HarshJain/bmsafe/Slave_v2/Livrables/FDR_presentation.pdf

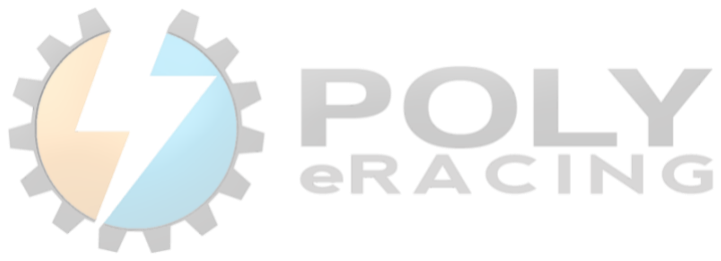
[picture p31: figure]

Raphaël Neveu
Responsable du BMS

## BMS SLAVE V2.0

RÉVISION DU DESIGN FINAL

SOMMAIRE

Fonctionnalités

Présentation du typon (layout) final

Interface Control Definition

Implémentation des fonctionnalités

Position du BMS sur les modules

Considérations générales d’implémentation

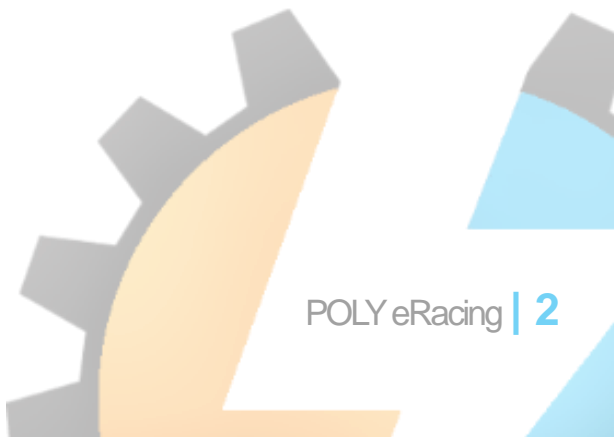
[picture p32: figure]
POLY eRacing | 2

FONCTIONNALITÉS

### - Mesure des températures - Mesure des tensions - Communication CAN - (Équilibration des cellules) - Signal ON/OFF - Alimentation du circuit - Isolation du BUS CAN

- Etc.

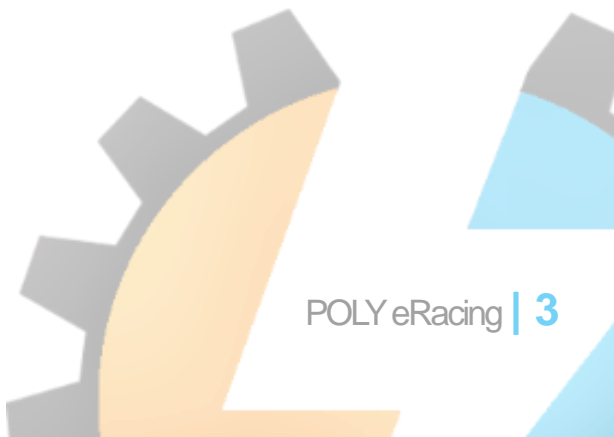
[picture p33: figure]
POLY eRacing | 3

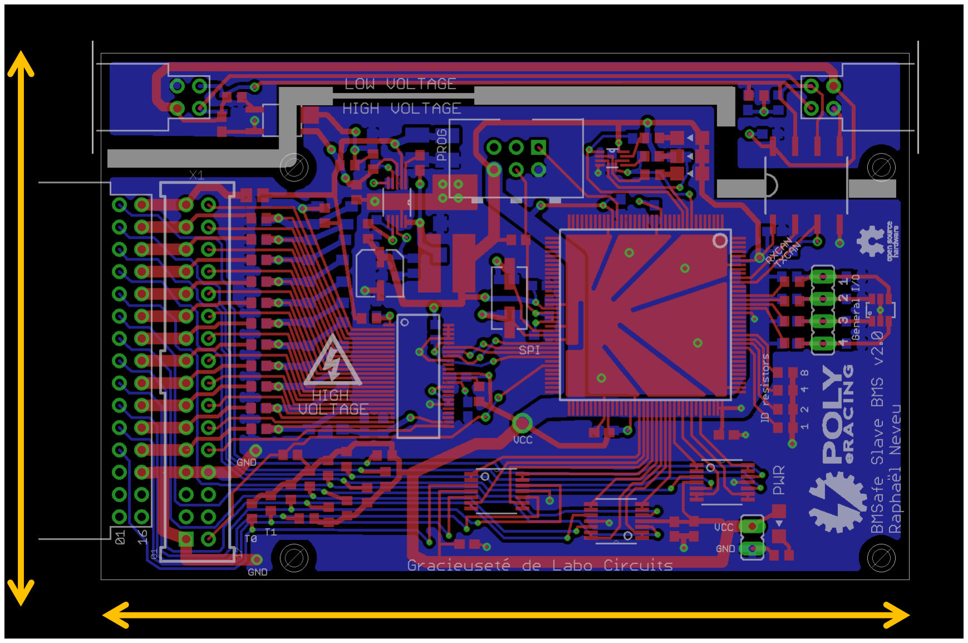
[picture p34: figure]

POLY eRacing | 4

LAYOUT

6 cm

9.22 cm

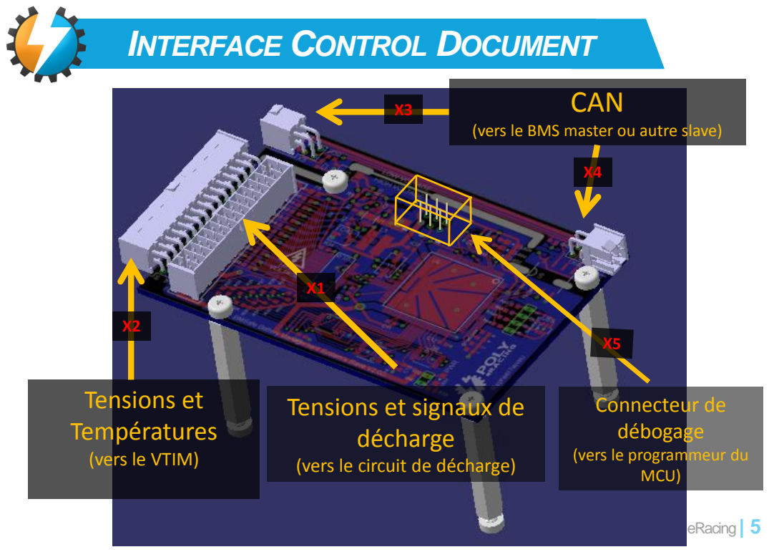
[picture p35: page 5]
POLY eRacing | 5; CAN; MCU)

INTERFACE CONTROL DOCUMENT

(vers le BMS master ou autre slave)

Tensions et
Températures
(vers le VTIM)

Tensions et signaux de
décharge

Connecteur de
débogage
(vers le programmeur du

(vers le circuit de décharge)

### IMPLÉMENTATION DES

### FONCTIONNALITÉS

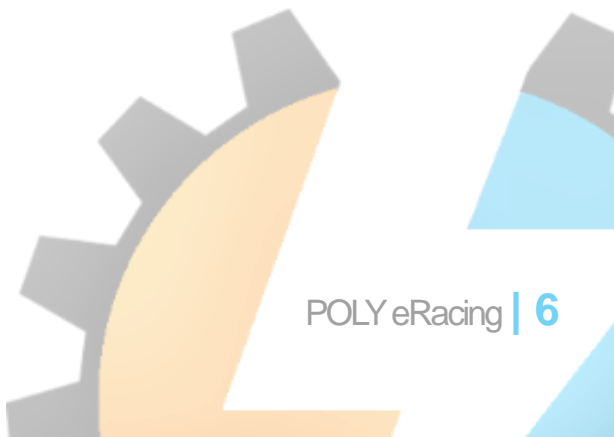
[picture p36: figure]
POLY eRacing | 6
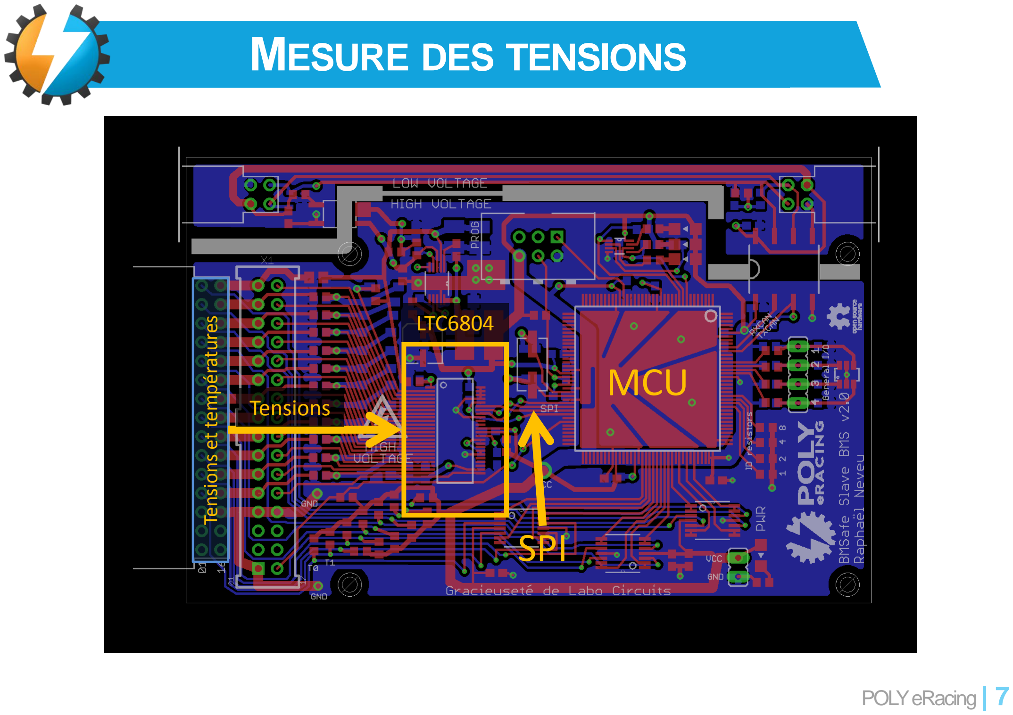
[picture p37: page 7]

POLY eRacing | 7

MESURE DES TENSIONS

SPI

MCU

Tensions et températures

Tensions

LTC6804

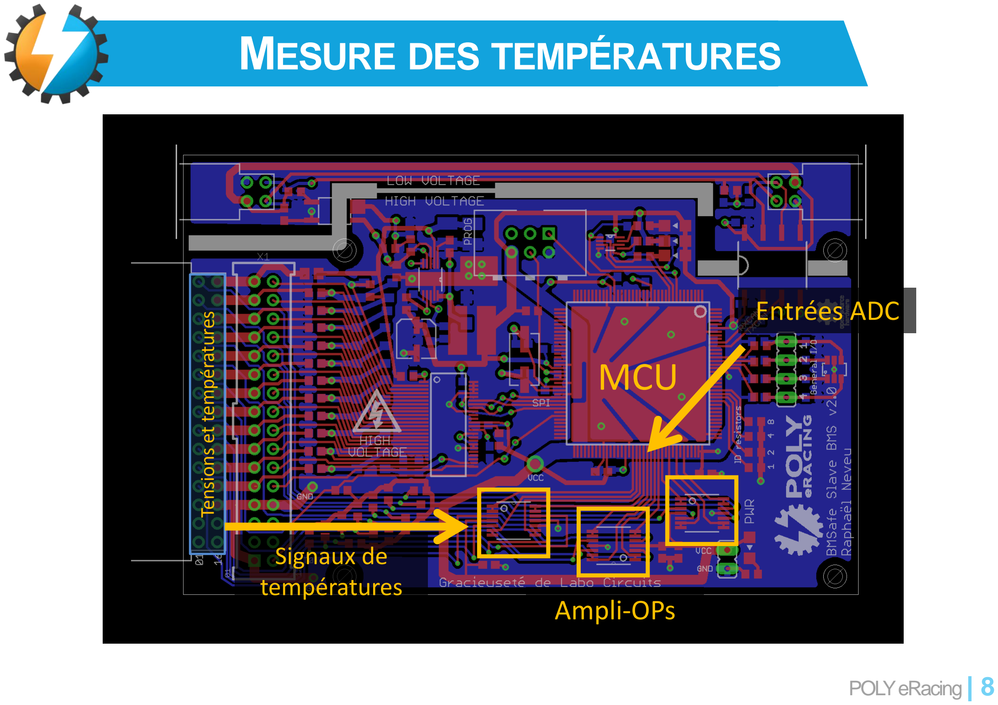
[picture p38: page 8]

POLY eRacing | 8

MESURE DES TEMPÉRATURES

Entrées ADC
MCU

Tensions et températures

Signaux de
températures
Ampli-OPs

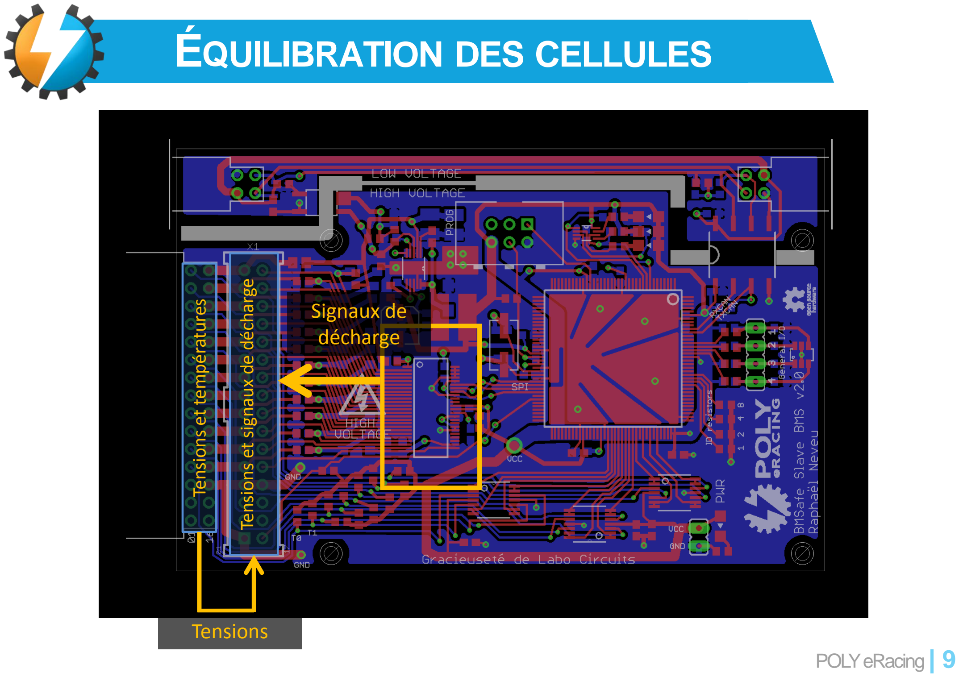
[picture p39: page 9]

POLY eRacing | 9

ÉQUILIBRATION DES CELLULES Tensions et températures Tensions et signaux de décharge

Signaux de
décharge

Tensions

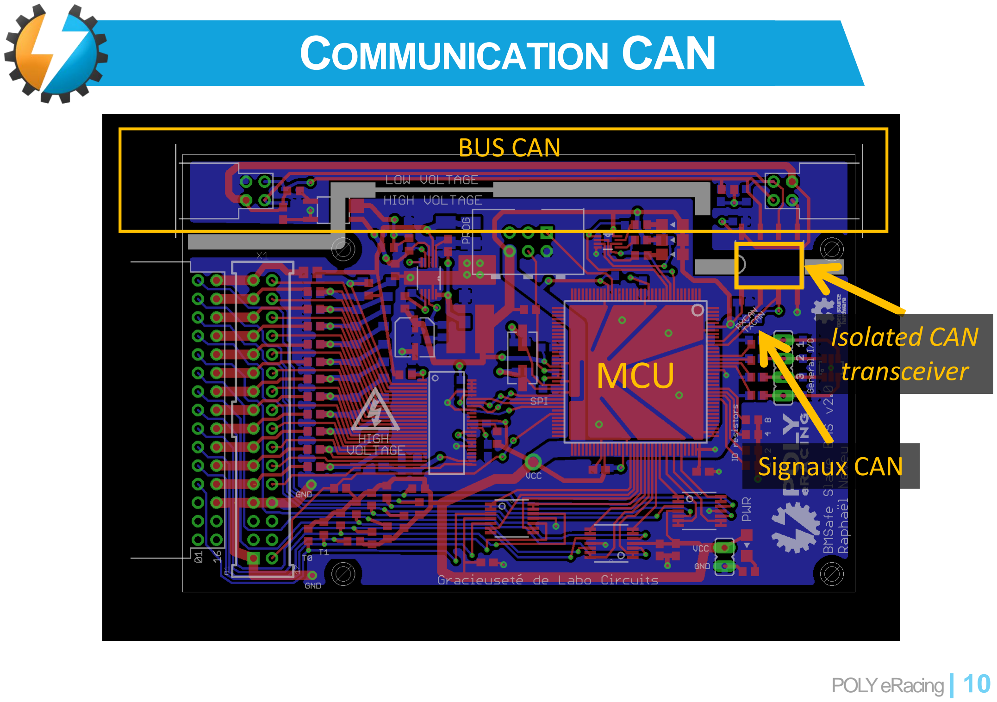
[picture p40: page 10]

POLY eRacing | 10

COMMUNICATION CAN

Signaux CAN

MCU

Isolated CAN
transceiver

BUS CAN

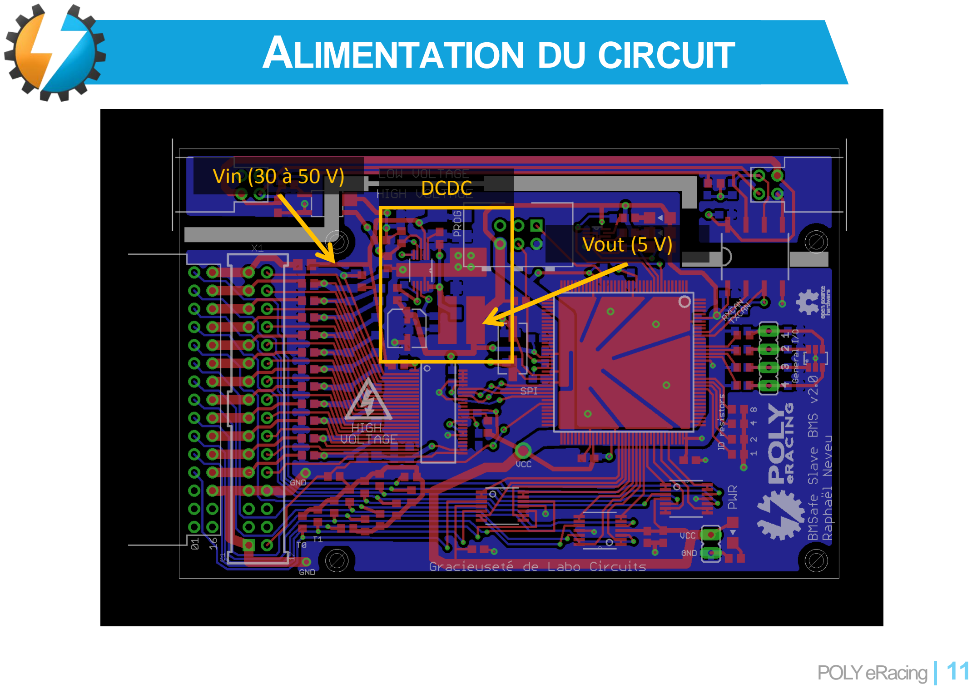
[picture p41: page 11]

POLY eRacing | 11

ALIMENTATION DU CIRCUIT

DCDC Vin (30 à 50 V)

Vout (5 V)

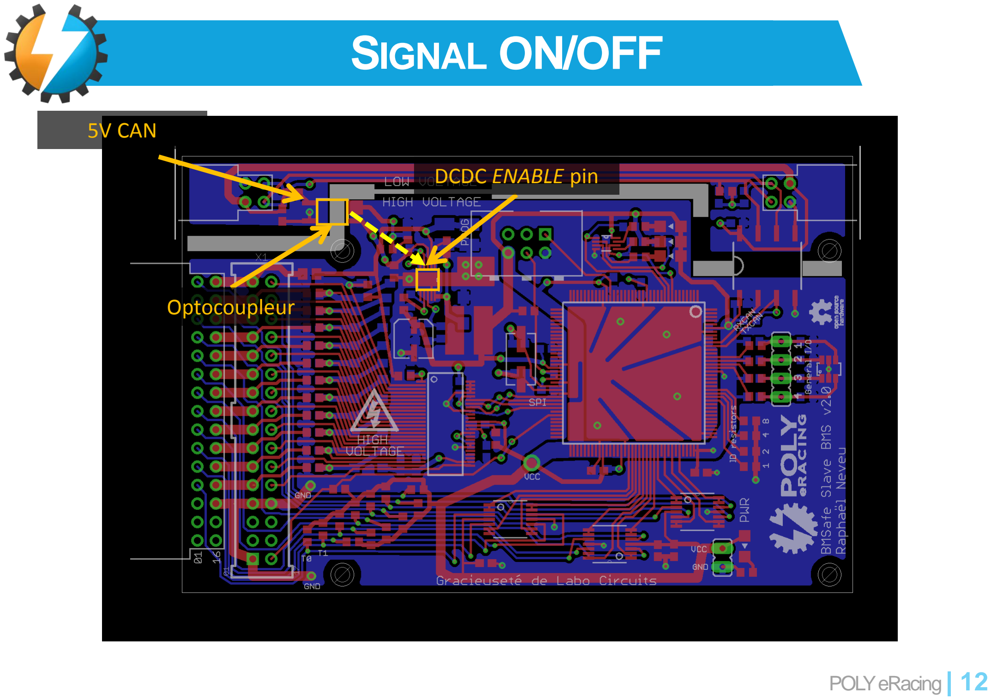
[picture p42: page 12]

POLY eRacing | 12

SIGNAL ON/OFF

Optocoupleur

DCDC ENABLE pin

5V CAN

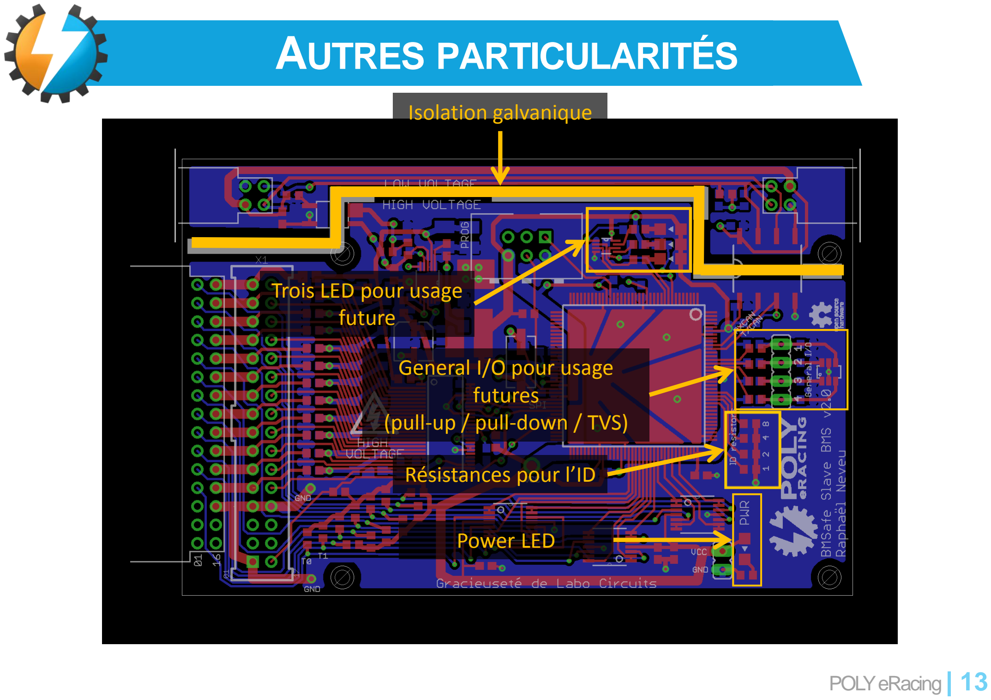
[picture p43: page 13]

POLY eRacing | 13

AUTRES PARTICULARITÉS

Isolation galvanique

General I/O pour usage
futures
(pull-up / pull-down / TVS)

Résistances pour l’ID

Trois LED pour usage
future

Power LED

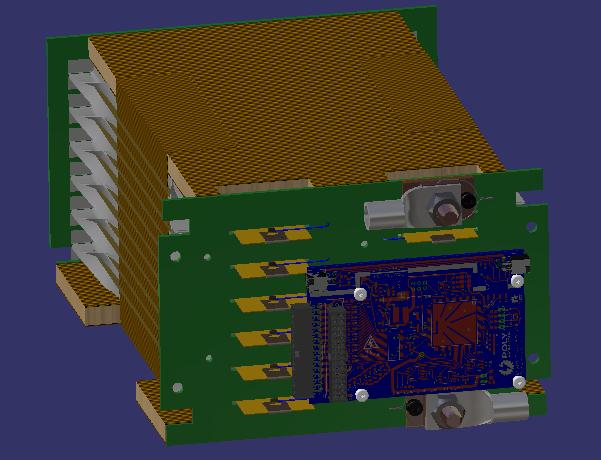
[picture p44: figure]

POLY eRacing | 14

POSITION DU BMS SLAVE

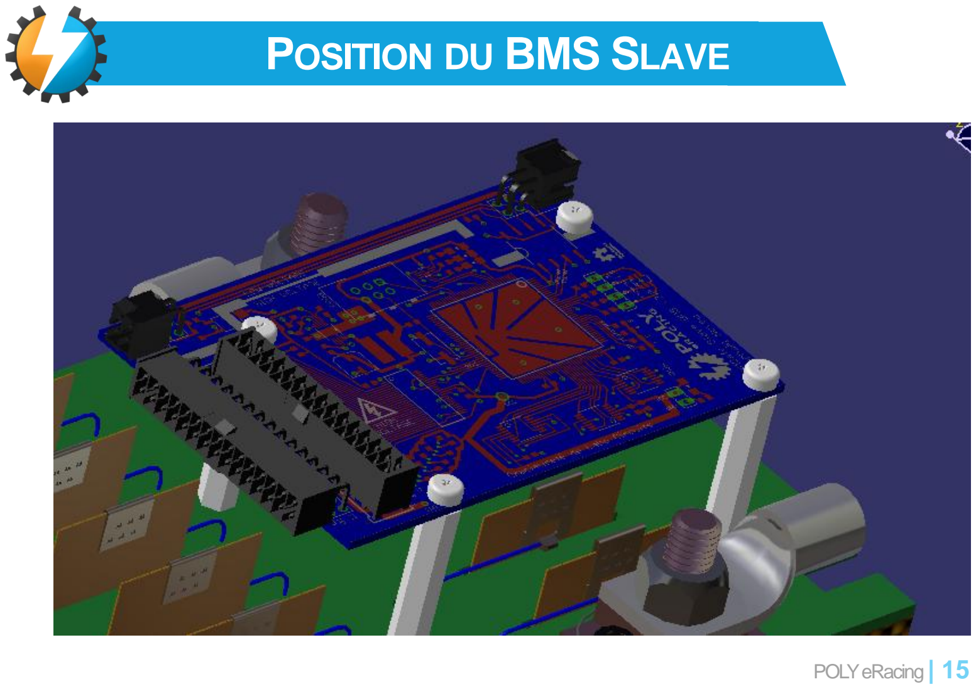
[picture p45: page 15]

POLY eRacing | 15

POSITION DU BMS SLAVE

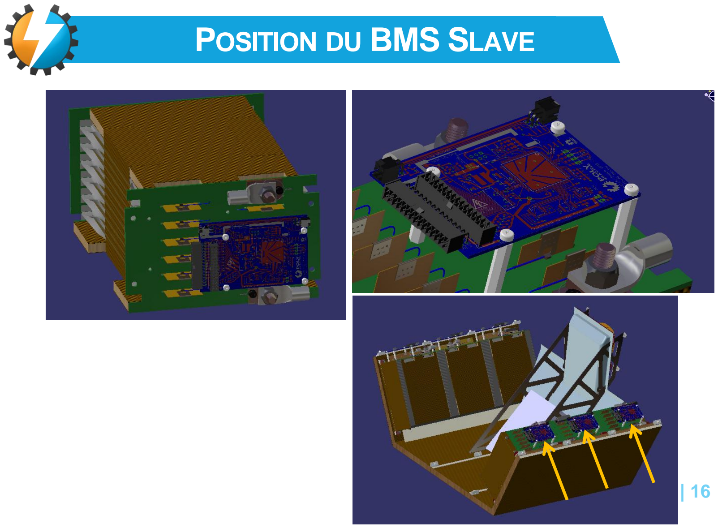
[picture p46: page 16]

POLY eRacing | 16

POSITION DU BMS SLAVE

POLY eRacing | 17

CONSIDÉRATIONS GÉNÉRALES D’IMPLÉMENTATION

- Découplage de l’alimentation des circuits intégrés
- GND plain en dessous du circuit
- Traces d’alimentation larges
- Indications des zones Hautes tension et Basse tension
- Traces à 45° le plus possible
- Circuits intégrés et d’autres composantes certifiées pour les utilisations en transport
- Plusieurs composantes à faible consommation pour limiter les pertes au niveau des cellules
- Connecteurs détrompeurs (keyed) et à verrouillage de la connexion (mating lock) certifiés 954 VDC

Adresse postale
C.P. 6079, succ. Centre-Ville Montréal (Québec) Canada H3C 3A7

www.eracing.polymtl.ca

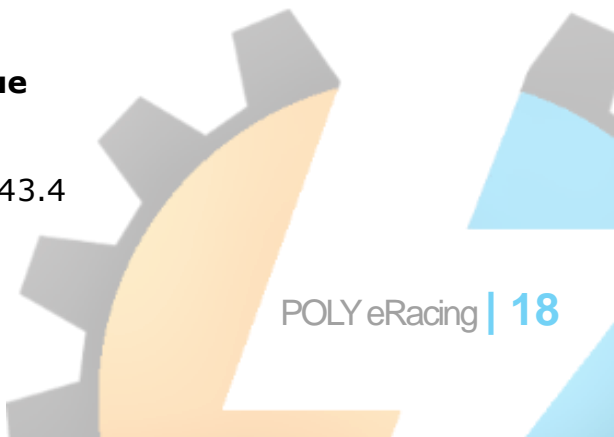
[picture p47: figure]
POLY eRacing | 18

POLY eRacing – Formule Électrique École Polytechnique de Montréal
2900, boul. Édouard-Montpetit
2500, ch. de Polytechnique, local A-343.4 Montréal (Québec) Canada H3T 1J4

Information générale
Téléphone : 514 340-4711, poste 2321 Courriel : info@eracing.polymtl.ca
