HarshJain/bmsafe/Slave_v2/pinout_reference_MCU.xlsx

Pin # | Name | Alias (in code) | User #Define | Descriptions | Configuration | In / Out
8 | PK2 | PORTK_PK2 |  | LED2 (vert) | Pull up | Output
9 | PK1 | PORTK_PK1 |  | LED3 (jaune) | Pull up | Output
10 | PK0 | PORTK_PK0 |  | LED4 (rouge) | Pull up | Output
25 | BKGD | PUCR_BKPUE | - | Pour le programmeur | -
54 | /Reset | - | - | Pour le programmeur | -
61 | /SS1 | PTH_PTH3 |  | Slave Select (SPI) | -
62 | SCK1 | PTH_PTH2 | - | Serial Clock (SPI) | -
63 | MOSI1 | PTH_PTH1 | - | Master In Slave Out (SPI) | -
64 | MISO1 | PTH_PTH0 | - | Master Out Slave In (SPI) | -
66 | PD1 | PORTD_PD1 |  | Discharge circuit connected signal | Pull up | Input
89 | AN00 |  |  | Température T0 | Analog to digital | Input
90 | AN08 |  |  | Température T1 | Analog to digital | Input
91 | AN01 |  |  | Température T2 | Analog to digital | Input
92 | AN09 |  |  | Température T3 | Analog to digital | Input
93 | AN02 |  |  | Température T4 | Analog to digital | Input
94 | AN10 |  |  | Température T5 | Analog to digital | Input
95 | AN03 |  |  | Température T6 | Analog to digital | Input
96 | AN11 |  |  | Température T7 | Analog to digital | Input
97 | AN04 |  |  | Température T8 | Analog to digital | Input
99 | AN05 |  |  | Température T9 | Analog to digital | Input
101 | AN06 |  |  | Température T10 | Analog to digital | Input
103 | AN07 |  |  | Température T11 | Analog to digital | Input
119 | PS0 | PTS_PTS0 |  | Slave ID bit 0 | Pull up | Input
120 | PS1 | PTS_PTS1 |  | Slave ID bit 1 | Pull up | Input
121 | PS2 | PTS_PTS2 |  | Slave ID bit 2 | Pull up | Input
122 | PS3 | PTS_PTS3 |  | Slave ID bit 3 | Pull up | Input
128 | PJ7 | PTJ_PTJ7 |  | General I/O 4 | -
129 | PJ6 | PTJ_PTJ6 |  | General I/O 3 | -
130 | PJ5 | PTJ_PTJ5 |  | General I/O 2 | -
131 | PJ4 | PTJ_PTJ4 |  | General I/O 1 | -
134 | TXCAN0 |  |  | TX CAN signal | -
135 | RXCAN0 |  |  | RX CAN signal | -
 | Régistres
 | ATD0CTL2_ADPU |  |  | ADC config :
 | ATD1CTL2_ADPU |  |  | ADC config :
 | ATD1DR1 |  |  | ADC1 donnée 1
 | ATD1DR0 |  |  | ADC1 donnée 0
