HarshJain/bmsafe/Slave_v2/Design_documents/AOP_comparison.xlsx

 | TL974 | OPA4376-Q1
Offset Voltage Drift (uV/°C) | 5 | 2
Offset Voltage (uV) | 4000 | 25
Noise Level (nV/sqrt(Hz)) | 4 | 7.5
Input bias current (nA) | 1000 | 0.01
Inpub offset current (nA) | 150 | 0.01
Supply current (per amplifier) (mA) | 2.8 | 1
Total harmonic distortion (THD) | 0.003% | 0.00027%
 | R-to-R | R-to-R +- 10mV
Max channel | 4 | 4
Package | TSSOP-14 | TSSOP-14
