HarshJain/bmsafe/Master_v2/Software/Documentation/Flowcharts/README.txt

Les fichiers *.graphml ont été créés et peuvent être édités avec yEd (logiciel de diagrammes gratuit).
