HarshJain/bmsafe/BoiteBatteries/cellule.png

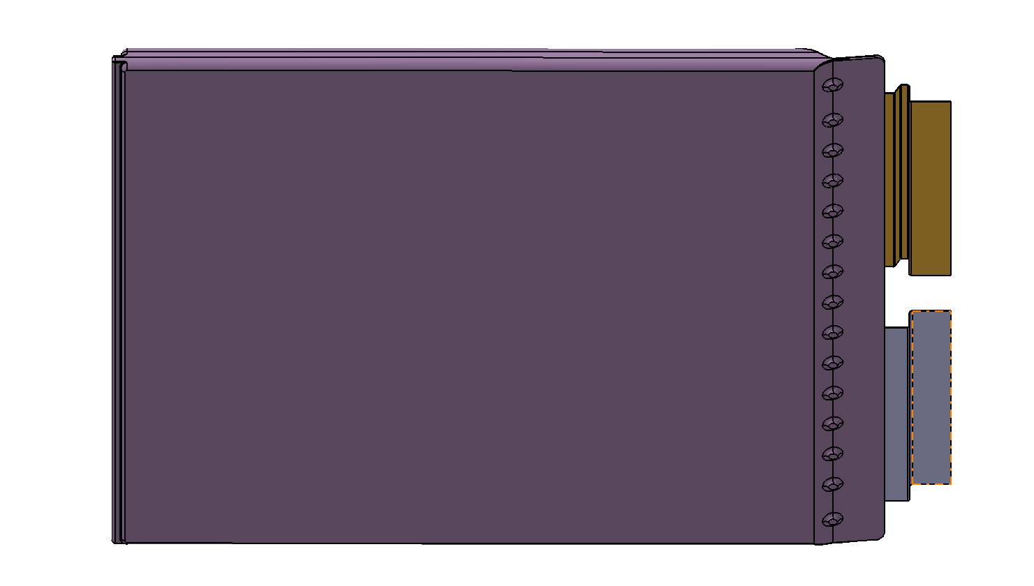
BoiteBatteries/cellule.png
