HarshJain/bmsafe/BoiteBatteries/Drawings/Boite batteries.jpg

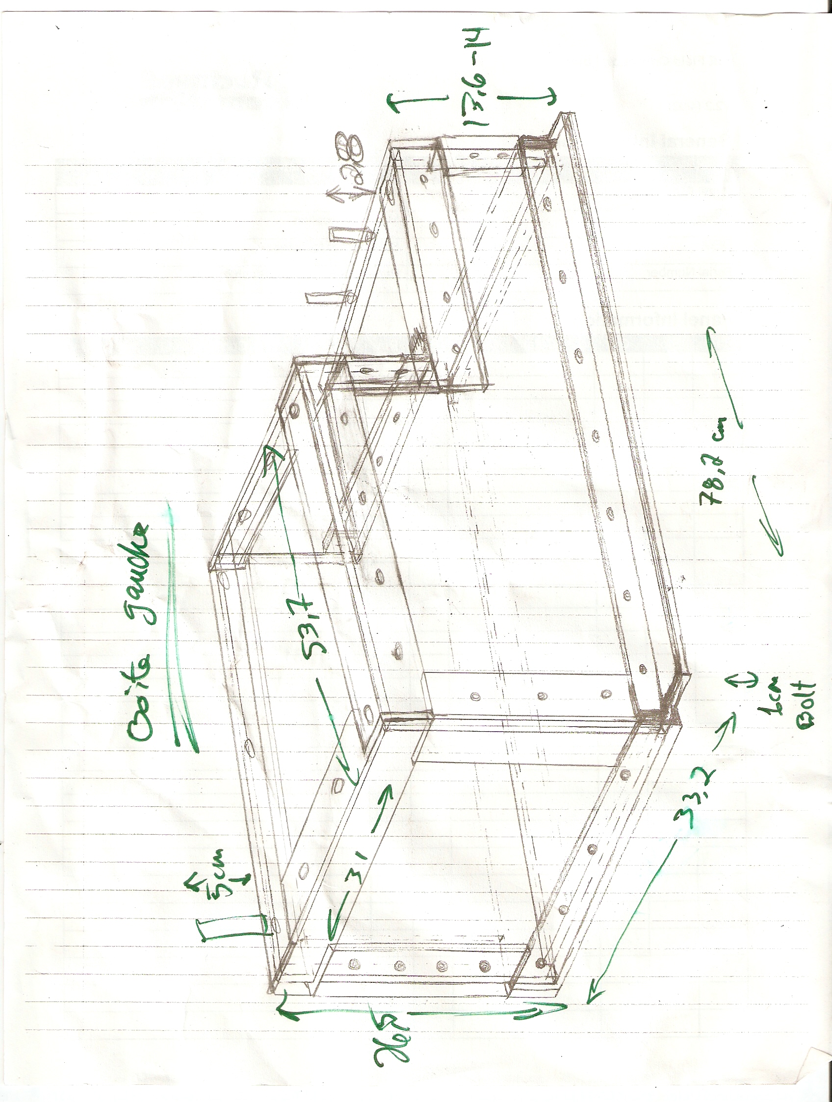
BoiteBatteries/Drawings/Boite batteries.jpg
