HarshJain/bmsafe/Master_v2/PCB/BMSafeMasterv2_PCB.png

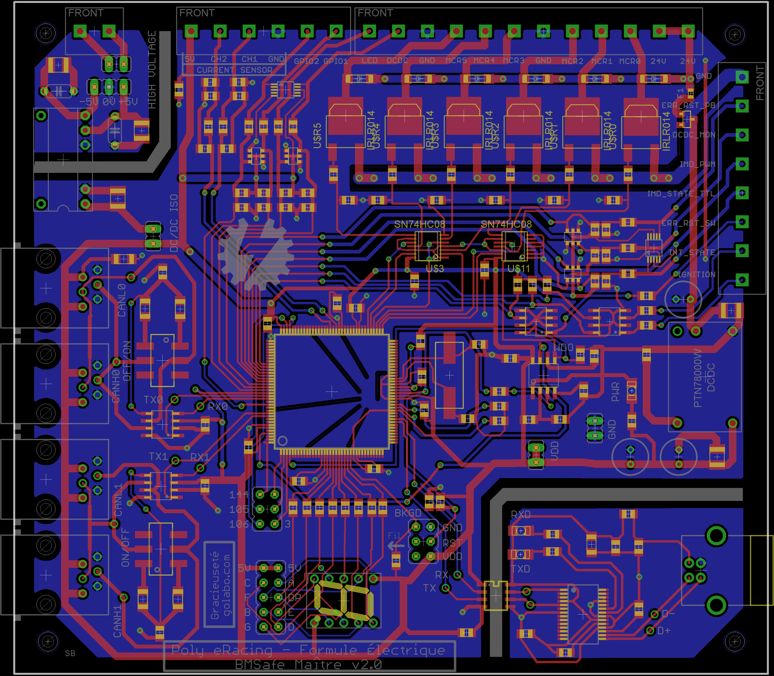
Master_v2/PCB/BMSafeMasterv2_PCB.png
