HarshJain/bmsafe/Master_v2/PCB/BMSafeMasterv2_SCH.png

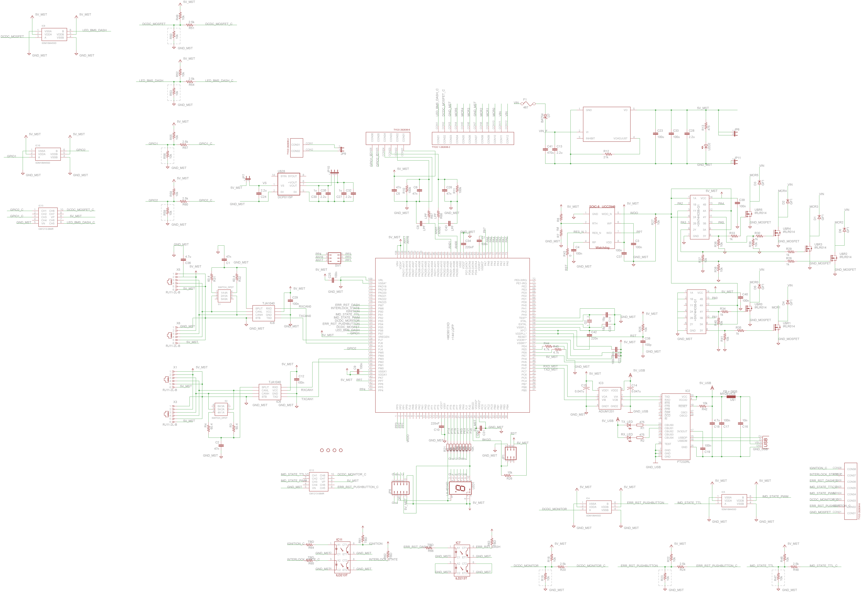
Master_v2/PCB/BMSafeMasterv2_SCH.png
