HarshJain/bmsafe/Master_v2/PCB/eagleUp/eagleUp_BMSafeMasterV2_bottom.png

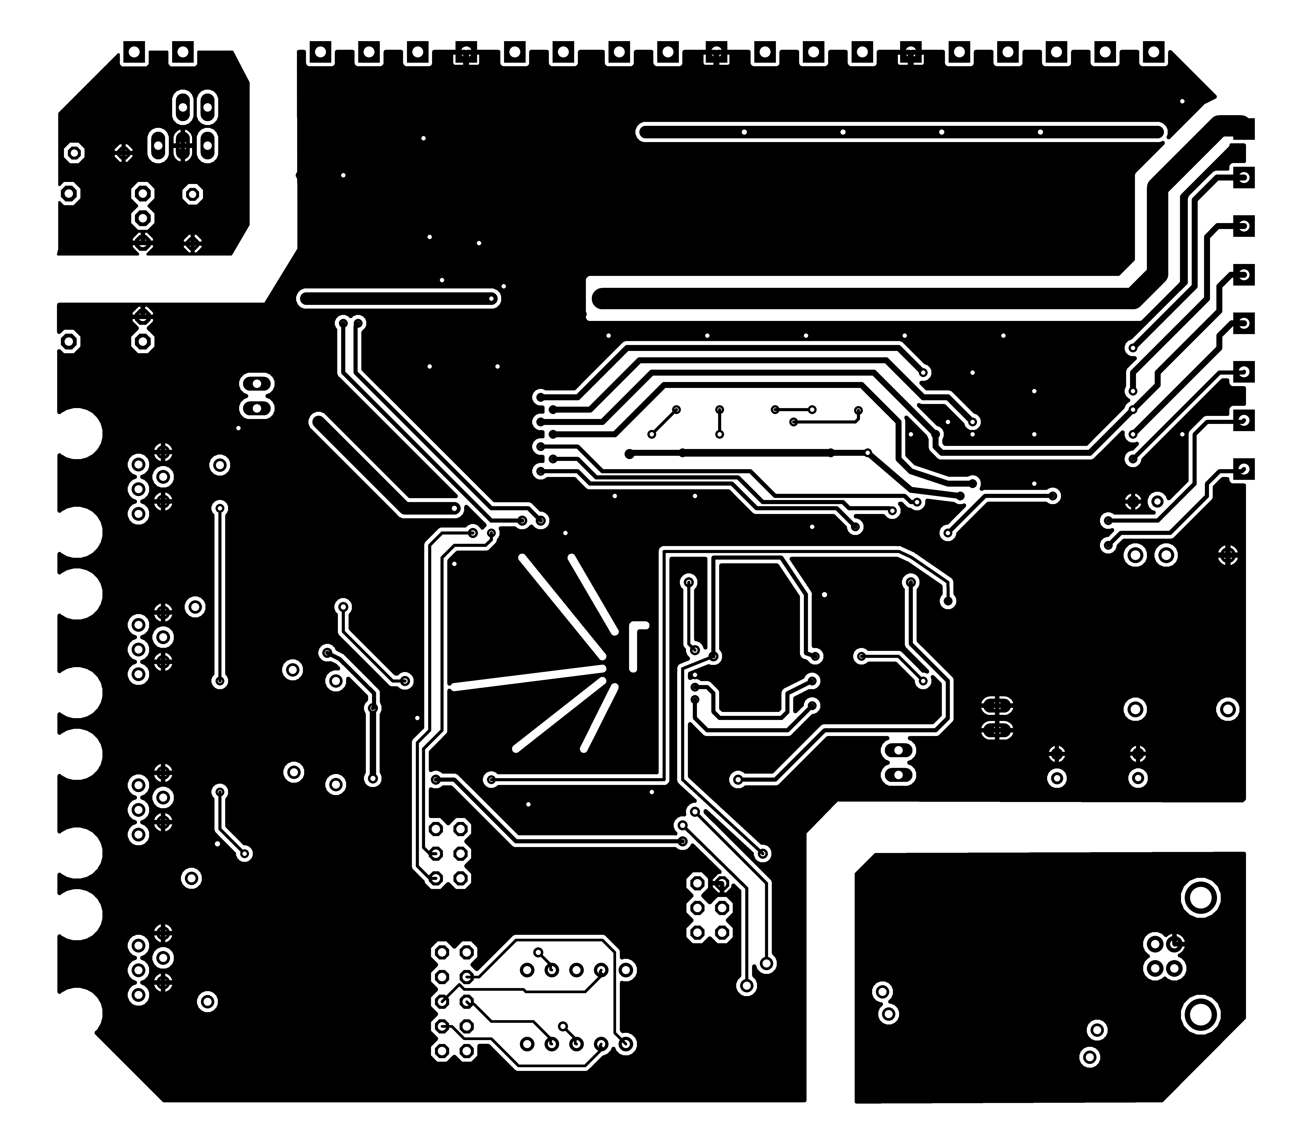
Master_v2/PCB/eagleUp/eagleUp_BMSafeMasterV2_bottom.png
