HarshJain/bmsafe/Master_v2/PCB/eagleUp/eagleUp_BMSafeMasterV2_top_silk.png

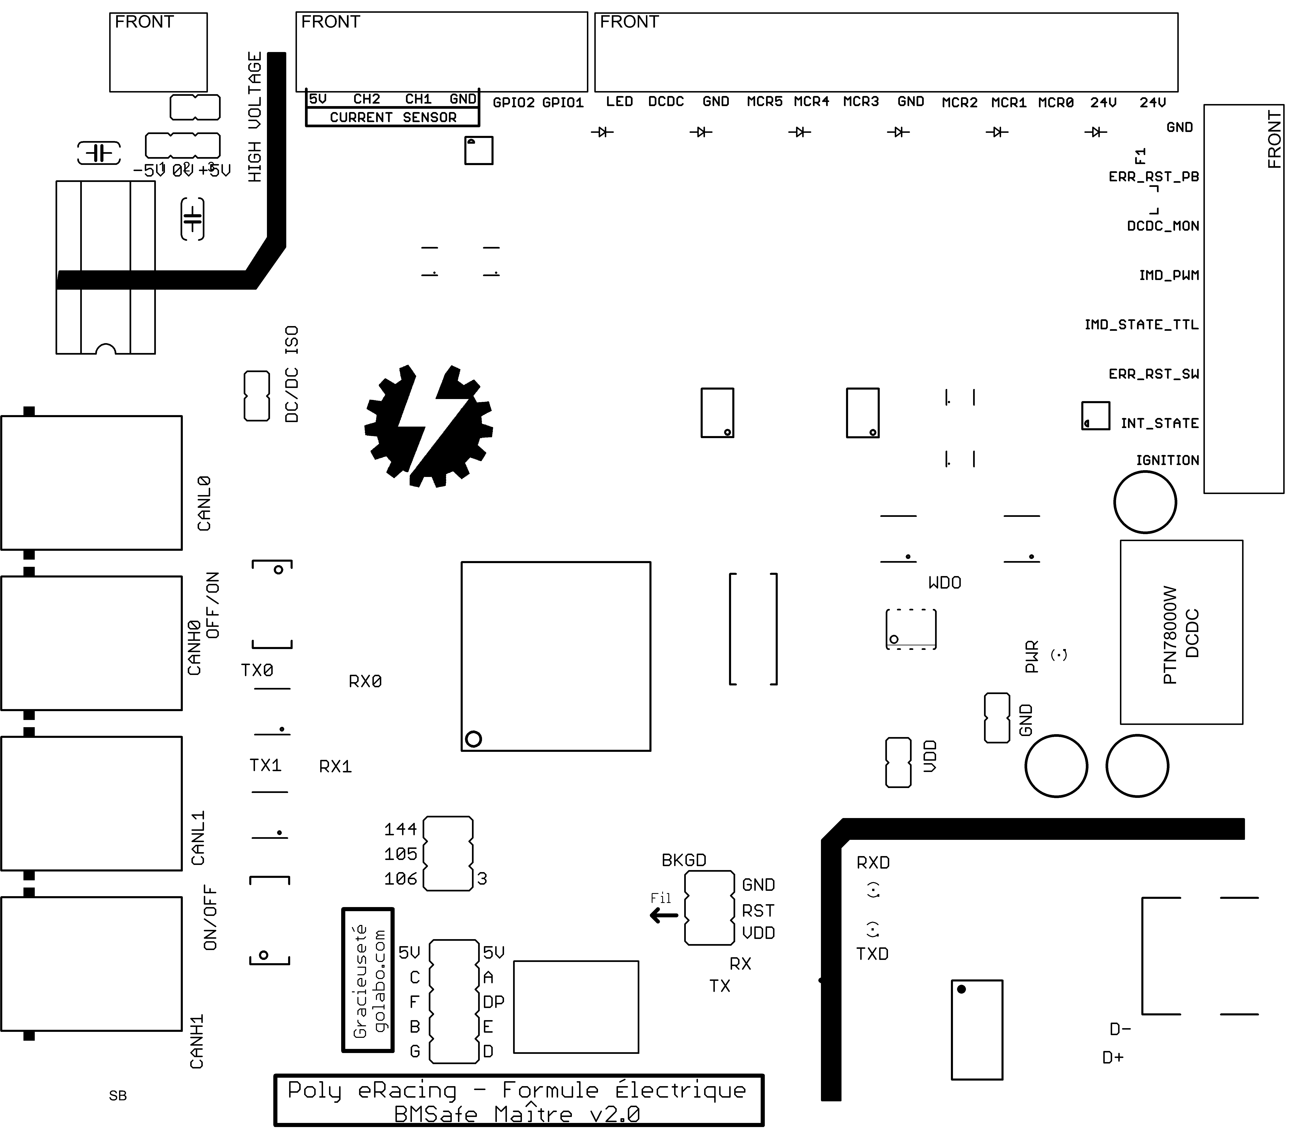
Master_v2/PCB/eagleUp/eagleUp_BMSafeMasterV2_top_silk.png
