HarshJain/bmsafe/Slave_v2/EaglePCB/images/BMS_Slave2.1_board.png

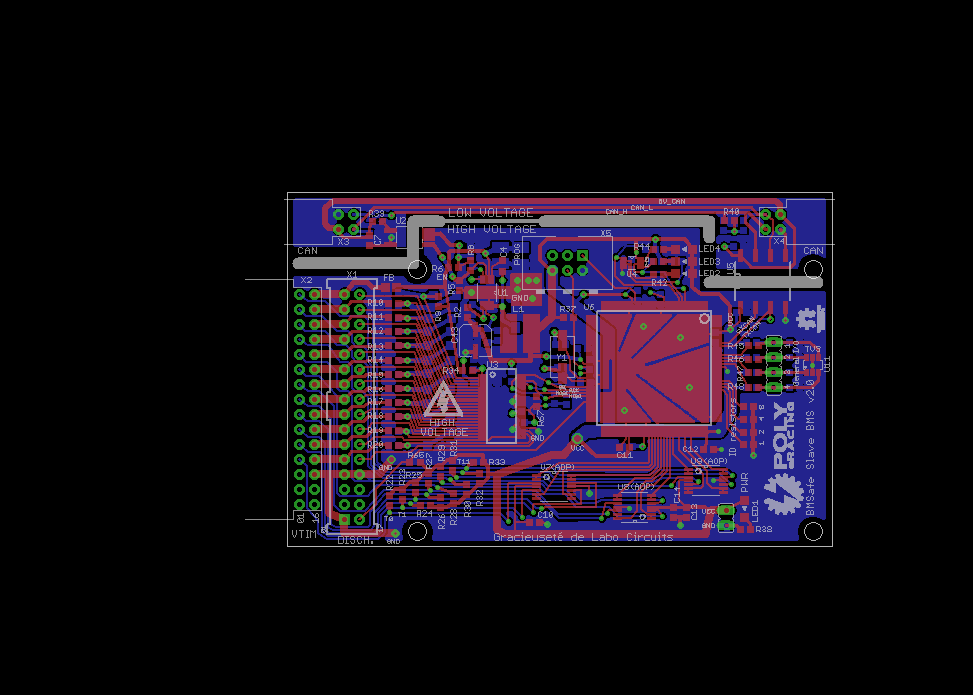
Slave_v2/EaglePCB/images/BMS_Slave2.1_board.png
