HarshJain/bmsafe/Slave_v2/EaglePCB/images/BSM_Slave_Board_Bottom.png

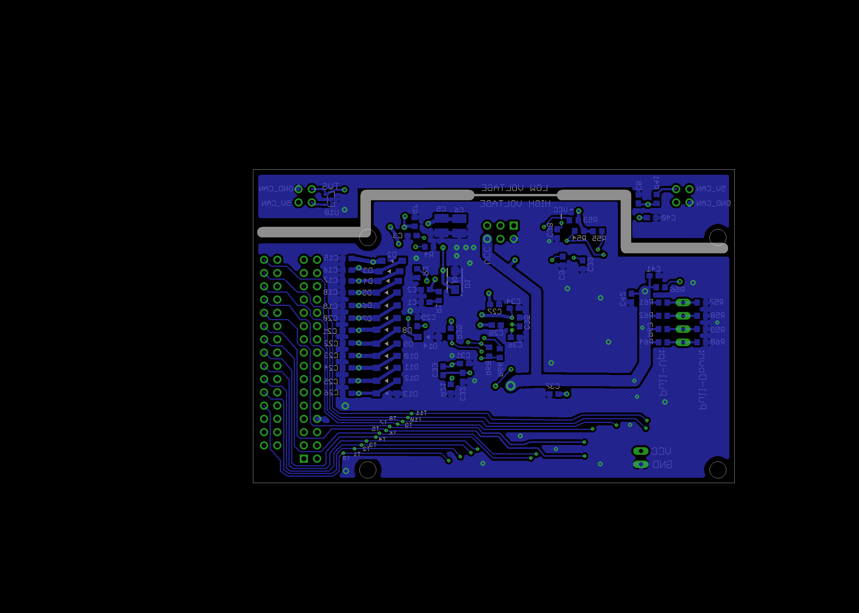
Slave_v2/EaglePCB/images/BSM_Slave_Board_Bottom.png
