HarshJain/bmsafe/Slave_v2/EaglePCB/images/BSM_Slave_Board_Top.png

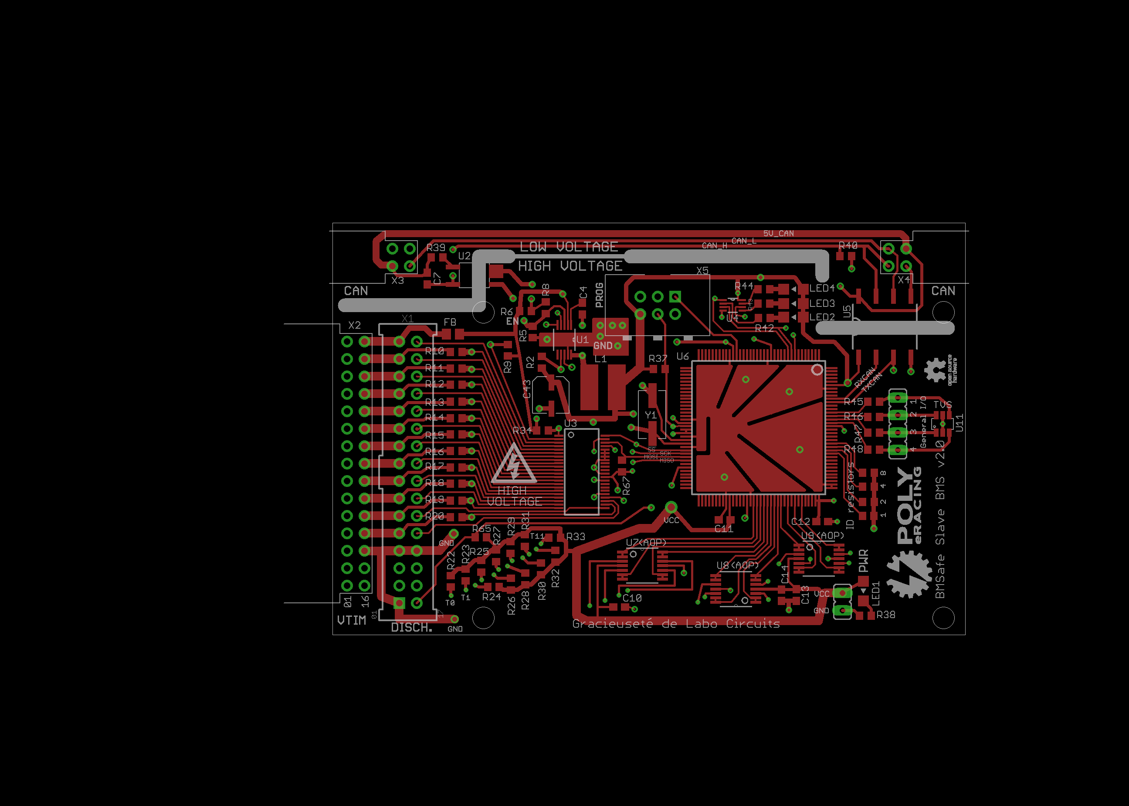
Slave_v2/EaglePCB/images/BSM_Slave_Board_Top.png
