HarshJain/bmsafe/Slave_v2/EaglePCB/images/BSM_Slave_Board_traces.png

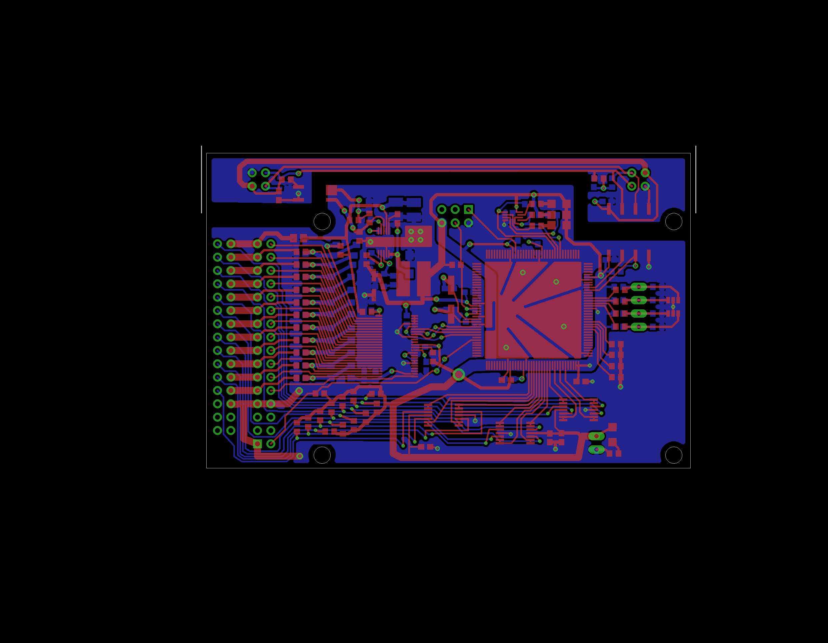
Slave_v2/EaglePCB/images/BSM_Slave_Board_traces.png
