HarshJain/bmsafe/Master_v2/PCB/BOM/bom-ex150/bom-ex_setup.txt

1. Copier bom-ex.ulp dans eagle\ulp
2. Assigner une touche (ex.: ctrl-B) à 'RUN bom-ex.ulp'
