HarshJain/bmsafe/Slave_v2/EaglePCB/BOM_slave.xlsx

Sheet: Sheet1
Package custom
Vérifié + à commander |  |  |  | Facultatif ou variable : (REF)
Ne pas assembler |  |  |  | * même modèle avec un autre tag
Commandite
 |  |  |  |  |  |  |  |  |  |  | MQR : minimum quantity |  | 7 PCB
Référence | Do Not Place | Tag | Quantité (par esclave) | Numéro manufacturier | Value | Description | Supplier | Package | Prix Commande | Prix ($) | Commentaires | Lien | Total Qty | Qty Received | Received From | Qty to be ordered
U1 |  | DCDC | 1 | TPS57060-Q1 | - | Régulateur de tension | TI | MSOP10 (+PowerPAD) | 5.03 | 5.03 | Automotive | http://www.ti.com/product/tps57060-q1 | 7 | 3 | TI | 4
U2 |  | DCDC | 1 | ACPL-M49T | - | Optocoupleur | Newark | SO-5 | 4.76 | 4.76 | Automotive | http://www.digikey.ca/product-detail/en/ACPL-M49T-500E/516-2908-1-ND/4240249 | 7 |  |  | 7
C1 |  | DCDC | 1 | GRM1885C1H242JA01D | 2.4 nF | Condensateur céramique | Digi-Key | 0603 | 0.16 | 0.16 | 50V, +-5% (Ccomp) | http://www.digikey.com/product-detail/en/GRM1885C1H242JA01D/490-3282-1-ND/702823 | 7 |  |  | 7
C2 |  | DCDC | 1 | CGA3E2C0G1H070D080AA | 7 pF | Condensateur céramique | Digi-Key | 0603 | 0.10 | 0.10 | Automotive, 50V (Ccomp2) | http://www.digikey.com/product-detail/en/CGA3E2C0G1H070D080AA/445-5625-1-ND/2443665 | 7 |  |  | 7
C3 |  | DCDC | 1 | CGA3E2X7R1H103K080AD | 10 nF | Condensateur céramique | Digi-Key | 0603 | 0.29 | 0.29 | Automotive, 50V (Css) | http://www.digikey.ca/product-detail/en/CGA3E2X7R1H103K080AD/445-8834-1-ND/3248249 | 7 |  |  | 7
C5,C6 |  | DCDC | 2 | CGA6N3X7R2A225K230AB | 2.2 uF | Condensateur découplage, X7R | Digi-Key | 1210 (3225 Metric) | 2.84 | 1.42 | Automotive, 100 V (Cin) | http://www.digikey.ca/product-detail/en/CGA6N3X7R2A225K230AB/445-5866-1-ND/2443906 | 14 |  |  | 14
C43 |  | DCDC | 1 | APXE100ARA470ME61G | 47 uF | Condensateur électrolytique, découplage | Digi-Key | ~=E61 | 1.30 | 1.30 | 10V (Cout) | http://www.digikey.com/product-detail/en/APXE100ARA470ME61G/565-3197-1-ND/1826737 | 7 |  |  | 7
L1 |  | DCDC | 1 | VLP8040T-101M | 100 uH | Bobine | Digi-Key | Non Standard | 0.72 | 0.72 | +- 20%, 1 A, 330 mOhms | http://www.digikey.com/product-detail/en/VLP8040T-101M/445-6571-1-ND/2465878 | 7 |  |  | 7
FB |  | DCDC | 1 | MPZ2012S300A | - | Ferrite | Digi-Key | 0805 | 0.12 | 0.12 |  | http://www.digikey.com/product-detail/en/MPZ2012S300A/445-1566-1-ND/571896 | 7 |  |  | 7
D1 |  | DCDC | 1 | BYS12-90-E3/TR | - | Schottky diode | Mouser | DO-214AC | 0.58 | 0.58 |  | http://www.digikey.com/product-detail/en/BYS12-90-E3%2FTR/BYS12-90-E3%2FGICT-ND/2880301 | 7 |  |  | 7
R3 |  | DCDC* | 1 | CRCW060310K0FKEA | 10 kOhms | Résistance 1%, 1/8W | Digi-Key | 0603 | 0.081 | 0.081 | Automotive, MQ : 10 | http://www.digikey.com/product-detail/en/CRCW060310K0FKEA/541-10.0KHCT-ND/1179924 | 7 |  |  | 7
R2, R65 |  | DCDC | 2 | CRCW060353K6FKEA | 53.6 kOhms | Résistance 1%, 1/10 W | Digi-Key | 0603 | 0.162 | 0.081 | Automotive, MQ : 10 | http://www.digikey.com/product-detail/en/CRCW060353K6FKEA/541-53.6KHCT-ND/1180007 | 14 |  |  | 14
R1 |  | DCDC | 1 | CRCW0603191KFKEA | 191 kOhms | Résistance 1%, 1/10 W | Digi-Key | 0603 | 0.081 | 0.081 | Automotive, MQ : 10 | http://www.digikey.com/product-detail/en/CRCW0603191KFKEA/541-191KHCT-ND/1180068 | 7 |  |  | 7
R4 |  | DCDC | 1 | CRCW0603374KFKEA | 374 kOhms | Résistance 1%, 1/10 W | Digi-Key | 0603 | 0.081 | 0.081 | Automotive, MQ : 10 | http://www.digikey.com/product-detail/en/CRCW0603374KFKEA/541-374KHCT-ND/1180102 | 7 |  |  | 7
R5 |  | DCDC | 1 | CRCW060320K0FKEA | 20 kOhms | Résistance EN | Digi-Key | 0603 | 0.04 | 0.04 | Automotive, MQ : 10 | http://www.digikey.com/product-detail/en/CRCW060320K0FKEA/541-20.0KHCT-ND/1179956 | 7 |  |  | 7
R6 |  | DCDC | 1 | CRCW0603150KFKEA | 150 kOhms | Résistance EN | Digi-Key | 0603 | 0.081 | 0.081 | Automotive, MQ : 10 | http://www.digikey.com/product-detail/en/CRCW0603150KFKEA/541-150KHCT-ND/1180056 | 7 |  |  | 7
R7 |  | DCDC | 1 | CRCW060375K0FKEA | 75 kOhms | Résistance EN | Digi-Key | 0603 | 0.081 | 0.081 | Automotive, MQ : 10 | http://www.digikey.com/product-detail/en/CRCW060375K0FKEA/541-75.0KHCT-ND/1180024 | 7 |  |  | 7
(R8) | x | DCDC* | 1 | RMCF0603ZT0R00 | 0 Ohms | Bypass pour activer le DCDC | Digi-Key | 0603 | 0 | 0.02 | Même que R36 | http://www.digikey.com/product-detail/en/RMCF0603ZT0R00/RMCF0603ZT0R00CT-ND/1943218 | 7 |  |  | 7
U4 |  | MCU | 1 | SN74LVC3G07-Q1 | - | Tripple buffer / driver (open collector) | TI | US8 (DCU) | 0.70 | 0.70 |  | http://www.ti.com/product/sn74lvc3g07-q1 | 7 | 3 | TI | 4
U6 |  | MCU | 1 | MC9S12XDP512MAG | - | Micro-contrôleur | Freescale | 144pin LQFP | 0 | 0 |  | http://www.digikey.ca/product-detail/en/MC9S12XDP512MAG/MC9S12XDP512MAG-ND/1167901 | 7 | 7 | Freescale | 0
C27-C28 |  | MCU | 2 | CC0603JRNPO9BN200 | 20 pF | Condensateur du crystal | Digi-Key | 0603 | 0.22 | 0.11 |  | http://www.digikey.ca/product-detail/en/CC0603JRNPO9BN200/311-1424-1-ND/2833730 | 14 |  |  | 14
C35 |  | MCU | 1 | CGA3E2C0G1H101J080AA | 100 pF | Condensateur RESET (programmeur) | Digi-Key | 0603 | 0.12 | 0.12 | Automotive, 50V, 5% | http://www.digikey.ca/product-detail/en/CGA3E2C0G1H101J080AA/445-5640-1-ND/2443680 | 7 |  |  | 7
C36,C37,C39 |  | MCU | 3 | CGA3E3X7R1V224K080AB | 220 nF | Condensateur céramique | Digi-Key | 0603 | 0.75 | 0.25 | Automotive 35V | http://www.digikey.ca/product-detail/en/CGA3E3X7R1V224K080AB/445-12551-1-ND/3954217 | 21 |  |  | 21
R38,R42-R44 |  | MCU | 4 | RMCF0603JT470R | 470 Ohms | Résistance série (pour LED1-4) | Digi-Key | 0603 | 0.12 | 0.03 |  | http://www.digikey.ca/product-detail/en/RMCF0603JT470R/RMCF0603JT470RCT-ND/1943166 | 28 |  |  | 28
R37,R53-R56 |  | MCU* | 5 | MCR03ERTJ103 | 10 kOhms | Pull up pour les LED drivers | Digi-Key | 0603 | 0.085 | 0.017 |  | http://www.digikey.com/product-detail/en/CRCW060310K0FKEA/541-10.0KHCT-ND/1179924 | 35 |  |  | 35
(R49-R52) | x | MCU* | 4 | MCR03ERTJ102 | 1 kOhms | Résistances pour l'ID des slaves | Digi-Key | 0603 | 0.034 | 0.017 |  | http://www.digikey.ca/product-detail/en/RMCF0603JT1K00/RMCF0603JT1K00CT-ND/1943173 | 28 |  |  | 28
LED3 |  | MCU | 1 | APT3216YC | - | LED jaune | Digi-Key | 1206 | 0.24 | 0.24 | 20 mA | http://www.digikey.com/product-detail/en/LTST-C150KSKT/160-1406-6-ND/1888639 | 7 |  |  | 7
LED4 |  | MCU | 1 | LH N974-KN-1 | - | LED rouge | Digi-Key | 1206 | 0.13 | 0.13 | 20 mA | http://www.digikey.ca/product-detail/en/LTST-C150KRKT/160-1405-1-ND/386760 | 7 |  |  | 7
LED1, LED2 |  | MCU / Autre | 2 | LG N971-KN-1 | - | LED verte | Digi-Key | 1206 | 0.26 | 0.13 | 20 mA | http://www.digikey.com/product-detail/en/LTST-C150KGKT/160-1404-6-ND/1835220 | 14 |  |  | 14
Y1 |  | MCU | 1 | ECS-160-20-3X-EN-TR | 16 MHz | Crystal | Digi-Key | HC49 | 0.72 | 0.72 |  | http://www.digikey.ca/product-detail/en/ECS-160-20-3X-EN-TR/XC1793CT-ND/2676657 | 7 |  |  | 7
U5 |  | CAN | 1 | ISO1050 | - | Isolated CAN Transceiver | Digi-Key | SOP-8 | 5.93 | 5.93 |  | http://www.digikey.ca/product-detail/en/ISO1050DUBR/296-24818-1-ND/2094658 | 7 | 2 | TI | 5
U10 |  | CAN | 1 | ESDCAN24-2BLY | - | Protection TVS/ESD pour le CAN | Digi-Key | SOT23 | 0.69 | 0.69 |  | http://www.digikey.ca/product-detail/en/ESDCAN24-2BLY/497-13262-1-ND/3661760 | 7 |  |  | 7
C7 |  | CAN | 1 | C1608X5R1A106M080AC | 10 uF | Condensateur optocoupleur | Digi-Key | 0603 | 0.53 | 0.53 |  | http://www.digikey.ca/product-detail/en/C1608X5R1A106M080AC/445-6853-1-ND/2619215 | 7 |  |  | 7
C8 |  | CAN | 1 | CC0603KRX7R8BB473 | 47 nF | Condensateur bus CAN | Digi-Key | 0603 | 0.11 | 0.11 | Terminaison bus CAN | http://www.digikey.ca/product-detail/en/CGA3E2X5R1H473K080AA/445-12494-1-ND/3954160 | 7 |  |  | 7
R39 |  | CAN* | 1 | CRCW060310K0FKEA | 10 kOhms | Résistance Optocoupleur | Digi-Key | 0603 | 0.081 | 0.081 | Automotive, MQ : 10 | http://www.digikey.com/product-detail/en/CRCW060310K0FKEA/541-10.0KHCT-ND/1179924 | 7 |  |  | 7
(R40,R41) | x | CAN | 2 | RC1608F60R4CS | 60.4 Ohms | Résistances de terminaison du bus CAN | Digi-Key | 0603 | 0.13 | 0.13 |  | http://www.digikey.ca/product-detail/en/RC1608F60R4CS/1276-4547-1-ND/3967519 | 14 |  |  | 14
U3 |  | Tensions | 1 | LTC6803-4 | - | Puce de mesure des tensions | Linear | SSOP-48 | 23.9 | 23.9 |  | http://www.linear.com/product/LTC6803-2 | 7 | 10 | Linear | -3
C31-C33 |  | Tensions | 3 | CGA3E1X7R1C105K080AC | 1 uF | Condensateur céramique, découplage | Digi-Key | 0603 | 0.42 | 0.14 | Automotive, 16V | http://www.digikey.ca/product-detail/en/CGA3E1X7R1C105K080AC/445-12539-1-ND/3954205 | 21 |  |  | 21
R9-R21,R34 |  | Tensions | 14 | RNCP0603FTD100R | 100 Ohms | Résistance série, filtre tensions, 1%, 1/8 W | Digi-Key | 0603 | 0.7 | 0.05 |  | http://www.digikey.com/product-detail/en/RNCP0603FTD100R/RNCP0603FTD100RCT-ND/2240425 | 98 |  |  | 98
R35 |  | Tensions* | 1 | RMCF0603JT1K00 | 1 kOhms | Résistance pull up sur SDO (MISO) | Digi-Key | 0603 | 0.03 | 0.03 |  | http://www.digikey.ca/product-detail/en/RMCF0603JT1K00/RMCF0603JT1K00CT-ND/1943173 | 7 |  |  | 7
R66-R68 |  | Tensions | 3 | RMCF0603JT1M00 | 1 MOhms | Pull up sur MOSI,SCK,SS | Digi-Key | 0603 | 0.09 | 0.03 |  | http://www.digikey.ca/product-detail/en/RMCF0603JT1M00/RMCF0603JT1M00CT-ND/1943210 | 21 |  |  | 21
D2-D13 |  | Tensions | 11 | DDZ7V5C-7 | 7.5 V | Diode zener | Digi-Key | SOD-123 | 4.95 | 0.45 | Faible courant de fuite : 100 nA | http://www.digikey.ca/product-detail/en/DDZ7V5C-7/DDZ7V5CDICT-ND/700171 | 77 |  |  | 77
D14 |  | Tensions | 1 | MMSZ5265BT1G | 62 V | Diode zener | Digi-Key | SOD-123 | 0.29 | 0.29 | Faible courant de fuite : 100 nA | http://www.digikey.ca/product-detail/en/MMSZ5265BT1G/MMSZ5265BT1GOSCT-ND/2705144 | 7 |  |  | 7
U7-U9 |  | Températures | 3 | OPA4376 | - | Ampli-OP suiveurs | Digi-Key | TSSOP-14 | 12.42 | 4.14 | Automotive |  | 21 | 3 | TI | 18
R22-R33 |  | Températures* | 11 | MCR03ERTJ103 | 10 kOhms | Résistances (diviseur de tensions), 5%, 1/10 W | Digi-Key | 0603 | 0.891 | 0.081 | Automotive | http://www.digikey.com/product-detail/en/CRCW060310K0FKEA/541-10.0KHCT-ND/1179924 | 77 |  |  | 77
X1 |  | Connecteur | 1 | IPL1-116-01-L-D-K | 32 pins | Connecteur 32 pins (tensions + signaux décharge) | Samtec | - | 0 | 0 |  | http://www.samtec.com/documents/webfiles/pdf/ipl1.pdf | 7 | 7 |  | 0
X2 |  | Connecteur | 1 | IPL1-115-01-L-D-RA-K | 30 pins | Connecteur 30 pins (tensions + températures) | Samtec | - | 0 | 0 |  | http://www.samtec.com/documents/webfiles/pdf/ipl1.pdf | 7 | 7 |  | 0
X3,X4 |  | Connecteur | 2 | IPL1-102-01-L-D-RA-K | 4 pins | Pour le CAN bus | Samtec | - | 0 | 0 |  | http://www.samtec.com/documents/webfiles/pdf/ipl1.pdf | 14 | 14 |  | 0
X5 |  | Connecteur | 1 | 9185066324 | 6 pins | Connecteur programmeur / debuggeur | Samtec | - | 1.5 | 1.5 |  | http://www.digikey.ca/product-detail/en/09185066324/1195-1664-ND/3180247 | 7 | 7 |  | 0
Complément X1 | x | Connecteur | 1 | MMSD-16-22-L-XXXX-D-K-M | 32 pins | Connecteur entre Slave et système de décharge | Samtec | N/A | 0 | 0 | IPD1 (version sans fils) | http://www.samtec.com/technical-specifications/Default.aspx?SeriesMaster=MMSD | 7 | 7 |  | 0
Complément X2 | x | Connecteur | 1 | MMSD-15-22-L-XXXX-D-K-M | 30 pins | Connecteur avec fil, AWG 22, entre Slave et VTIM | Samtec | N/A | 0 | 0 | IPD1 (versoin sans fils) | http://www.samtec.com/technical-specifications/Default.aspx?SeriesMaster=MMSD | 7 | 7 |  | 0
Complément X3,X4 | x | Connecteur | 2 | IPD1-02-D-K-M | 4 pins | Connecteur pour le CAN, sans fils, | Samtec | N/A | 0 | 0 |  | http://www.samtec.com/technical-specifications/Default.aspx?SeriesMaster=IPD1 | 14 | 14 |  | 0
Crimp X3,X4 | x | Crimp contact | 8 | CC79L-2024-01-L | - | Crimp pour fixer les fils au Complément X3,X4 | Samtec | N/A | 0 | 0 |  | http://www.samtec.com/technical-specifications/Default.aspx?SeriesMaster=CC79L | 56 | 56 |  | 0
Complément X5 | x | Connecteur | 0 | IDSD-03-X-XX.XX-T-? | 6 pins | Connecteur pour le programmeur | Samtec | N/A | 0 | 0 |  | http://www.samtec.com/technical-specifications/Default.aspx?seriesMaster=IDSD | 1 | 1 |  | 0
U11 |  | Autre | 1 | CPDT6-5V4-HF | - | 4 channel TVS | Digi-Key | SOD-23-6 | 0.85 | 0.85 |  | http://www.digikey.ca/product-detail/en/CPDT6-5V4-HF/641-1086-1-ND/1121208 | 7 |  |  | 7
C4, C9-C14, C15-C26,C29,C34, C38,C40-C42 |  | MCU Températures CAN DCDC | 14 | CC0603KRX7R0BB104 | 100 nF = 0.1 uF | Condensateur céramique Découplage MCU (un seul !) Découplage ampli-Ops Découplage ISO1050 Condensateur Cboot (DCDC) | Digi-Key | 0603 | 2.52 | 0.18 | Utilisé pour la plupart des 100nF du circuit 100V, +-10% | http://www.digikey.com/product-detail/en/CC0603KRX7R0BB104/311-1523-1-ND/3476112 | 98 |  |  | 98
(R45-R48) | x | Autre | 0 à 4 | - | ? Ohms | Résistances séries pour des entrées futures |  | 0603 | 0 |  | À déterminer au besoin
(R57-R64) | x | Autre | 0 à 4 | - | ? Ohms | Pull up et pull down pour utilisations futures |  | 0603 | 0
 |  |  |  |  |  |  |  | Prix total* | 75.92 |  | *Pour un circuit, prix des composantes à l'unité

Sheet: For Order
Référence | Do Not Place | Tag | Quantité (par esclave) | Numéro manufacturier | Value | Description | Supplier | Package | Prix Commande | Prix ($) | Commentaires | Lien | Total Qty | Qty Received | Received From | Qty to be ordered | Order Ref.
U1 |  | DCDC | 1 | TPS57060-Q1 | - | Régulateur de tension | TI | MSOP10 (+PowerPAD) | 5.03 | 5.03 | Automotive | http://www.ti.com/product/tps57060-q1 | 7 | 3 | TI | 4 | BMSs U1
U2 |  | DCDC | 1 | ACPL-M49T | - | Optocoupleur | Newark | SO-5 | 4.76 | 4.76 | Automotive | http://www.digikey.ca/product-detail/en/ACPL-M49T-500E/516-2908-1-ND/4240249 | 7 |  |  | 7 | BMSs U2
C1 |  | DCDC | 1 | GRM1885C1H242JA01D | 2.4 nF | Condensateur céramique | Digi-Key | 0603 | 0.16 | 0.16 | 50V, +-5% (Ccomp) | http://www.digikey.com/product-detail/en/GRM1885C1H242JA01D/490-3282-1-ND/702823 | 7 |  |  | 7 | BMSs C1
C2 |  | DCDC | 1 | CGA3E2C0G1H070D080AA | 7 pF | Condensateur céramique | Digi-Key | 0603 | 0.1 | 0.1 | Automotive, 50V (Ccomp2) | http://www.digikey.com/product-detail/en/CGA3E2C0G1H070D080AA/445-5625-1-ND/2443665 | 7 |  |  | 7 | BMSs C2
C3 |  | DCDC | 1 | CGA3E2X7R1H103K080AD | 10 nF | Condensateur céramique | Digi-Key | 0603 | 0.29 | 0.29 | Automotive, 50V (Css) | http://www.digikey.ca/product-detail/en/CGA3E2X7R1H103K080AD/445-8834-1-ND/3248249 | 7 |  |  | 7 | BMSs C3
C5,C6 |  | DCDC | 2 | CGA6N3X7R2A225K230AB | 2.2 uF | Condensateur découplage, X7R | Digi-Key | 1210 (3225 Metric) | 2.84 | 1.42 | Automotive, 100 V (Cin) | http://www.digikey.ca/product-detail/en/CGA6N3X7R2A225K230AB/445-5866-1-ND/2443906 | 14 |  |  | 14 | BMSs C5,C6
C43 |  | DCDC | 1 | APXE100ARA470ME61G | 47 uF | Condensateur électrolytique, découplage | Digi-Key | ~=E61 | 1.3 | 1.3 | 10V (Cout) | http://www.digikey.com/product-detail/en/APXE100ARA470ME61G/565-3197-1-ND/1826737 | 7 |  |  | 7 | BMSs C43
L1 |  | DCDC | 1 | VLP8040T-101M | 100 uH | Bobine | Digi-Key | Non Standard | 0.72 | 0.72 | +- 20%, 1 A, 330 mOhms | http://www.digikey.com/product-detail/en/VLP8040T-101M/445-6571-1-ND/2465878 | 7 |  |  | 7 | BMSs L1
FB |  | DCDC | 1 | MPZ2012S300A | - | Ferrite | Digi-Key | 0805 | 0.12 | 0.12 |  | http://www.digikey.com/product-detail/en/MPZ2012S300A/445-1566-1-ND/571896 | 7 |  |  | 7 | BMSs FB
D1 |  | DCDC | 1 | BYS12-90-E3/TR | - | Schottky diode | Mouser | DO-214AC | 0.58 | 0.58 |  | http://www.digikey.com/product-detail/en/BYS12-90-E3%2FTR/BYS12-90-E3%2FGICT-ND/2880301 | 7 |  |  | 7 | BMSs D1
R3, R39 |  | DCDC*, CAN* | 2 | CRCW060310K0FKEA | 10 kOhms | Résistance 1%, 1/8W | Digi-Key | 0603 | 0.162 | 0.081 | Automotive, MQ : 10 | http://www.digikey.com/product-detail/en/CRCW060310K0FKEA/541-10.0KHCT-ND/1179924 | 14 |  |  | 14 | BMSs R3, R39
R2, R65 |  | DCDC | 2 | CRCW060353K6FKEA | 53.6 kOhms | Résistance 1%, 1/10 W | Digi-Key | 0603 | 0.162 | 0.081 | Automotive, MQ : 10 | http://www.digikey.com/product-detail/en/CRCW060353K6FKEA/541-53.6KHCT-ND/1180007 | 14 |  |  | 14 | BMSs R2, R65
R1 |  | DCDC | 1 | CRCW0603191KFKEA | 191 kOhms | Résistance 1%, 1/10 W | Digi-Key | 0603 | 0.081 | 0.081 | Automotive, MQ : 10 | http://www.digikey.com/product-detail/en/CRCW0603191KFKEA/541-191KHCT-ND/1180068 | 7 |  |  | 7 | BMSs R1
R4 |  | DCDC | 1 | CRCW0603374KFKEA | 374 kOhms | Résistance 1%, 1/10 W | Digi-Key | 0603 | 0.081 | 0.081 | Automotive, MQ : 10 | http://www.digikey.com/product-detail/en/CRCW0603374KFKEA/541-374KHCT-ND/1180102 | 7 |  |  | 7 | BMSs R4
R5 |  | DCDC | 1 | CRCW060320K0FKEA | 20 kOhms | Résistance EN | Digi-Key | 0603 | 0.04 | 0.04 | Automotive, MQ : 10 | http://www.digikey.com/product-detail/en/CRCW060320K0FKEA/541-20.0KHCT-ND/1179956 | 7 |  |  | 7 | BMSs R5
R6 |  | DCDC | 1 | CRCW0603150KFKEA | 150 kOhms | Résistance EN | Digi-Key | 0603 | 0.081 | 0.081 | Automotive, MQ : 10 | http://www.digikey.com/product-detail/en/CRCW0603150KFKEA/541-150KHCT-ND/1180056 | 7 |  |  | 7 | BMSs R6
R7 |  | DCDC | 1 | CRCW060375K0FKEA | 75 kOhms | Résistance EN | Digi-Key | 0603 | 0.081 | 0.081 | Automotive, MQ : 10 | http://www.digikey.com/product-detail/en/CRCW060375K0FKEA/541-75.0KHCT-ND/1180024 | 7 |  |  | 7 | BMSs R7
(R8) | x | DCDC* | 1 | RMCF0603ZT0R00 | 0 Ohms | Bypass pour activer le DCDC | Digi-Key | 0603 | 0 | 0.02 | Même que R36 | http://www.digikey.com/product-detail/en/RMCF0603ZT0R00/RMCF0603ZT0R00CT-ND/1943218 | 7 |  |  | 7 | BMSs (R8)
U4 |  | MCU | 1 | SN74LVC3G07-Q1 | - | Tripple buffer / driver (open collector) | TI | US8 (DCU) | 0.7 | 0.7 |  | http://www.ti.com/product/sn74lvc3g07-q1 | 7 | 3 | TI | 4 | BMSs U4
U6 |  | MCU | 1 | MC9S12XDP512MAG | - | Micro-contrôleur | Freescale | 144pin LQFP | 0 | 0 |  | http://www.digikey.ca/product-detail/en/MC9S12XDP512MAG/MC9S12XDP512MAG-ND/1167901 | 7 | 7 | Freescale | 0 | BMSs U6
C27-C28 |  | MCU | 2 | CC0603JRNPO9BN200 | 20 pF | Condensateur du crystal | Digi-Key | 0603 | 0.22 | 0.11 |  | http://www.digikey.ca/product-detail/en/CC0603JRNPO9BN200/311-1424-1-ND/2833730 | 14 |  |  | 14 | BMSs C27-C28
C35 |  | MCU | 1 | CGA3E2C0G1H101J080AA | 100 pF | Condensateur RESET (programmeur) | Digi-Key | 0603 | 0.12 | 0.12 | Automotive, 50V, 5% | http://www.digikey.ca/product-detail/en/CGA3E2C0G1H101J080AA/445-5640-1-ND/2443680 | 7 |  |  | 7 | BMSs C35
C36,C37,C39 |  | MCU | 3 | CGA3E3X7R1V224K080AB | 220 nF | Condensateur céramique | Digi-Key | 0603 | 0.75 | 0.25 | Automotive 35V | http://www.digikey.ca/product-detail/en/CGA3E3X7R1V224K080AB/445-12551-1-ND/3954217 | 21 |  |  | 21 | BMSs C36,C37,C39
R38,R42-R44 |  | MCU | 4 | RMCF0603JT470R | 470 Ohms | Résistance série (pour LED1-4) | Digi-Key | 0603 | 0.12 | 0.03 |  | http://www.digikey.ca/product-detail/en/RMCF0603JT470R/RMCF0603JT470RCT-ND/1943166 | 28 |  |  | 28 | BMSs R38,R42-R44
R22-R33, R37,R53-R56 |  | MCU*, Températures* | 16 | MCR03ERTJ103 | 10 kOhms | Pull up pour les LED drivers | Digi-Key | 0603 | 0.272 | 0.017 |  | http://www.digikey.com/product-detail/en/CRCW060310K0FKEA/541-10.0KHCT-ND/1179924 | 112 |  |  | 112 | BMSs R22-R33, R37,R53-R56
(R49-R52) | x | MCU* | 4 | MCR03ERTJ102 | 1 kOhms | Résistances pour l'ID des slaves | Digi-Key | 0603 | 0.034 | 0.017 |  | http://www.digikey.ca/product-detail/en/RMCF0603JT1K00/RMCF0603JT1K00CT-ND/1943173 | 28 |  |  | 28 | BMSs (R49-R52)
LED3 |  | MCU | 1 | APT3216YC | - | LED jaune | Digi-Key | 1206 | 0.24 | 0.24 | 20 mA | http://www.digikey.com/product-detail/en/LTST-C150KSKT/160-1406-6-ND/1888639 | 7 |  |  | 7 | BMSs LED3
LED4 |  | MCU | 1 | LH N974-KN-1 | - | LED rouge | Digi-Key | 1206 | 0.13 | 0.13 | 20 mA | http://www.digikey.ca/product-detail/en/LTST-C150KRKT/160-1405-1-ND/386760 | 7 |  |  | 7 | BMSs LED4
LED1, LED2 |  | MCU / Autre | 2 | LG N971-KN-1 | - | LED verte | Digi-Key | 1206 | 0.26 | 0.13 | 20 mA | http://www.digikey.com/product-detail/en/LTST-C150KGKT/160-1404-6-ND/1835220 | 14 |  |  | 14 | BMSs LED1, LED2
Y1 |  | MCU | 1 | ECS-160-20-3X-EN-TR | 16 MHz | Crystal | Digi-Key | HC49 | 0.72 | 0.72 |  | http://www.digikey.ca/product-detail/en/ECS-160-20-3X-EN-TR/XC1793CT-ND/2676657 | 7 |  |  | 7 | BMSs Y1
U5 |  | CAN | 1 | ISO1050 | - | Isolated CAN Transceiver | TI | SOP-8 | 5.93 | 5.93 |  | http://www.digikey.ca/product-detail/en/ISO1050DUBR/296-24818-1-ND/2094658 | 7 | 2 | TI | 5 | BMSs U5
U10 |  | CAN | 1 | ESDCAN24-2BLY | - | Protection TVS/ESD pour le CAN | Digi-Key | SOT23 | 0.69 | 0.69 |  | http://www.digikey.ca/product-detail/en/ESDCAN24-2BLY/497-13262-1-ND/3661760 | 7 |  |  | 7 | BMSs U10
C7 |  | CAN | 1 | C1608X5R1A106M080AC | 10 uF | Condensateur optocoupleur | Digi-Key | 0603 | 0.53 | 0.53 |  | http://www.digikey.ca/product-detail/en/C1608X5R1A106M080AC/445-6853-1-ND/2619215 | 7 |  |  | 7 | BMSs C7
C8 |  | CAN | 1 | CC0603KRX7R8BB473 | 47 nF | Condensateur bus CAN | Digi-Key | 0603 | 0.11 | 0.11 | Terminaison bus CAN | http://www.digikey.ca/product-detail/en/CGA3E2X5R1H473K080AA/445-12494-1-ND/3954160 | 7 |  |  | 7 | BMSs C8
(R40,R41) | x | CAN | 2 | RC1608F60R4CS | 60.4 Ohms | Résistances de terminaison du bus CAN | Digi-Key | 0603 | 0.13 | 0.13 |  | http://www.digikey.ca/product-detail/en/RC1608F60R4CS/1276-4547-1-ND/3967519 | 14 |  |  | 14 | BMSs (R40,R41)
U3 |  | Tensions | 1 | LTC6803-4 | - | Puce de mesure des tensions | Linear | SSOP-48 | 23.9 | 23.9 |  | http://www.linear.com/product/LTC6803-2 | 7 | 10 | Linear | -3 | BMSs U3
C31-C33 |  | Tensions | 3 | CGA3E1X7R1C105K080AC | 1 uF | Condensateur céramique, découplage | Digi-Key | 0603 | 0.42 | 0.14 | Automotive, 16V | http://www.digikey.ca/product-detail/en/CGA3E1X7R1C105K080AC/445-12539-1-ND/3954205 | 21 |  |  | 21 | BMSs C31-C33
R9-R21,R34 |  | Tensions | 14 | RNCP0603FTD100R | 100 Ohms | Résistance série, filtre tensions, 1%, 1/8 W | Digi-Key | 0603 | 0.7 | 0.05 |  | http://www.digikey.com/product-detail/en/RNCP0603FTD100R/RNCP0603FTD100RCT-ND/2240425 | 98 |  |  | 98 | BMSs R9-R21,R34
R35 |  | Tensions* | 1 | RMCF0603JT1K00 | 1 kOhms | Résistance pull up sur SDO (MISO) | Digi-Key | 0603 | 0.03 | 0.03 |  | http://www.digikey.ca/product-detail/en/RMCF0603JT1K00/RMCF0603JT1K00CT-ND/1943173 | 7 |  |  | 7 | BMSs R35
R66-R68 |  | Tensions | 3 | RMCF0603JT1M00 | 1 MOhms | Pull up sur MOSI,SCK,SS | Digi-Key | 0603 | 0.09 | 0.03 |  | http://www.digikey.ca/product-detail/en/RMCF0603JT1M00/RMCF0603JT1M00CT-ND/1943210 | 21 |  |  | 21 | BMSs R66-R68
D2-D13 |  | Tensions | 11 | DDZ7V5C-7 | 7.5 V | Diode zener | Digi-Key | SOD-123 | 4.95 | 0.45 | Faible courant de fuite : 100 nA | http://www.digikey.ca/product-detail/en/DDZ7V5C-7/DDZ7V5CDICT-ND/700171 | 77 |  |  | 77 | BMSs D2-D13
D14 |  | Tensions | 1 | MMSZ5265BT1G | 62 V | Diode zener | Digi-Key | SOD-123 | 0.29 | 0.29 | Faible courant de fuite : 100 nA | http://www.digikey.ca/product-detail/en/MMSZ5265BT1G/MMSZ5265BT1GOSCT-ND/2705144 | 7 |  |  | 7 | BMSs D14
U7-U9 |  | Températures | 3 | OPA4376 | - | Ampli-OP suiveurs | TI | TSSOP-14 | 12.42 | 4.14 | Automotive |  | 21 | 3 | TI | 18 | BMSs U7-U9
X1 |  | Connecteur | 1 | IPL1-116-01-L-D-K | 32 pins | Connecteur 32 pins (tensions + signaux décharge) | Samtec | - | 0 | 0 |  | http://www.samtec.com/documents/webfiles/pdf/ipl1.pdf | 7 | 7 |  | 0 | BMSs X1
X2 |  | Connecteur | 1 | IPL1-115-01-L-D-RA-K | 30 pins | Connecteur 30 pins (tensions + températures) | Samtec | - | 0 | 0 |  | http://www.samtec.com/documents/webfiles/pdf/ipl1.pdf | 7 | 7 |  | 0 | BMSs X2
X3,X4 |  | Connecteur | 2 | IPL1-102-01-L-D-RA-K | 4 pins | Pour le CAN bus | Samtec | - | 0 | 0 |  | http://www.samtec.com/documents/webfiles/pdf/ipl1.pdf | 14 | 14 |  | 0 | BMSs X3,X4
X5 |  | Connecteur | 1 | 9185066324 | 6 pins | Connecteur programmeur / debuggeur | Mouser | - | 1.5 | 1.5 |  | http://www.digikey.ca/product-detail/en/09185066324/1195-1664-ND/3180247 | 7 | 7 |  | 0 | BMSs X5
Complément X1 | x | Connecteur | 1 | MMSD-16-22-L-XXXX-D-K-M | 32 pins | Connecteur entre Slave et système de décharge | Samtec | N/A | 0 | 0 | IPD1 (version sans fils) | http://www.samtec.com/technical-specifications/Default.aspx?SeriesMaster=MMSD | 7 | 7 |  | 0 | BMSs Complément X1
Complément X2 | x | Connecteur | 1 | MMSD-15-22-L-XXXX-D-K-M | 30 pins | Connecteur avec fil, AWG 22, entre Slave et VTIM | Samtec | N/A | 0 | 0 | IPD1 (versoin sans fils) | http://www.samtec.com/technical-specifications/Default.aspx?SeriesMaster=MMSD | 7 | 7 |  | 0 | BMSs Complément X2
Complément X3,X4 | x | Connecteur | 2 | IPD1-02-D-K-M | 4 pins | Connecteur pour le CAN, sans fils, | Samtec | N/A | 0 | 0 |  | http://www.samtec.com/technical-specifications/Default.aspx?SeriesMaster=IPD1 | 14 | 14 |  | 0 | BMSs Complément X3,X4
Crimp X3,X4 | x | Crimp contact | 8 | CC79L-2024-01-L | - | Crimp pour fixer les fils au Complément X3,X4 | Samtec | N/A | 0 | 0 |  | http://www.samtec.com/technical-specifications/Default.aspx?SeriesMaster=CC79L | 56 | 56 |  | 0 | BMSs Crimp X3,X4
Complément X5 | x | Connecteur | 0 | IDSD-03-X-XX.XX-T-? | 6 pins | Connecteur pour le programmeur | Samtec | N/A | 0 | 0 |  | http://www.samtec.com/technical-specifications/Default.aspx?seriesMaster=IDSD | 1 | 1 |  | 0 | BMSs Complément X5
U11 |  | Autre | 1 | CPDT6-5V4-HF | - | 4 channel TVS | Digi-Key | SOD-23-6 | 0.85 | 0.85 |  | http://www.digikey.ca/product-detail/en/CPDT6-5V4-HF/641-1086-1-ND/1121208 | 7 |  |  | 7 | BMSs U11
C4, C9-C14, C15-C26,C29,C34, C38,C40-C42 |  | MCU Températures CAN DCDC | 14 | CC0603KRX7R0BB104 | 100 nF = 0.1 uF | Condensateur céramique Découplage MCU (un seul !) Découplage ampli-Ops Découplage ISO1050 Condensateur Cboot (DCDC) | Digi-Key | 0603 | 2.52 | 0.18 | Utilisé pour la plupart des 100nF du circuit 100V, +-10% | http://www.digikey.com/product-detail/en/CC0603KRX7R0BB104/311-1523-1-ND/3476112 | 98 |  |  | 98 | BMSs C4, C9-C14, C15-C26,C29,C34, C38,C40-C42

Sheet: BMS_PackingList
Packing list
Système | BMS Slave v2.0 |  |  |  |  |  |  | Poly eRacing
Nombre d'unités à assembler |  |  | 6 |  |  |  |  | 2014-06-10
Changes
2014-12-28 | *R21 and C33 were removed from the initial design (minor design mistakes)
Référence | DNP | Quantité (par unité) | Numéro manufacturier | Value | Description | Total Qty | Shipped | Commentaires
(R40,R41) | x | 2 | RC1608F60R4CS | 60.4 Ohms | Résistances de terminaison du bus CAN | 12 |  | _________________________________
(R49-R52) | x | 4 | MCR03ERTJ102 | 1 kOhms | Résistances pour l'ID des slaves | 24 |  | _________________________________
(R8) | x | 1 | RMCF0603ZT0R00 | 0 Ohms | Bypass pour activer le DCDC | 6 |  | _________________________________
C1 |  | 1 | GRM1885C1H242JA01D | 2.4 nF | Condensateur céramique | 6 |  | _________________________________
C2 |  | 1 | CGA3E2C0G1H070D080AA | 7 pF | Condensateur céramique | 6 |  | _________________________________
C27-C28 |  | 2 | CC0603JRNPO9BN200 | 20 pF | Condensateur du crystal | 12 |  | _________________________________
C3 |  | 1 | CGA3E2X7R1H103K080AD | 10 nF | Condensateur céramique | 6 |  | _________________________________
C31-C32 |  | 3 | CGA3E1X7R1C105K080AC | 1 uF | Condensateur céramique, découplage | 18 |  | _________________________________
C35 |  | 1 | CGA3E2C0G1H101J080AA | 100 pF | Condensateur RESET (programmeur) | 6 |  | _________________________________
C36,C37,C39 |  | 3 | CGA3E3X7R1V224K080AB | 220 nF | Condensateur céramique | 18 |  | _________________________________
C4, C9-C14, C15-C26,C29,C34, C38,C40-C42 |  | 25 | CC0603KRX7R0BB104 | 100 nF = 0.1 uF | Condensateur céramique Découplage MCU (un seul !) Découplage ampli-Ops Découplage ISO1050 Condensateur Cboot (DCDC) | 150 |  | _________________________________
C43 |  | 1 | APXE100ARA470ME61G | 47 uF | Condensateur électrolytique, découplage | 6 |  | _________________________________
C5,C6 |  | 2 | CGA6N3X7R2A225K230AB | 2.2 uF | Condensateur découplage, X7R | 12 |  | _________________________________
C7 |  | 1 | C1608X5R1A106M080AC | 10 uF | Condensateur optocoupleur | 6 |  | _________________________________
C8 |  | 1 | CC0603KRX7R8BB473 | 47 nF | Condensateur bus CAN | 6 |  | _________________________________
Complément X1 | x | 1 | MMSD-16-22-L-XXXX-D-K-M | 32 pins | Connecteur entre Slave et système de décharge | 6 |  | _________________________________
Complément X2 | x | 1 | MMSD-15-22-L-XXXX-D-K-M | 30 pins | Connecteur avec fil, AWG 22, entre Slave et VTIM | 6 |  | _________________________________
Complément X3,X4 | x | 2 | IPD1-02-D-K-M | 4 pins | Connecteur pour le CAN, sans fils, | 12 |  | _________________________________
Complément X5 | x | 0 | IDSD-03-X-XX.XX-T-? | 6 pins | Connecteur pour le programmeur | 0 |  | _________________________________
Crimp X3,X4 | x | 8 | CC79L-2024-01-L | - | Crimp pour fixer les fils au Complément X3,X4 | 48 |  | _________________________________
D1 |  | 1 | BYS12-90-E3/TR | - | Schottky diode | 6 |  | _________________________________
D14 |  | 1 | MMSZ5265BT1G | 62 V | Diode zener | 6 |  | _________________________________
D2-D13 |  | 12 | DDZ7V5C-7 | 7.5 V | Diode zener | 72 |  | _________________________________
FB |  | 1 | MPZ2012S300A | - | Ferrite | 6 |  | _________________________________
L1 |  | 1 | VLP8040T-101M | 100 uH | Bobine | 6 |  | _________________________________
LED1, LED2 |  | 2 | LG N971-KN-1 | - | LED verte | 12 |  | _________________________________
LED3 |  | 1 | APT3216YC | - | LED jaune | 6 |  | _________________________________
LED4 |  | 1 | LH N974-KN-1 | - | LED rouge | 6 |  | _________________________________
PCB |  | 1 | - | - | PCB BMS Slave v2.0 | 6 |  | _________________________________
R1 |  | 1 | CRCW0603191KFKEA | 191 kOhms | Résistance 1%, 1/10 W | 6 |  | _________________________________
R2, R65 |  | 2 | CRCW060353K6FKEA | 53.6 kOhms | Résistance 1%, 1/10 W | 12 |  | _________________________________
R22-R33, R37,R53-R56 |  | 17 | MCR03ERTJ103 | 10 kOhms | Pull up pour les LED drivers | 102 |  | _________________________________
R3, R39 |  | 2 | CRCW060310K0FKEA | 10 kOhms | Résistance 1%, 1/8W | 12 |  | _________________________________
R35 |  | 1 | RMCF0603JT1K00 | 1 kOhms | Résistance pull up sur SDO (MISO) | 6 |  | _________________________________
R38,R42-R44 |  | 4 | RMCF0603JT470R | 470 Ohms | Résistance série (pour LED1-4) | 24 |  | _________________________________
R4 |  | 1 | CRCW0603374KFKEA | 374 kOhms | Résistance 1%, 1/10 W | 6 |  | _________________________________
R5 |  | 1 | CRCW060320K0FKEA | 20 kOhms | Résistance EN | 6 |  | _________________________________
R6 |  | 1 | CRCW0603150KFKEA | 150 kOhms | Résistance EN | 6 |  | _________________________________
R66-R68 |  | 3 | RMCF0603JT1M00 | 1 MOhms | Pull up sur MOSI,SCK,SS | 18 |  | _________________________________
R7 |  | 1 | CRCW060375K0FKEA | 75 kOhms | Résistance EN | 6 |  | _________________________________
R9-R20,R34 |  | 14 | RNCP0603FTD100R | 100 Ohms | Résistance série, filtre tensions, 1%, 1/8 W | 84 |  | _________________________________
U1 |  | 1 | TPS57060-Q1 | - | Régulateur de tension D6Q | 6 |  | _________________________________
U10 |  | 1 | ESDCAN24-2BLY | - | Protection TVS/ESD pour le CAN | 6 |  | _________________________________
U11 |  | 1 | CPDT6-5V4-HF | - | 4 channel TVS | 6 |  | _________________________________
U2 |  | 1 | ACPL-M49T | - | Optocoupleur | 6 |  | _________________________________
U3 |  | 1 | LTC6803IG-4PBF | - | Puce de mesure des tensions | 6 |  | _________________________________
U4 |  | 1 | SN74LVC3G07-Q1 | - | Tripple buffer / driver (open collector) DCU | 6 |  | _________________________________
U5 |  | 1 | ISO1050 | - | Isolated CAN Transceiver DUBR | 6 |  | _________________________________
U6 |  | 1 | MC9S12XDP512MAG | - | Micro-contrôleur | 6 |  | _________________________________
U7-U9 |  | 3 | OPA4376 | - | Ampli-OP suiveurs | 18 |  | _________________________________
X1 |  | 1 | IPL1-116-01-L-D-K | 32 pins | Connecteur 32 pins (tensions + signaux décharge) | 6 |  | _________________________________
X2 |  | 1 | IPL1-115-01-L-D-RA-K | 30 pins | Connecteur 30 pins (tensions + températures) | 6 |  | _________________________________
X3,X4 |  | 2 | IPL1-102-01-L-D-RA-K | 4 pins | Pour le CAN bus | 12 |  | _________________________________
X5 |  | 1 | 9185066324 | 6 pins | Connecteur programmeur / debuggeur | 6 |  | _________________________________
Y1 |  | 1 | ECS-160-20-3X-EN-TR | 16 MHz | Crystal | 6 |  | _________________________________
