HarshJain/bmsafe/Slave_v2/LTC6804-version/BOM_slave_LTC6804.xlsx

Package custom
À réviser |  |  | Facultatif ou variable : (REF) |  | Il y a des erreurs dans ce document…
Ne pas assembler |  |  | MQR : minimum quantity
Commandite
Référence | Tag | Quantité (par esclave) | Numéro manufacturier | Value | Description | Package | Prix Commande | Prix ($) | Commentaires | Lien
U1 | DCDC | 1 | TPS57060-Q1 | - | Régulateur de tension | MSOP10 (+PowerPAD) | 5.03 | 5.03 | Automotive | http://www.ti.com/product/tps57060-q1
U2 | DCDC | 1 | ACPL-M49T | - | Optocoupleur | SO-5 | 4.51 | 4.51 | Automotive | http://www.digikey.ca/product-detail/en/ACPL-M49T-500E/516-2908-2-ND/2347222
C1 | DCDC | 1 | GRM1885C1H242JA01D | 2.4 nF | Condensateur céramique | 0603 | 0.18 | 0.18 | 50V, +-5% (Ccomp) | http://www.digikey.com/product-detail/en/GRM1885C1H242JA01D/490-3282-2-ND/702546
C2 | DCDC | 1 | CGA3E2C0G1H070D080AA | 7 pF | Condensateur céramique | 0603 | 0.11 | 0.11 | Automotive, 50V (Ccomp2) | http://www.digikey.com/product-detail/en/CGA3E2C0G1H070D080AA/445-5625-2-ND/2443103
C3 | DCDC | 1 | CGA3E2X7R1H103K080AD | 10 nF | Condensateur céramique | 0603 | 0.27 | 0.27 | Automotive, 50V (Css) | http://www.digikey.ca/product-detail/en/CGA3E2X7R1H103K080AD/445-8834-2-ND/3248139
C5,C6 | DCDC | 2 | CGA6N3X7R2A225K230AB | 2.2 uF | Condensateur découplage, X7R | 0 | 2.7 | 1.35 | Automotive, 100 V (Cin) | http://www.digikey.ca/product-detail/en/CGA6N3X7R2A225K230AB/445-5866-2-ND/2443344
C43 | DCDC | 1 | APXE100ARA470ME61G | 47 uF | Condensateur électrolytique, découplage | ~E61 | 1.28 | 1.28 | 10V (Cout) | http://www.digikey.com/product-detail/en/APXE100ARA470ME61G/565-3197-1-ND/1826737
L1 | DCDC | 1 | VLP8040T-101M | 100 uH | Bobine | Non Standard | 0.72 | 0.72 |  | http://www.digikey.com/product-detail/en/VLP8040T-101M/445-6571-2-ND/2465328
FB | DCDC | 1 | MPZ2012S300A | - | Ferrite | 0805 | 0.12 | 0.12 |  | http://www.digikey.com/product-detail/en/MPZ2012S300A/445-1566-1-ND/571896
D1 | DCDC | 1 | BYS12-90-E3/TR | - | Schottky diode | DO-214AC | 0.58 | 0.58 |  | http://www.digikey.com/product-detail/en/BYS12-90-E3%2FTR/BYS12-90-E3%2FGICT-ND/2880301
R3, R65 | DCDC | 1 | CRCW060310K0FKEA | 10 kOhms | Résistance 1%, 1/8W | 0603 | 0.081 | 0.081 | Automotive, MQ : 10 | http://www.digikey.com/product-detail/en/CRCW060310K0FKEA/541-10.0KHCT-ND/1179924
R2 | DCDC | 1 | CRCW060353K6FKEA | 53.6 kOhms | Résistance 1%, 1/10 W | 0603 | 0.081 | 0.081 | Automotive, MQ : 10 | http://www.digikey.com/product-detail/en/CRCW060353K6FKEA/541-53.6KHCT-ND/1180007
R1 | DCDC | 1 | CRCW0603191KFKEA | 191 kOhms | Résistance 1%, 1/10 W | 0603 | 0.081 | 0.081 | Automotive, MQ : 10 | http://www.digikey.com/product-detail/en/CRCW0603191KFKEA/541-191KHCT-ND/1180068
R4 | DCDC | 1 | CRCW0603374KFKEA | 374 kOhms | Résistance 1%, 1/10 W | 0603 | 0.081 | 0.081 | Automotive, MQ : 10 | http://www.digikey.com/product-detail/en/CRCW0603374KFKEA/541-374KHCT-ND/1180102
R5 | DCDC | 1 | CRCW060320K0FKEA | 20 kOhms | Résistance EN | 0603 | 0.04 | 0.04 | Automotive, MQ : 10 | http://www.digikey.com/product-detail/en/CRCW060320K0FKEA/541-20.0KHCT-ND/1179956
R6 | DCDC | 1 | CRCW0603150KFKEA | 150 kOhms | Résistance EN | 0603 | 0.081 | 0.081 | Automotive, MQ : 10 | http://www.digikey.com/product-detail/en/CRCW0603150KFKEA/541-150KHCT-ND/1180056
R7 | DCDC | 1 | CRCW060375K0FKEA | 75 kOhms | Résistance EN | 0603 | 0.081 | 0.081 | Automotive, MQ : 10 | http://www.digikey.com/product-detail/en/CRCW060375K0FKEA/541-75.0KHCT-ND/1180024
(R8) | DCDC | 0 | RMCF0603ZT0R00 | 0 Ohms | Bypass pour activer le DCDC | 0603 | 0 | 0.02 | Même que R36 | http://www.digikey.com/product-detail/en/RMCF0603ZT0R00/RMCF0603ZT0R00CT-ND/1943218
U4 | MCU | 1 | SN74LVC3G07-Q1 | - | Tripple buffer / driver (open collector) | US8 (DCU) | 0.7 | 0.7
U6 | MCU | 1 | MC9S12XDP512MAG | - | Micro-contrôleur | 144pin LQFP | 0 | 0
C27-C28 | MCU | 2 | CC0603JRNPO9BN200 | 20 pF | Condensateur crystal | 0603 | 0.22 | 0.11 |  | http://www.digikey.ca/product-detail/en/CC0603JRNPO9BN200/311-1424-1-ND/2833730
C35 | MCU | 1 | CGA3E2C0G1H101J080AA | 100 pF | Condensateur RESET (programmeur) | 0603 | 0.11 | 0.11 | Automotive, 50V, 5% | http://www.digikey.ca/product-detail/en/CGA3E2C0G1H101J080AA/445-5640-1-ND/2443680
C36,C37,C39 | MCU | 3 | CGA3E3X7R1V224K080AB | 220 nF | Condensateur céramique | 0603 | 0.72 | 0.24 | Automotive 35V | http://www.digikey.ca/product-detail/en/CGA3E3X7R1V224K080AB/445-12551-2-ND/3949787
R38,R42-R44 | MCU | 3 | RMCF0603JT470R | 470 Ohms | Résistance série (pour LED1-4) | 0603 | 0.06 | 0.02 |  | http://www.digikey.ca/product-detail/en/RMCF0603JT470R/RMCF0603JT470RCT-ND/1943166
R37,R53-R56 | MCU | 4 | RMCF0603JT10K0 | 10 kOhms | Pull up pour les LED drivers | 0603 | 0.08 | 0.02 |  | http://www.digikey.ca/product-detail/en/RMCF0603JT10K0/RMCF0603JT10K0CT-ND/1943191
(R49-R52) | MCU | 0 à 4 | RMCF0603JT1K00 | 1 kOhms | Résistances pour l'ID des slaves | 0603 | 0.08 | 0.02 |  | http://www.digikey.ca/product-detail/en/RMCF0603JT1K00/RMCF0603JT1K00CT-ND/1943173
LED2 | MCU | 1 | LTST-C150KSKT | - | LED jaune | 1206 | 0.37 | 0.37 | 20 mA | http://www.digikey.com/product-detail/en/LTST-C150KSKT/160-1406-6-ND/1888639
LED4 | MCU | 1 | LTST-C150KRKT | - | LED rouge | 1206 | 0.42 | 0.42 | 20 mA | http://www.digikey.ca/product-detail/en/LTST-C150KRKT/160-1405-1-ND/386760
LED1, LED3 | MCU / Autre | 2 | LTST-C150KGKT | - | LED verte | 1206 | 0.74 | 0.37 | 20 mA | http://www.digikey.com/product-detail/en/LTST-C150KGKT/160-1404-6-ND/1835220
Y1 | MCU | 1 | ECS-160-20-3X-EN-TR | 16 MHz | Crystal | HC49 | 0.68 | 0.68 |  | http://www.digikey.ca/product-detail/en/ECS-160-20-3X-EN-TR/XC1793TR-ND/2676623
U5 | CAN | 1 | ISO1050 | - | Isolated CAN Transceiver | SOP-8 | 5.62 | 5.62 |  | http://www.digikey.ca/product-detail/en/ISO1050DUBR/296-24818-1-ND/2094658
U10 | CAN | 1 | ESDCAN24-2BLY | - | Protection TVS/ESD pour le CAN | SOT23 | 0.66 | 0.66 |  | http://www.digikey.ca/product-detail/en/ESDCAN24-2BLY/497-13262-1-ND/3661760
C7 | CAN | 1 | C1608X5R1A106M080AC | 10 uF | Condensateur optocoupleur | 0603 | 0.5 | 0.5 |  | www.digikey.ca/product-detail/en/LTST-C193KSKT-5A/160-1831-1-ND/2356253
C8 | CAN | 1 | CC0603KRX7R8BB473 | 47 nF | Condensateur bus CAN | 0805 | 0.11 | 0.11 | Terminaison bus CAN | http://www.digikey.ca/product-detail/en/CGA3E2X5R1H473K080AA/445-12494-1-ND/3954160
(R40,R41) | CAN | 0 ou 2 | RC1608F60R4CS | 60.4 Ohms | Résistances de terminaison du bus CAN | 0608 | 0.12 | 0.12 |  | http://www.digikey.ca/product-detail/en/RC1608F60R4CS/1276-4547-1-ND/3967519
U3 | Tensions | 1 | LTC6804-2 | - | Puce de mesure des tensions | SSOP-48 | 23.9 | 23.9
C15-C26, C30 | Tensions | 13 | CGA3E2X8R2A103K080AA | 100nF | Condensateurs céramique, filtrage des tensions | 0603 | 2.21 | 0.17 | Automotive, 100V, Htemp | http://www.digikey.com/product-detail/en/CGA3E2X8R2A103K080AA/445-5903-1-ND/2443943
C31-C33 | Tensions | 3 | CGA3E1X7R1C105K080AC | 1 uF | Condensateur céramique, découplage | 0603 | 0.42 | 0.14 | Automotive, 16V
R9-R21,R34 | Tensions | 14 | RNCP0603FTD100R | 100 Ohms | Résistance série, filtre tensions, 1%, 1/8 W | 0603 | 0.7 | 0.05 |  | http://www.digikey.com/product-detail/en/RNCP0603FTD100R/RNCP0603FTD100RCT-ND/2240425
R35 | Tensions | 1 | RMCF0603FT4K99 | 4.99 kOhmw | Résistance pull up sur SDO | 0603 | 0.05 | 0.05 |  | http://www.digikey.ca/product-detail/en/RMCF0603FT4K99/RMCF0603FT4K99CT-ND/1943036
D2-D13 | Tensions | 12 | DDZ9692-7 | 6.8 V | Diode zener | SOD-123 | 5.4 | 0.45 | Faible courant de fuite : 100 nA | http://www.digikey.ca/product-detail/en/DDZ9692-7/DDZ9692DICT-ND/700177
U7-U9 | Températures | 3 | OPA4376 | - | Ampli-OP suiveurs | TSSOP-14 | 12.42 | 4.14 | Automotive
R22-R33, R39 | Températures | 12 | CRCW060310K0FKEA | 10 kOhms | Résistances (diviseur de tensions), 1%, 1/10 W | 0603 | 0.972 | 0.081 | Automotive | http://www.digikey.com/product-detail/en/CRCW060310K0FKEA/541-10.0KHCT-ND/1179924
X1 | Connecteur | 1 | IPL1-16-01-L-D-RA-K | 32 pins | Connecteur 32 pins (tensions + températures) | - | 0 | 0 |  | http://www.samtec.com/documents/webfiles/pdf/ipl1.pdf
X2 | Connecteur | 1 | IPL1-15-01-L-D-K | 30 pins | Connecteur 30 pins (tensions + signaux décharge) | - | 0 | 0 |  | http://www.samtec.com/documents/webfiles/pdf/ipl1.pdf
X3,X4 | Connecteur | 2 | IPL1-02-01-L-D-RA-K | 4 pins | Pour le CAN bus | - | 0 | 0 |  | http://www.samtec.com/documents/webfiles/pdf/ipl1.pdf
X5 | Connecteur | 1 | 9185066324 | 6 pins | Connecteur programmeur / debuggeur | - | 1.5 | 1.5 |  | http://www.digikey.ca/product-detail/en/09185066324/1195-1664-ND/3180247
Complément X1 | Connecteur | 1 | MMSD-16-22-L-XXXX-D-K-M | 32 pins | Connecteur entre Slave et système de décharge | N/A | 0 | 0 | IPD1 (version sans fils) | http://www.samtec.com/technical-specifications/Default.aspx?SeriesMaster=MMSD
Complément X2 | Connecteur | 1 | MMSD-15-22-L-XXXX-D-K-M | 30 pins | Connecteur avec fil, AWG 22, entre Slave et VTIM | N/A | 0 | 0 | IPD1 (versoin sans fils) | http://www.samtec.com/technical-specifications/Default.aspx?SeriesMaster=MMSD
Complément X3,X4 | Connecteur | 2 | IPD1-02-D-K-M | 4 pins | Connecteur pour le CAN, sans fils, | N/A | 0 | 0 |  | http://www.samtec.com/technical-specifications/Default.aspx?SeriesMaster=IPD1
Crimp X3,X4 | Crimp contact | 8 | CC79L-2024-01-L | - | Crimp pour fixer les fils au Complément X3,X4 | N/A | 0 | 0 |  | http://www.samtec.com/technical-specifications/Default.aspx?SeriesMaster=CC79L
Complément X5 | Connecteur | 0 ou 1 | IDSD-03-X-XX.XX-T-? | 6 pins | Connecteur pour le programmeur | N/A | 0 | 0 |  | http://www.samtec.com/technical-specifications/Default.aspx?seriesMaster=IDSD
C4, C9-C14, C15-C26,C30C29,C58, C34, C38,C40-C42 | MCU Températures Tensions CAN DCDC | 26 | CC0603KRX7R0BB104 | 100 nF = 0.1 uF | Condensateur céramique Découplage MCU (un seul !) Découplage ampli-Ops Découplage ISO1050 Condensateur Cboot (DCDC) | 0603 | 4.68 | 0.18 | Utilisé pour la plupart des 100nF du circuit 100V, +-10% | http://www.digikey.com/product-detail/en/CC0603KRX7R0BB104/311-1523-1-ND/3476112
(R45-R48) | Autre | 0 à 4 | - | ? Ohms | Résistances séries pour des entrées futures | 0608 | 0 |  | À déterminer au besoin
(R57-R64) | Autre | 0 à 4 | - | ? Ohms | Pull up et pull down pour utilisations futures | 0608 | 0
U11 | Autre | 1 | CPDT6-5V4-HF | - | 4 channel TVS | SOD-23-6 | 0.8 | 0.8
 |  |  |  |  |  | Prix total* | 80.27 |  | *Un circuit, prix des composantes à l'unité
