HarshJain/bmsafe/Slave_v2/STEP/Connecteur X1  IPL1-115-01-X-D-K.step

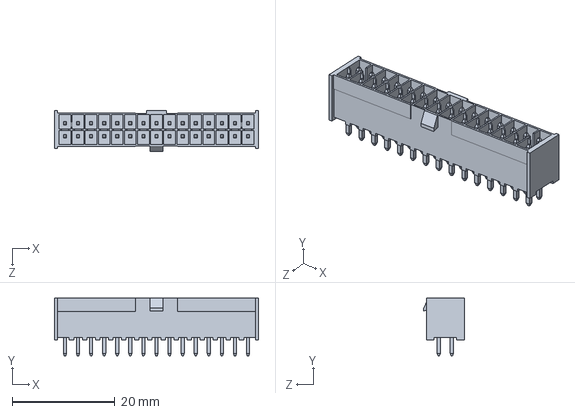
[picture p63: CAD file, 2015-01-25]
Slave_v2/STEP/Connecteur X1 IPL1-115-01-X-D-K.step
39.6 x 11.2 x 7.87 mm
