HarshJain/bmsafe/Slave_v2/STEP/Vis nylon M3 5mm94879A114.STEP

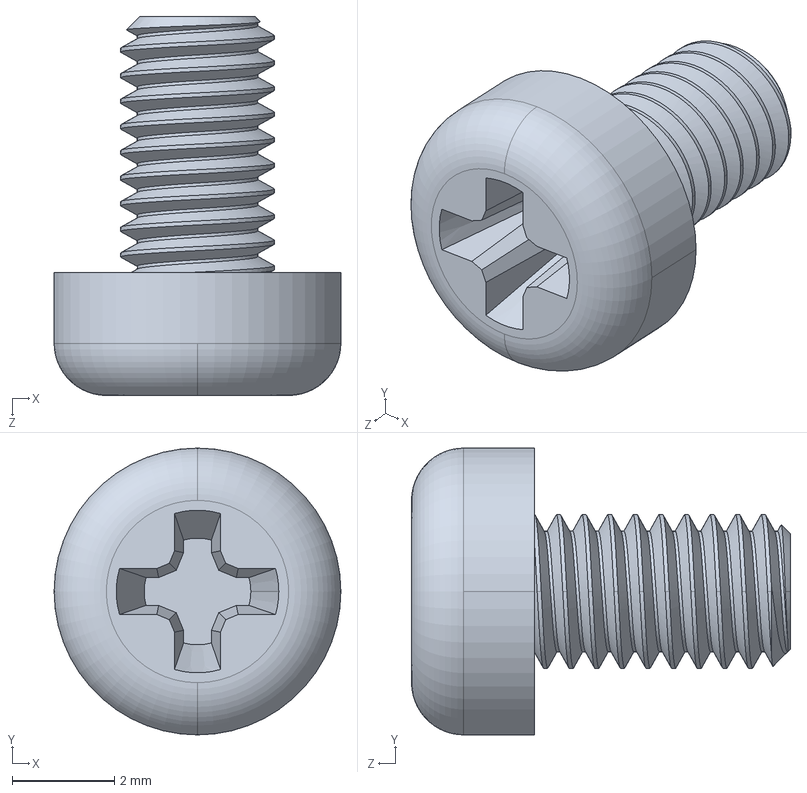
[picture p64: CAD file, 2015-01-25]
Slave_v2/STEP/Vis nylon M3 5mm94879A114.STEP
5.60 x 5.60 x 7.40 mm
