HarshJain/bmsafe/Slave_v2/STEP/Vis Nylon M3 8 mm NMS-308.IGS

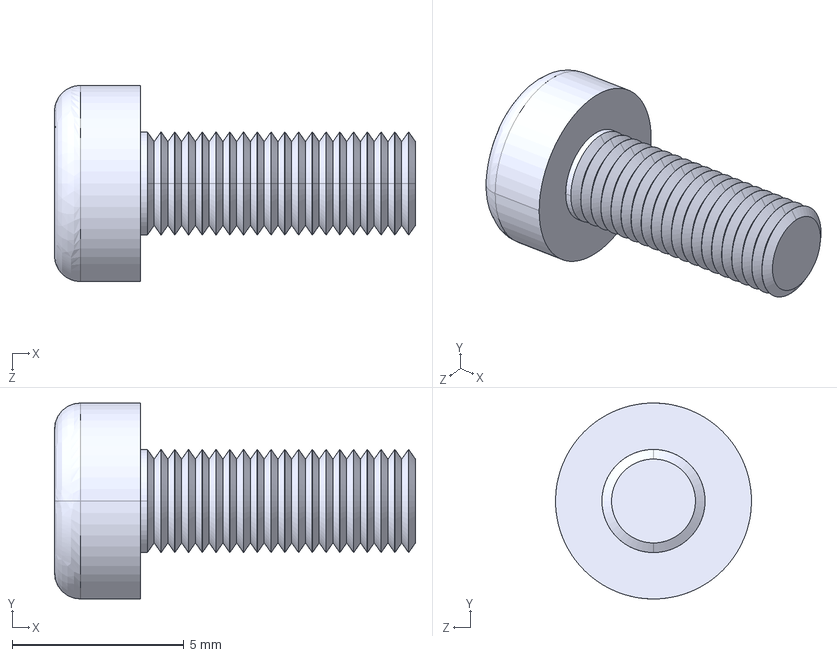
[picture p65: CAD file, 2015-01-25]
Slave_v2/STEP/Vis Nylon M3 8 mm NMS-308.IGS
10.5 x 5.70 x 5.70 mm
