HarshJain/bmsafe/Slave_v2/STEP/Connecteur de tensions   IPL1-115-01-X-D-RA-K.step

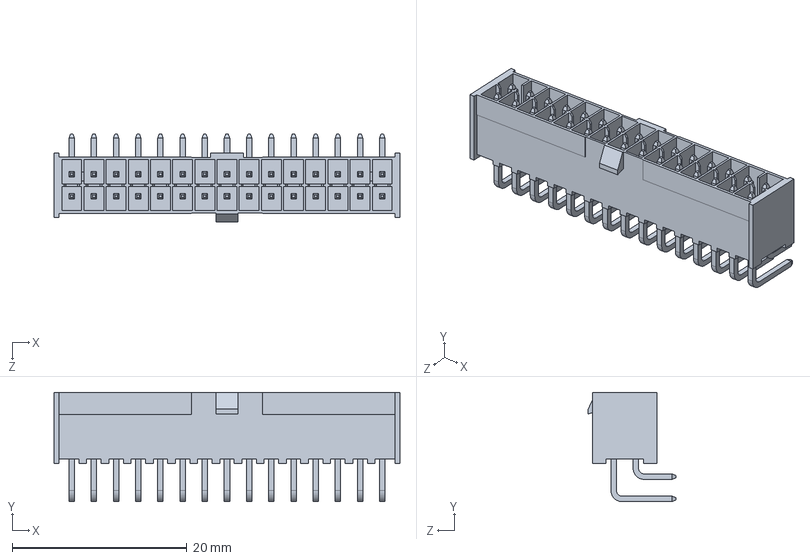
[picture p66: CAD file, 2015-01-25]
Slave_v2/STEP/Connecteur de tensions IPL1-115-01-X-D-RA-K.step
39.6 x 12.5 x 10.0 mm
