HarshJain/bmsafe/Slave_v2/STEP/Connecteur Panasonic_HEV2AN-P-DC24V (1).step

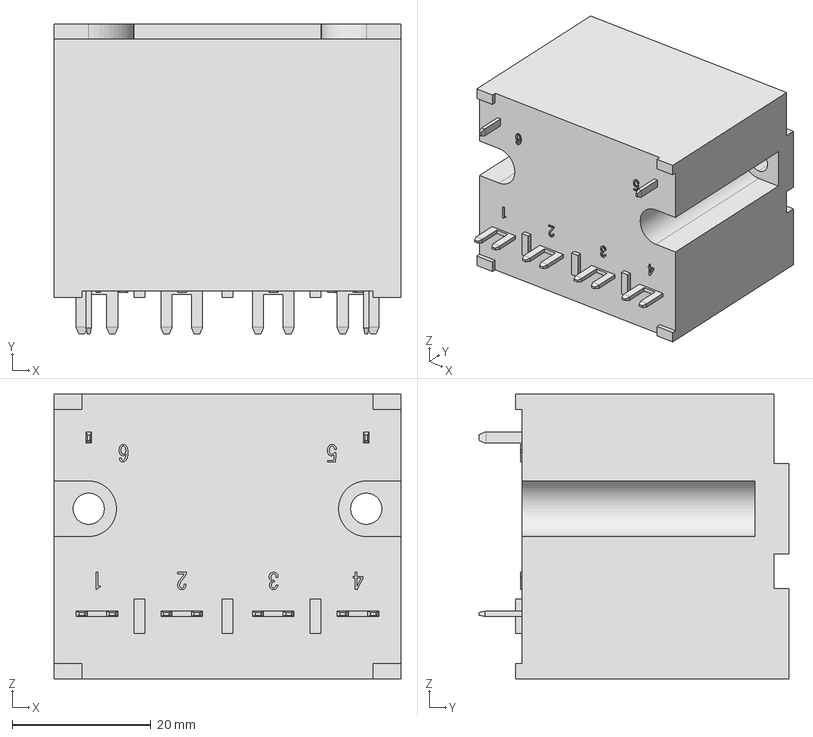
[picture p67: CAD file, 2015-01-25]
Slave_v2/STEP/Connecteur Panasonic_HEV2AN-P-DC24V (1).step
50.0 x 44.7 x 41.0 mm
