HarshJain/bmsafe/Slave_v2/STEP/Connecteur du CAN  IPL1-103-01-X-D-RA-K.step

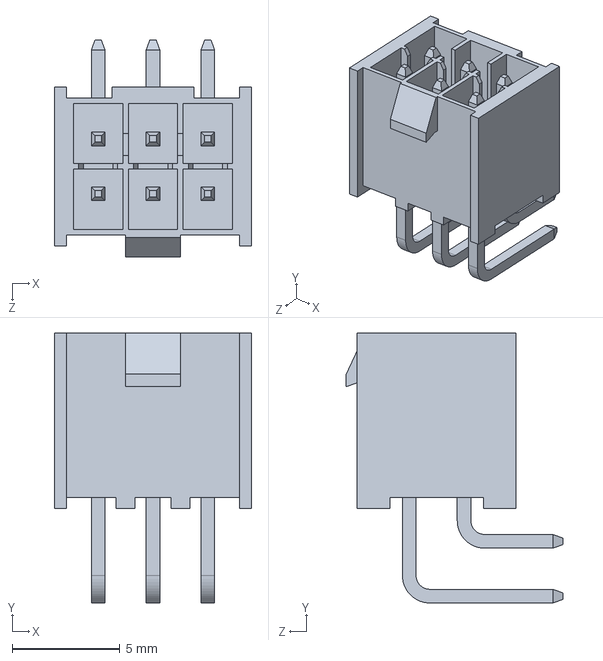
[picture p68: CAD file, 2015-01-25]
Slave_v2/STEP/Connecteur du CAN IPL1-103-01-X-D-RA-K.step
9.14 x 12.5 x 10.0 mm
