HarshJain/bmsafe/Slave_v2/STEP/Standoff Nylon M3  MTS-18.IGS

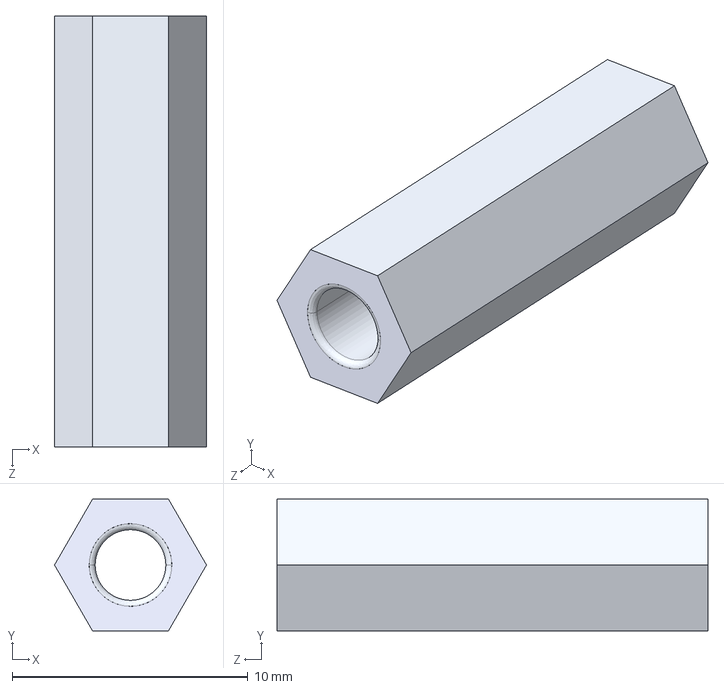
[picture p69: CAD file, 2015-01-25]
Slave_v2/STEP/Standoff Nylon M3 MTS-18.IGS
6.45 x 5.59 x 18.3 mm
