HarshJain/bmsafe/Slave_v2/STEP/Standoff Nylon M3 10 mm MTS-10.STEP

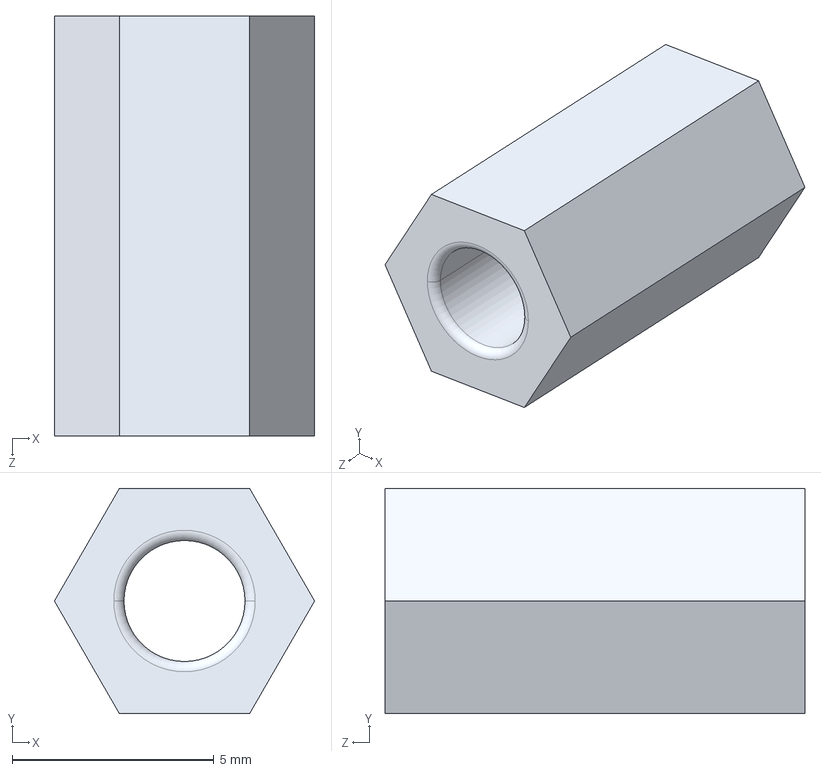
[picture p70: CAD file, 2015-01-25]
Slave_v2/STEP/Standoff Nylon M3 10 mm MTS-10.STEP
6.45 x 5.59 x 10.4 mm
