HarshJain/bmsafe/Slave_v2/STEP/Vis Nylon M3  6,4 mm NMS-306.IGS

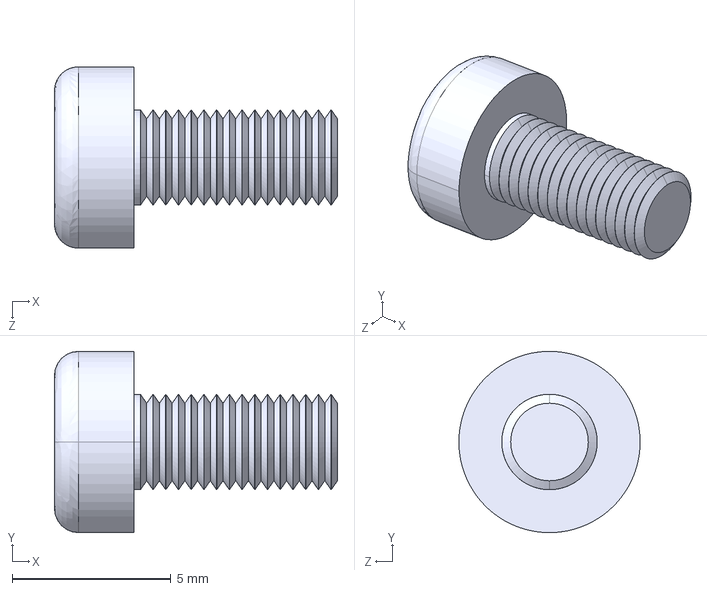
[picture p71: CAD file, 2015-01-25]
Slave_v2/STEP/Vis Nylon M3 6,4 mm NMS-306.IGS
8.90 x 5.70 x 5.70 mm
