HarshJain/bmsafe/(list of files, cad)

Other CAD files:
BoiteBatteries/Batterie_asm1.CATProduct
BoiteBatteries/Battery_box_1st_floor.CATPart
BoiteBatteries/Battery_box_2nd_floor.CATPart
BoiteBatteries/Battery_box_90_angle_00.CATPart
BoiteBatteries/Battery_box_90_angle_01.CATPart
BoiteBatteries/Battery_box_90_angle_02.CATPart
BoiteBatteries/Battery_box_90_angle_03.CATPart
BoiteBatteries/Battery_box_90_angle_04.CATPart
BoiteBatteries/Battery_box_90_angle_05.CATPart
BoiteBatteries/Battery_box_90_angle_06.CATPart
BoiteBatteries/Battery_box_back_panel_00.CATPart
BoiteBatteries/Battery_box_back_panel_00_asm.CATProduct
BoiteBatteries/Battery_box_ceiling_v2.CATPart
BoiteBatteries/Battery_box_front_panel_00.CATPart
BoiteBatteries/Battery_box_front_panel_00_asm.CATProduct
BoiteBatteries/Battery_box_side_panel_00.CATPart
BoiteBatteries/Battery_box_side_panel_00_asm.CATProduct
BoiteBatteries/Battery_box_side_panel_01.CATPart
BoiteBatteries/Battery_box_side_panel_01_asm.CATProduct
BoiteBatteries/Battery_box_side_panel_02.CATPart
BoiteBatteries/Battery_box_side_panel_02_asm.CATProduct
BoiteBatteries/Nut_M10_90591A171.CATPart
BoiteBatteries/Plaque_coroplast.CATPart
BoiteBatteries/Threaded_rod_M10_190mm_93275A047.CATPart
BoiteBatteries/Threaded_rod_M10_335mm_90024A463.CATPart
BoiteBatteries/_Battery_box_asm_v2.CATProduct
