HarshJain/bmsafe/Slave_v2/Tests/Calibration_termistances/0_General_setup.jpg

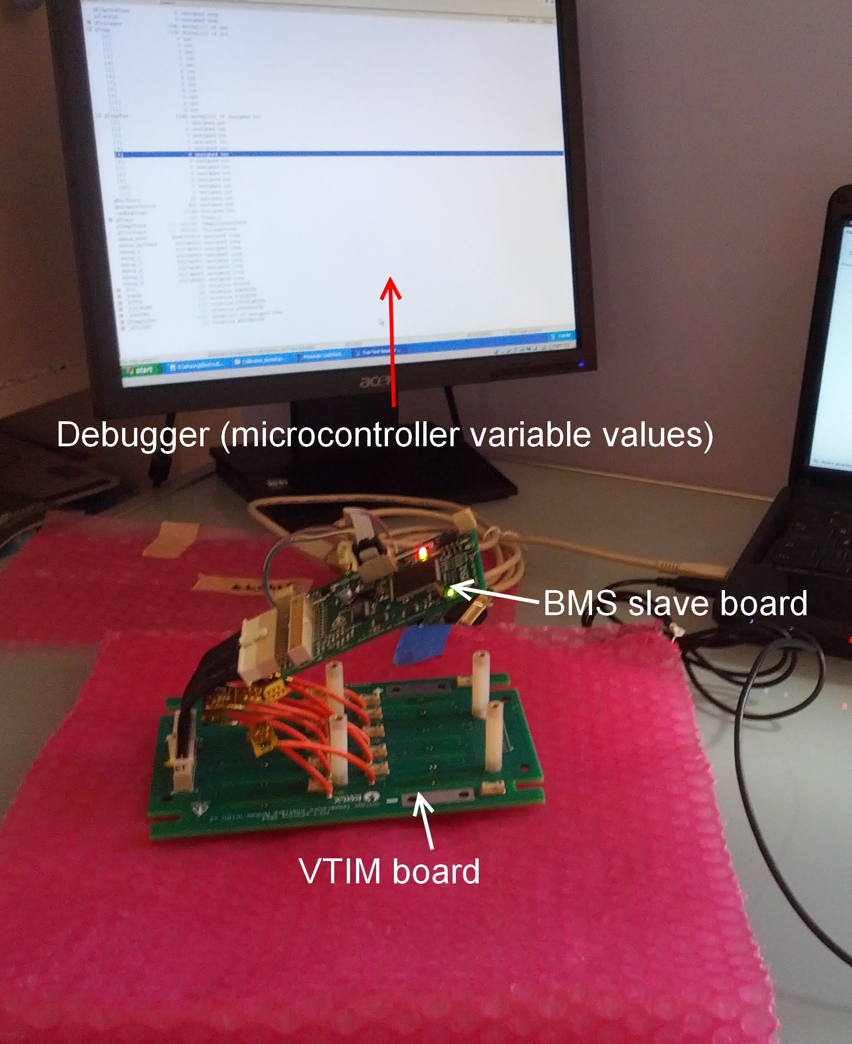
Slave_v2/Tests/Calibration_termistances/0_General_setup.jpg
