HarshJain/bmsafe/Slave_v2/Tests/Calibration_termistances/7_ice_water_setup_odd.jpg

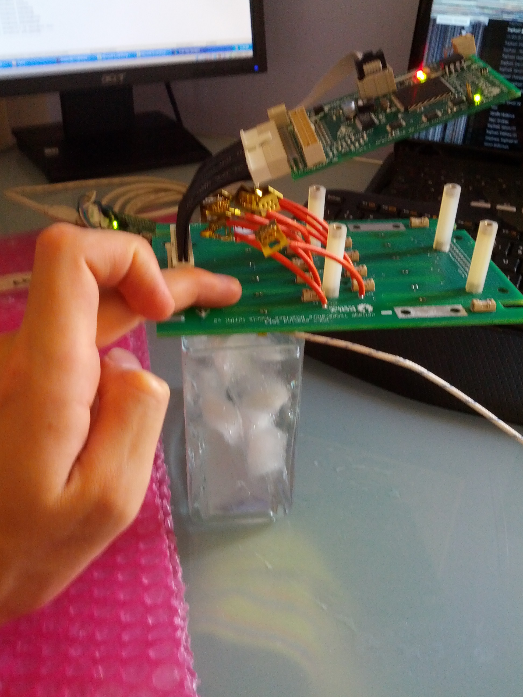
Slave_v2/Tests/Calibration_termistances/7_ice_water_setup_odd.jpg
