HarshJain/bmsafe/Slave_v2/Tests/Calibration_termistances/Calibration_termistances.xlsx

Sheet: README
L'objectif de ce document et les calculs faits est de générer une table de correspondance Tension-Température pour la calibration des thermistances du BMS. L'onglet Comparaison fait une comparaison entre la valeur théorique de la résistance calculée à partir de la formule R = R25 exp( B (1/T - 1/T25)) et la valeur réelle de la résistance calculée à partir des tableaux des spécifications du thermistor (Selco Thin-Film Thermistor TF Series TF-F010K-1-1). Ces calculs nous permettent de trouver une formule d'erreur entre la valeur théorique et réelle nous permettant, dans l'onglet Valeur_corrigée, de trouver une formule mathématique nous donnant une courbe fiable de la valeur de la résistance. La formule ainsi trouvée permet d'obtenir une table plus complète que celle fournie par les spécifications qui ne donnent la résistance que chaque 10°C. La table de correspondance est faite à partir de cette valeur de résistance corrigée.
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
