HarshJain/bmsafe/Slave_v2/Tests/Calibration_termistances/1_Thermistors.jpg

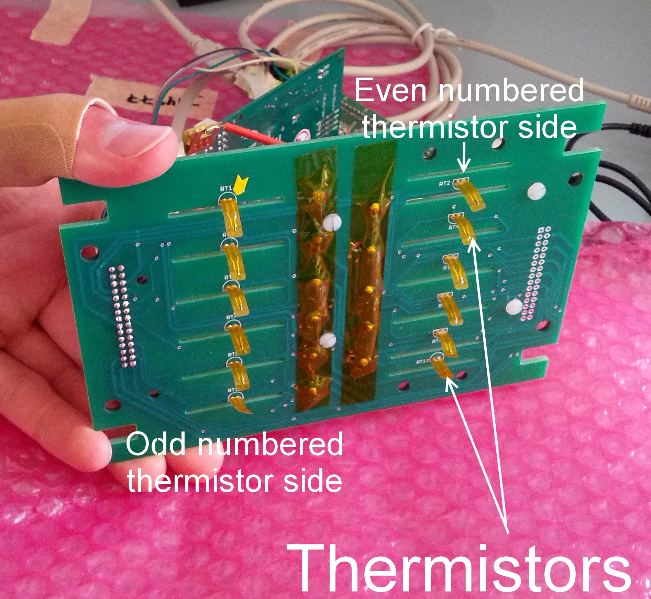
Slave_v2/Tests/Calibration_termistances/1_Thermistors.jpg
