HarshJain/bmsafe/Slave_v2/Tests/Calibration_termistances/3_ambient_temp_measurement.jpg

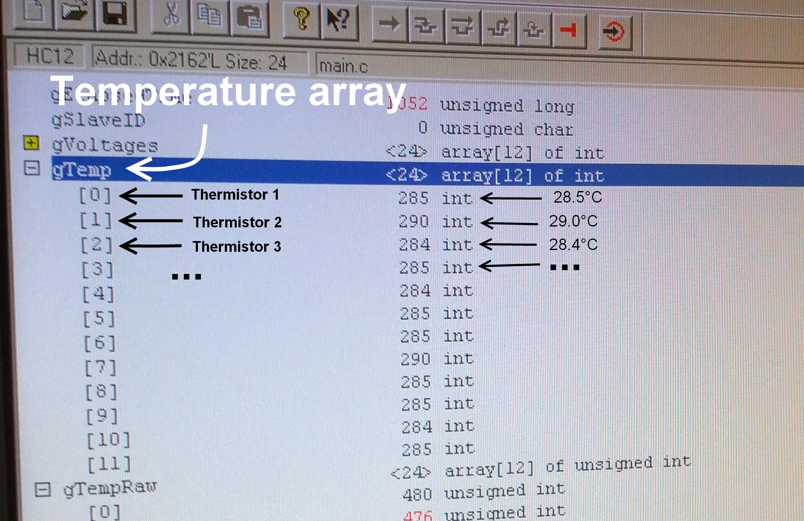
Slave_v2/Tests/Calibration_termistances/3_ambient_temp_measurement.jpg
