HarshJain/bmsafe/Slave_v2/Tests/Calibration_termistances/5_iced_water_temp.jpg

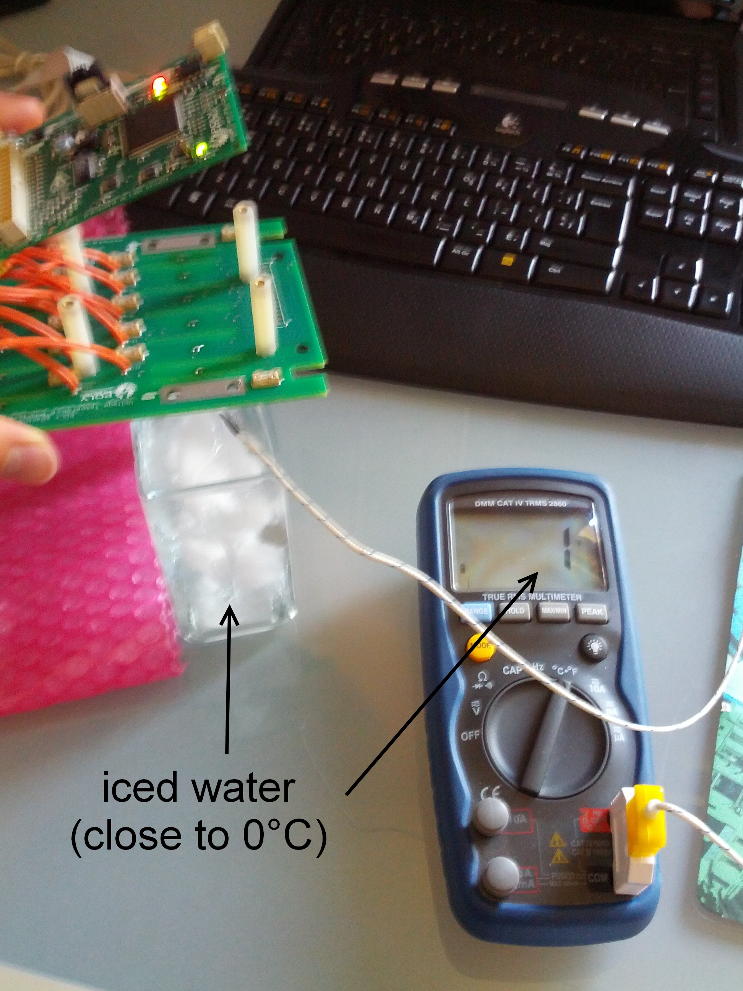
Slave_v2/Tests/Calibration_termistances/5_iced_water_temp.jpg
