HarshJain/bmsafe/Slave_v2/Tests/Calibration_termistances/6_iced_water_measurement_even.jpg

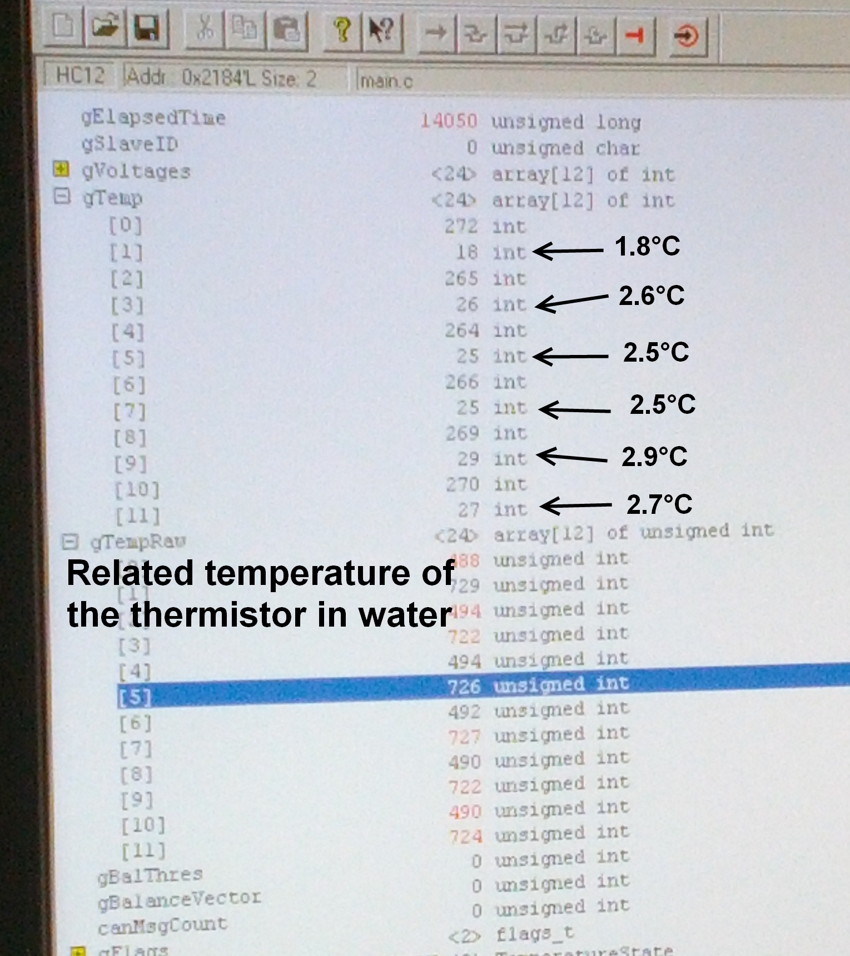
Slave_v2/Tests/Calibration_termistances/6_iced_water_measurement_even.jpg
