HarshJain/bmsafe/Slave_v2/Tests/Calibration_termistances/8_iced_water_measurement_odd.jpg

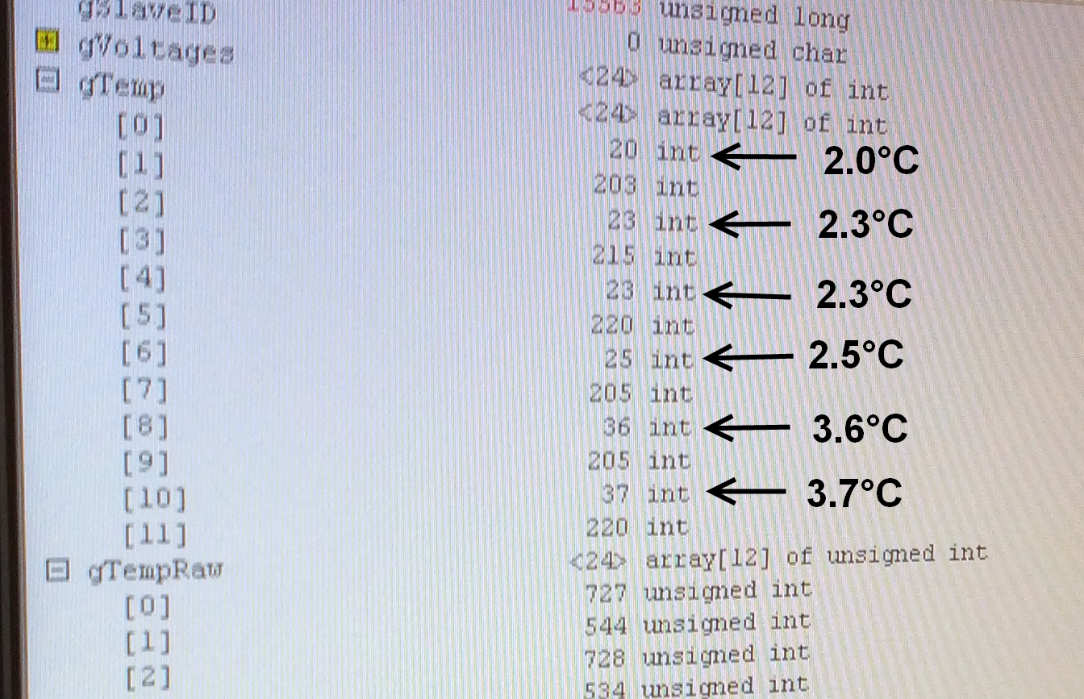
Slave_v2/Tests/Calibration_termistances/8_iced_water_measurement_odd.jpg
