HarshJain/bmsafe/Slave_v2/Tests/Calibration_termistances/9_Hot_water_temp.jpg

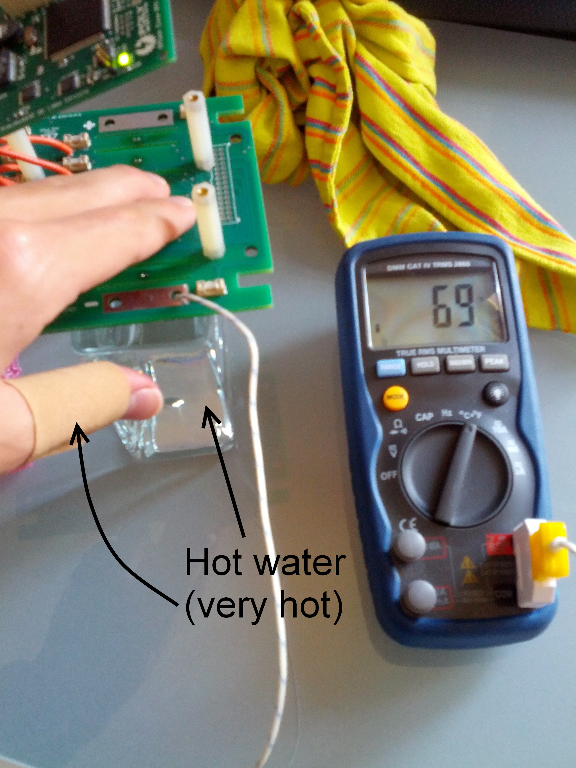
Slave_v2/Tests/Calibration_termistances/9_Hot_water_temp.jpg
