HarshJain/bmsafe/Slave_v2/Tests/Calibration_termistances/11_Hot_water_measurement_odd.jpg

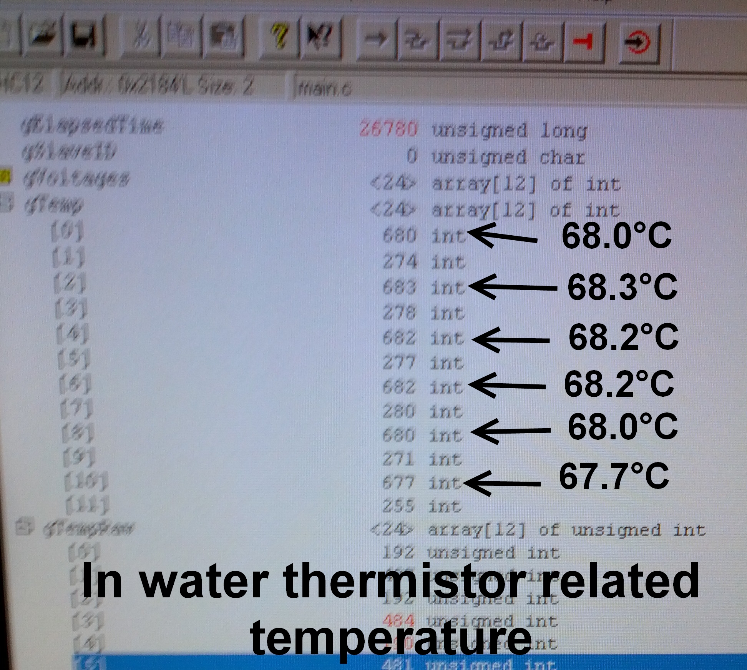
Slave_v2/Tests/Calibration_termistances/11_Hot_water_measurement_odd.jpg
