HarshJain/bmsafe/Slave_v2/Tests/Calibration_termistances/Original pictures/IMG_20140830_134448.jpg

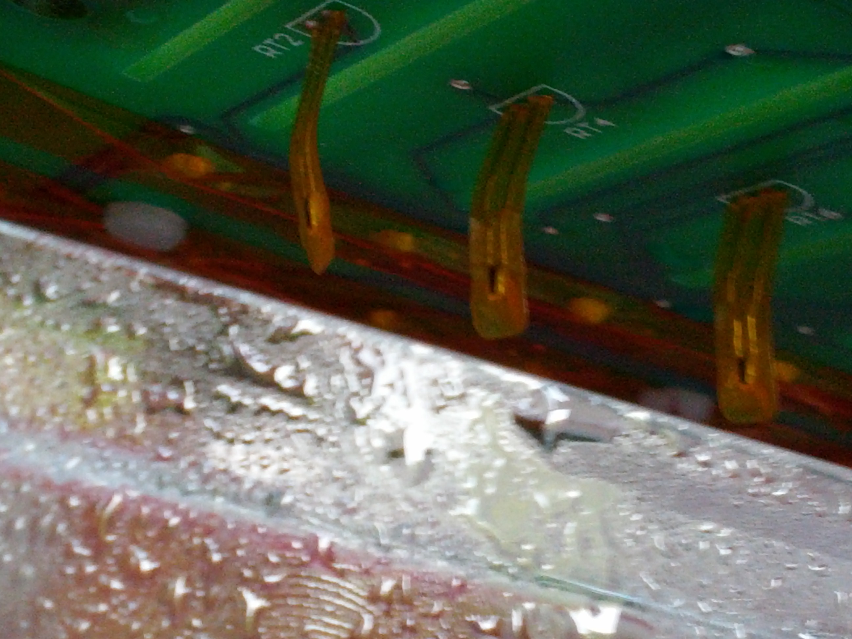
Slave_v2/Tests/Calibration_termistances/Original pictures/IMG_20140830_134448.jpg
