HarshJain/bmsafe/Slave_v2/Tests/Calibration_termistances/Original pictures/IMG_20140830_144944.jpg

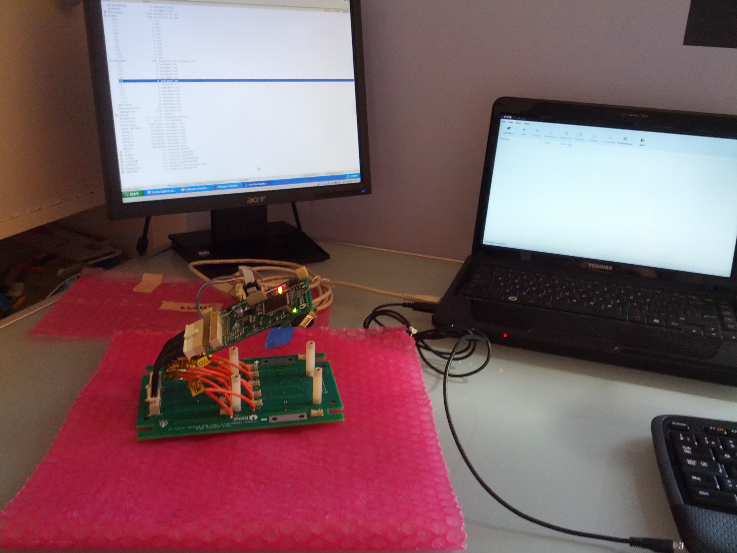
Slave_v2/Tests/Calibration_termistances/Original pictures/IMG_20140830_144944.jpg
