HarshJain/bmsafe/Master_v2/PCB/Changelog.txt

BMS MASTER - POLY eRACING
********CHANGELOG********

V2.0

- CHANGEMENT DE MCU (MC9S12XEP100MAG AU LIEU DE MC9S12XEP100MAL).
- AJOUT ET VÉRIFICATION DES ALIMENTATIONS DU MCU.
- AJOUT DES CAPACITÉS DE DÉCOUPLAGE POUR VDD/VSS MCU. 
- AJOUT DES TRACES MANQUANTES.
- AJOUT D'UN CONDENSATEUR DE DÉCOUPLAGE ENTRE 2 PINS DU CANL0.
- AJOUT D'UN MOSFET POUR RELAI DÉCHARGE.
- AJOUT D'UN HEADER 10 PINS POUR EXTENSION 7 SEGMENTS.
- CHANGEMENT DES CONNECTEURS SCREWLESS POUR DES TYCO EUROSTYLE (282836).
- AJOUT D'UN CONNECTEUR TYCO EUROSTYLE 8 POSITIONS POUR LES ENTRÉES.
- PROTECTION PAR OPTOCOUPLEUR DE 2 SORTIES DU BMS (LED_BMS_DASH ET DCDC_RELAY).
- PROTECTION PAR 2 DIODES EN INVERSE (AU 5V_MST ET AU GND_MST) DE 4 ENTRÉES + PULL-DOWN RESISTOR.
- CONNECTION DIRECTE AU MCU DE 4 ENTRÉES JUGÉES SÉCURITAIRES (0-5V, VENANT DU DCDC ET DU IMD).
- AJOUT DIODE POUR "FREE-WHEEL CURRENT" ENTRE LE DRAIN ET LE +24V DES MOSFET POUR LES RELAIS.

LES ERC ONT ÉTÉ VÉRIFIÉS EN FONCTION DES SPÉCIFICATIONS DE LABO CIRCUITS.
IL RESTE À METTRE LE TEXTE ET LE LOGO DE POLY eRACING.
