HarshJain/bmsafe/Slave_v2/EaglePCB/v2.1/Changelog.txt

Version 2.1

- Correction of minor errors in design : removed two passive useless components.
