HarshJain/bmsafe/Slave_v2/Design_documents/DCDC_online_design.pdf

## WEBENCH ® Design Report

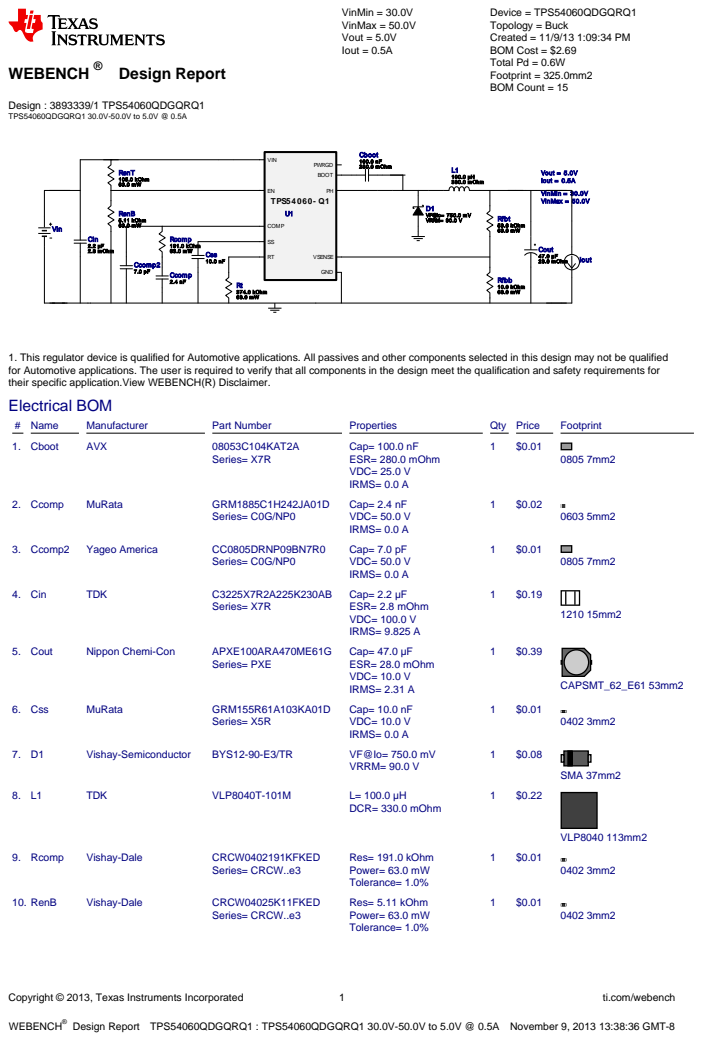
[picture p95: page 1]
Copyright © 2013, Texas Instruments Incorporated; ti.com/webench; WEBENCH®; Design : 3893339/1 TPS54060QDGQRQ1 TPS54060QDGQRQ1 30.0V-50.0V to 5.0V @ 0.5A; VinMin = 30.0V VinMax = 50.0V Vout = 5.0V Iout = 0.5A; Device = TPS54060QDGQRQ1 Topology = Buck Created = 11/9/13 1:09:34 PM BOM Cost = $2.69 Total Pd = 0.6W Footprint = 325.0mm2 BOM Count = 15; Cboot 100.0 nF 280.0 mOhm; Ccomp 2.4 nF; Ccomp2 7.0 pF; Cin 2.2 µF; 2.8 mOhm; Cout; 47.0 µF 28.0 mOhm; Css 10.0 nF; D1 VF@Io= 750.0 mV VRRM= 90.0 V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

1. This regulator device is qualified for Automotive applications. All passives and other components selected in this design may not be qualified
for Automotive applications. The user is required to verify that all components in the design meet the qualification and safety requirements for
their specific application.View WEBENCH(R) Disclaimer.
Electrical BOM

Design Report TPS54060QDGQRQ1 : TPS54060QDGQRQ1 30.0V-50.0V to 5.0V @ 0.5A November 9, 2013 13:38:36 GMT-8

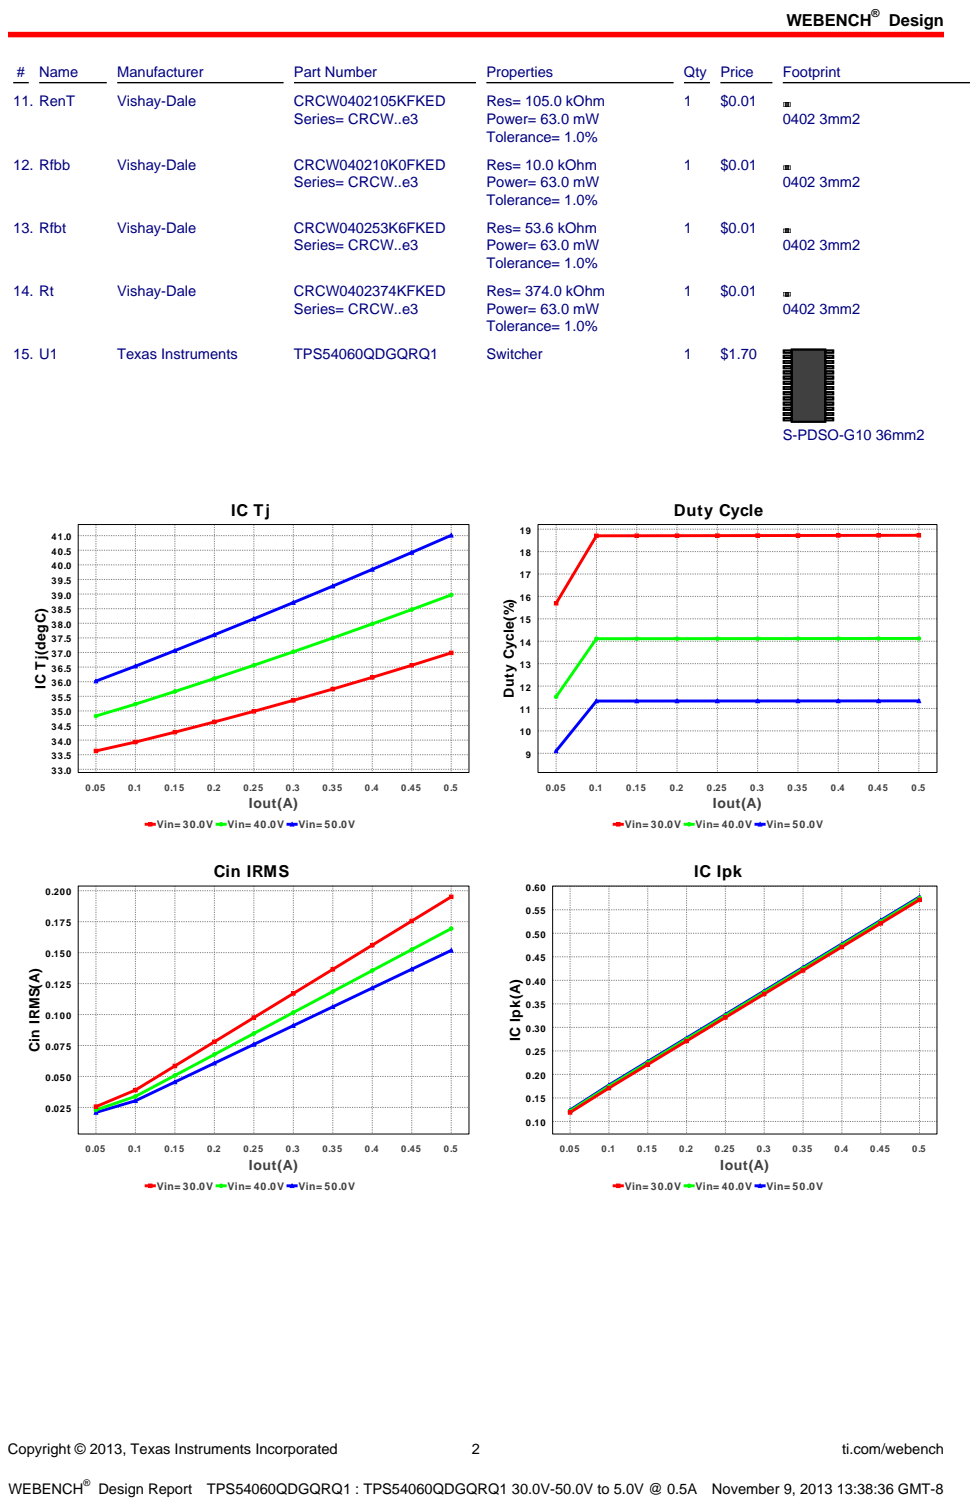
[picture p96: page 2]
Design; Copyright © 2013, Texas Instruments Incorporated; ti.com/webench; # Name; Manufacturer; Part Number; Properties; Qty Price; Footprint; 11. RenT; Vishay-Dale; CRCW0402105KFKED; Series= CRCW..e3; Res= 105.0 kOhm Power= 63.0 mW Tolerance= 1.0%; 12. Rfbb; CRCW040210K0FKED; Res= 10.0 kOhm Power= 63.0 mW Tolerance= 1.0%; 13. Rfbt; CRCW040253K6FKED; Res= 53.6 kOhm Power= 63.0 mW Tolerance= 1.0%; CRCW0402374KFKED; Res= 374.0 kOhm Power= 63.0 mW Tolerance= 1.0%; Texas Instruments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

IC Tj(degC)

Vin= 30.0V Vin= 40.0V Vin= 50.0V

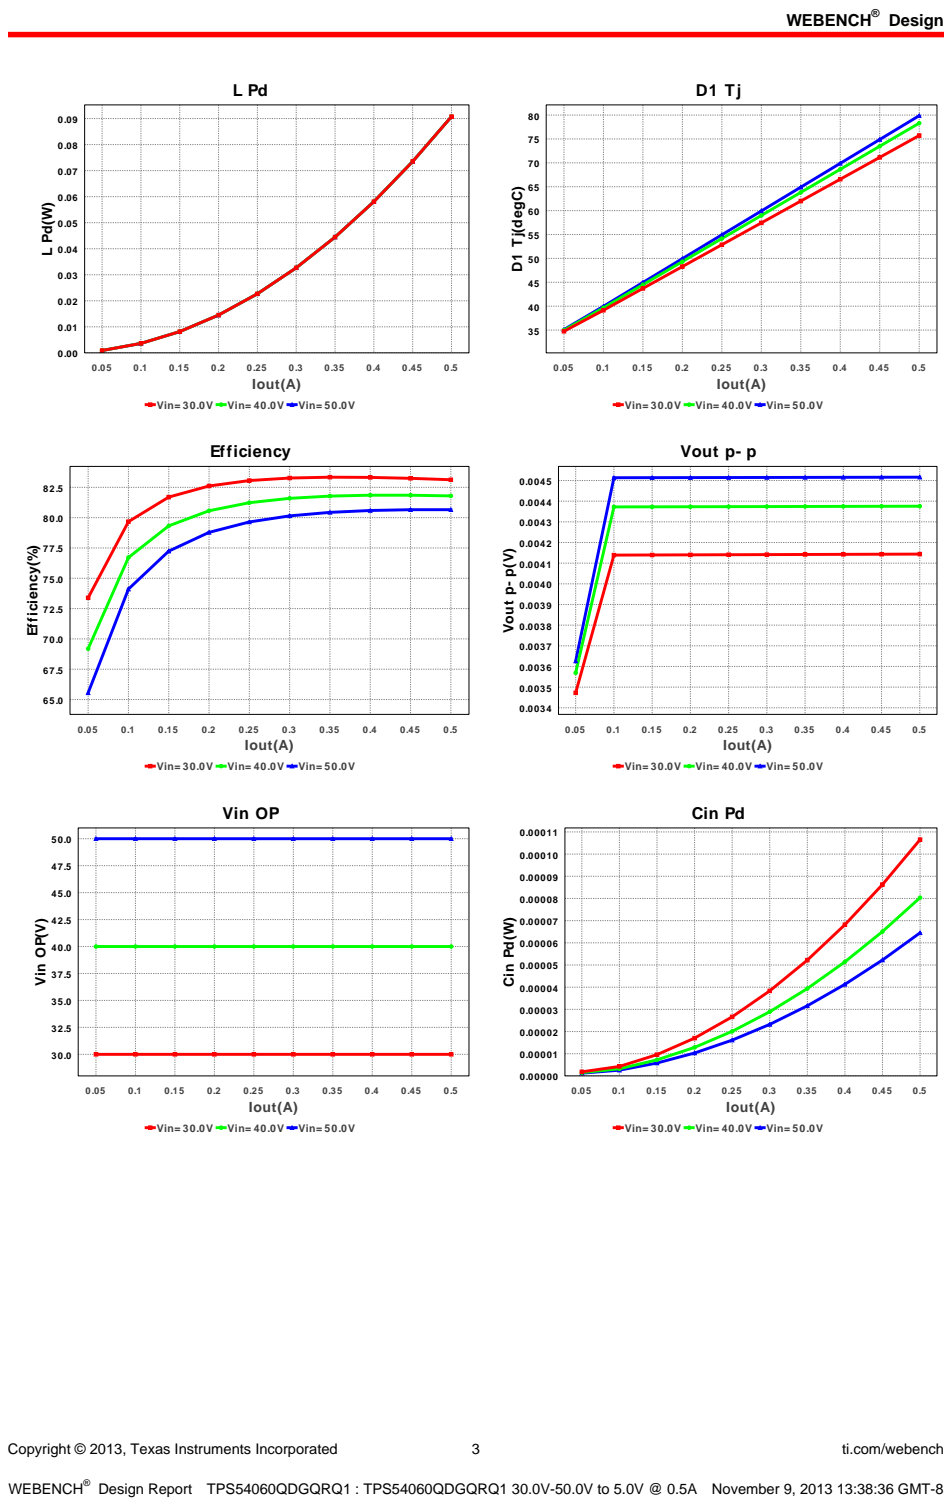
[picture p97: page 3]
Copyright © 2013, Texas Instruments Incorporated; ti.com/webench; Iout(A); D1 Tj(degC); Efficiency; Efficiency(%); Vout p- p; Vout p- p(V); Vin OP; Vin OP(V); Cin Pd; Cin Pd(W)

Vin= 30.0V Vin= 40.0V Vin= 50.0V

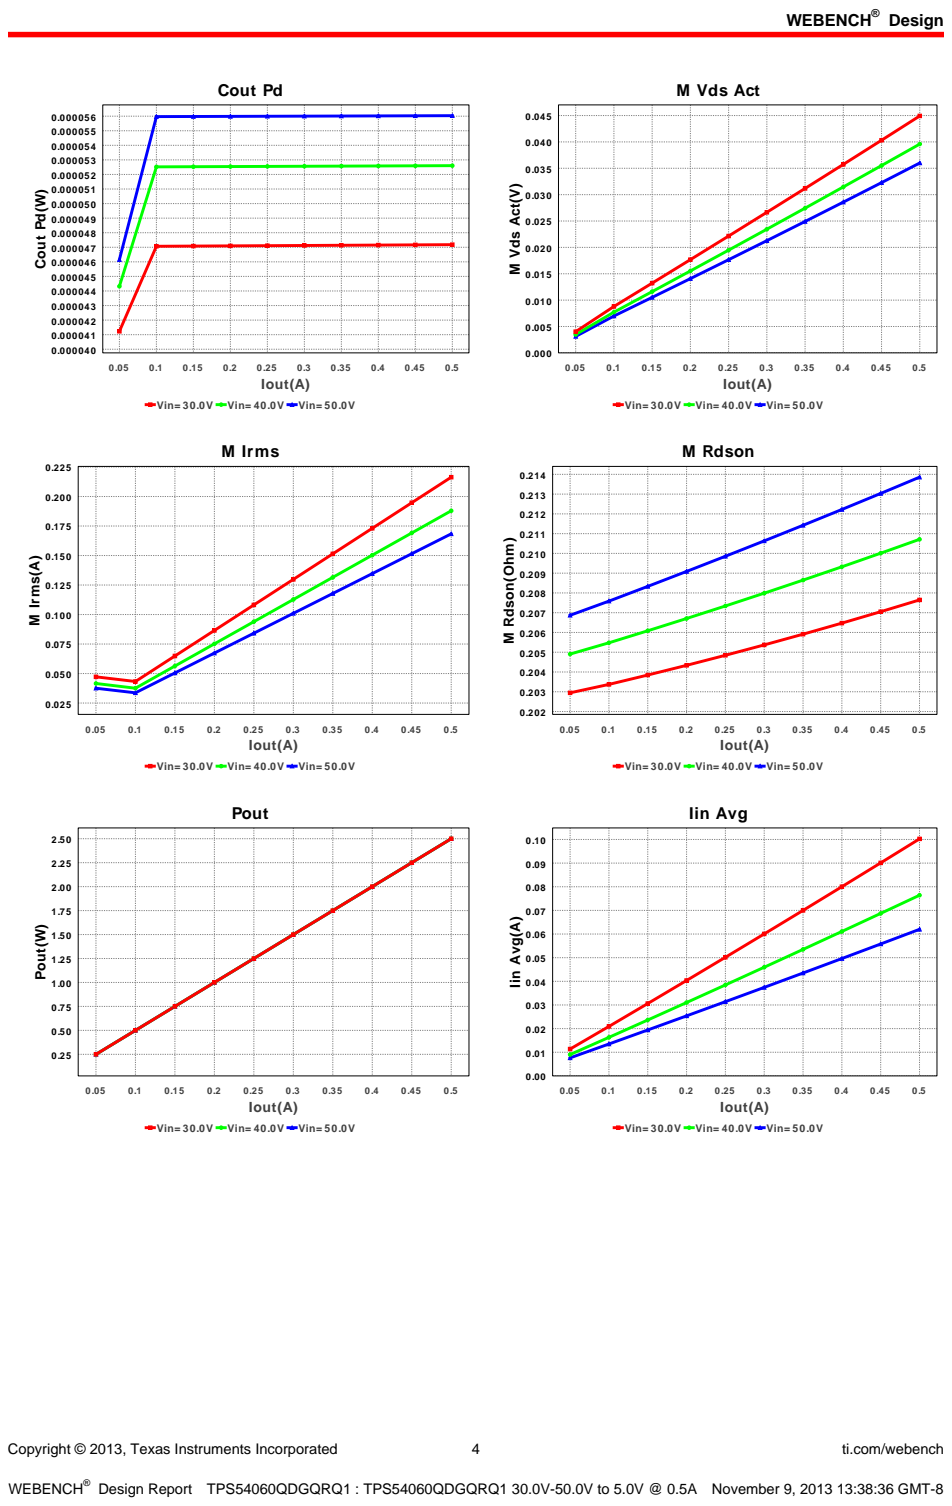
[picture p98: page 4]
Copyright © 2013, Texas Instruments Incorporated; ti.com/webench; Cout Pd; Iout(A); Cout Pd(W); M Vds Act; M Vds Act(V); M Irms; M Irms(A); M Rdson; M Rdson(Ohm); Pout; Pout(W); Iin Avg; Iin Avg(A)

Vin= 30.0V Vin= 40.0V Vin= 50.0V

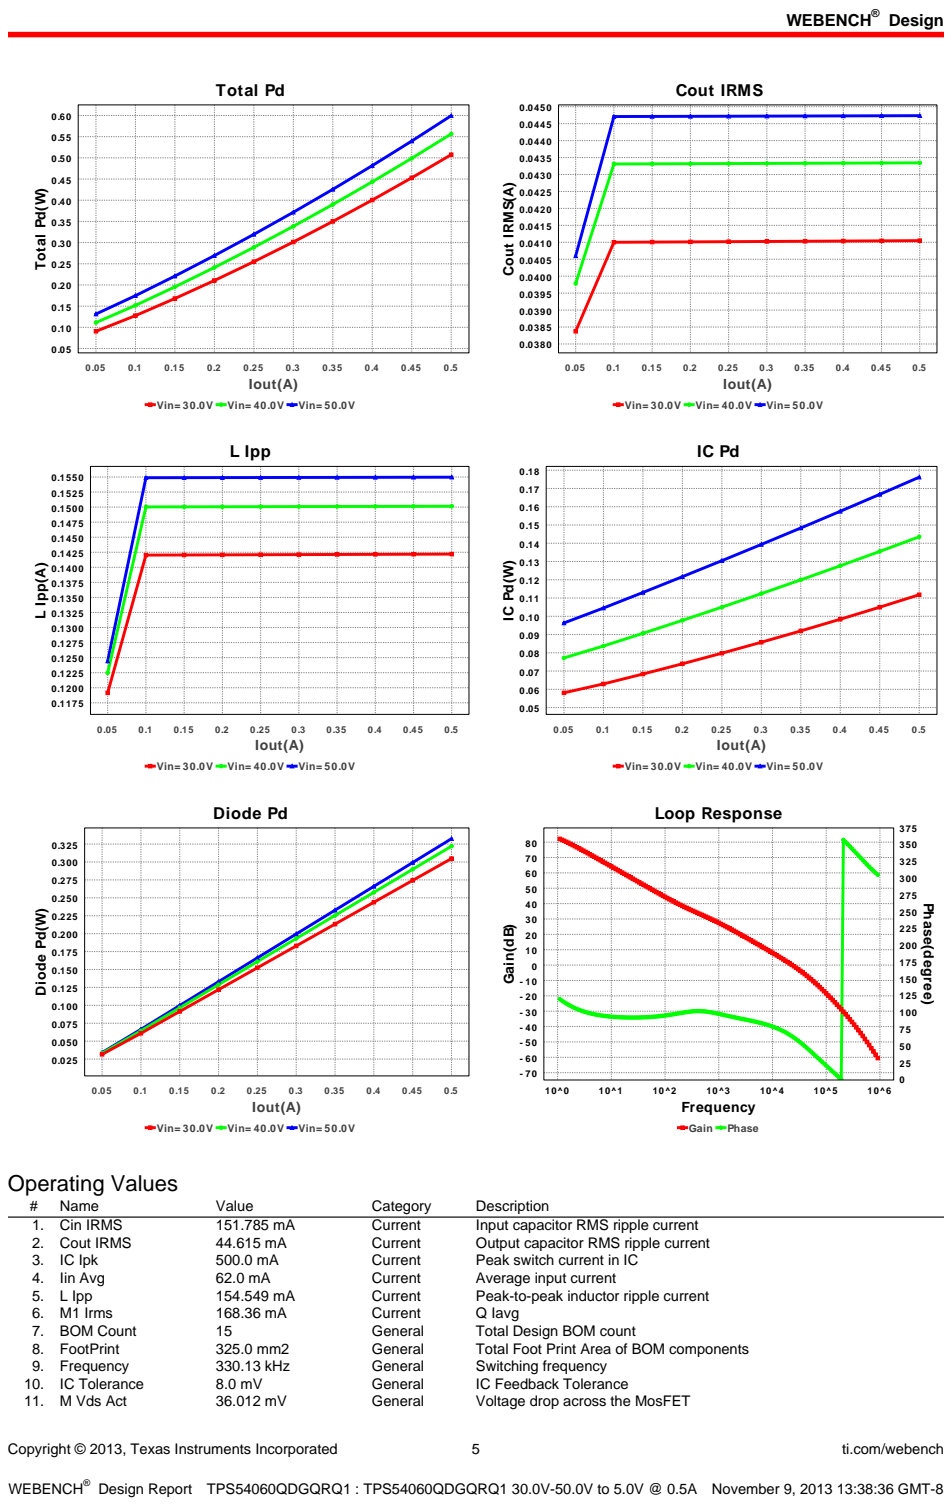
[picture p99: page 5]
Copyright © 2013, Texas Instruments Incorporated; ti.com/webench; Total Pd; Iout(A); Total Pd(W); Cout IRMS; Cout IRMS(A); L Ipp; L Ipp(A); Diode Pd; Diode Pd(W); Loop Response; Gain Phase; 10^6 Frequency; Gain(dB); Phase(degree); Operating Values; Name; Value; Category; Description; 1. Cin IRMS; Current; Input capacitor RMS ripple current; 2. Cout IRMS; Output capacitor RMS ripple current; 3. IC Ipk; Peak switch current in IC; 4. Iin Avg; Average input current; 5. L Ipp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

Vin= 30.0V Vin= 40.0V Vin= 50.0V

Copyright © 2013, Texas Instruments Incorporated | 6 | ti.com/webench
# | Name | Value | Category | Description

12. Pout | 2.5 W | General | Total output power
13. Total BOM | $2.69 | General | Total BOM Cost
14. D1 Tj | 79.872 degC | Op_Point | D1 junction temperature
15. Vout OP | 5.0 V | Op_Point | Operational Output Voltage
16. Cross Freq | 23.278 kHz | Op_point | Bode plot crossover frequency
17. Duty Cycle | 11.338 % | Op_point | Duty cycle
18. Efficiency | 80.646 % | Op_point | Steady state efficiency
19. IC Tj | 41.039 degC | Op_point | IC junction temperature
20. ICThetaJA | 62.5 degC/W | Op_point | IC junction-to-ambient thermal resistance
21. IOUT_OP | 500.0 mA | Op_point | Iout operating point
22. Phase Marg | 64.855 deg | Op_point | Bode Plot Phase Margin
23. VIN_OP | 50.0 V | Op_point | Vin operating point
24. Vout p-p | 4.503 mV | Op_point | Peak-to-peak output ripple voltage
25. Cin Pd | 64.508 µW | Power | Input capacitor power dissipation
26. Cout Pd | 55.733 µW | Power | Output capacitor power dissipation
27. Diode Pd | 332.482 mW | Power | Diode power dissipation
28. IC Pd | 176.628 mW | Power | IC power dissipation
29. L Pd | 90.75 mW | Power | Inductor power dissipation
30. Total Pd | 599.974 mW | Power | Total Power Dissipation

## Design Inputs

# | Name | Value | Description

1. Iout | 500.0 mA | Maximum Output Current
2. Iout1 | 500.0 mAmps | Output Current #1
3. SoftStart | 3.0 ms | Soft Start Time (ms)
4. VinMax | 50.0 V | Maximum input voltage
5. VinMin | 30.0 V | Minimum input voltage
6. Vout | 5.0 V | Output Voltage
7. Vout1 | 5.0 Volt | Output Voltage #1
8. base_pn | TPS54060-Q1 | Base Product Number
9. source | DC | Input Source Type
10. Ta | 30.0 degC | Ambient temperature
11. UserFsw | 590.477 kHz | Customer Selected Frequency

## Design Assistance

1. The TPS54060-Q1 is qualified for Automotive applications. All passives and other components selected in this design may not be qualified for Automotive applications. The user is required to verify that all components in the design meet the qualification and safety requirements for their specific application
2. TPS54060-Q1 Product Folder : http://www.ti.com/product/tps54060-q1 : contains the data sheet and other resources.

Texas Instruments' WEBENCH simulation tools attempt to recreate the performance of a substantially equivalent physical implementation
of the design. Simulations are created using Texas Instruments' published specifications as well as the published specifications of other device manufacturers. While Texas Instruments does update this information periodically, this information may not be current at the time the simulation is built. Texas Instruments does not warrant the accuracy or completeness of the specifications or any information contained therein. Texas Instruments does not warrant that any designs or recommended parts will meet the specifications you entered, will be suitable for your application or fit for any particular purpose, or will operate as shown in the simulation in a physical implementation. Texas Instruments does not warrant that the designs are production worthy.
You should completely validate and test your design implementation to confirm the system functionality for your application prior to production.
Use of Texas Instruments' WEBENCH simulation tools is subject to Texas Instruments' Site Terms and Conditions of Use. (http://www.ti.com/corp/docs/legal/termsofuse.shtml) Prototype boards based on WEBENCH created designs are provided AS IS without warranty of any kind for evaluation and testing purposes and are subject to the terms of the Evaluation License Agreement. (http://www.ti.com/corp/docs/legal/termsofuse_estore.shtml)
