HarshJain/bmsafe/Slave_v2/EaglePCB/v2.1/BMS_Slave2.1_schema.pdf

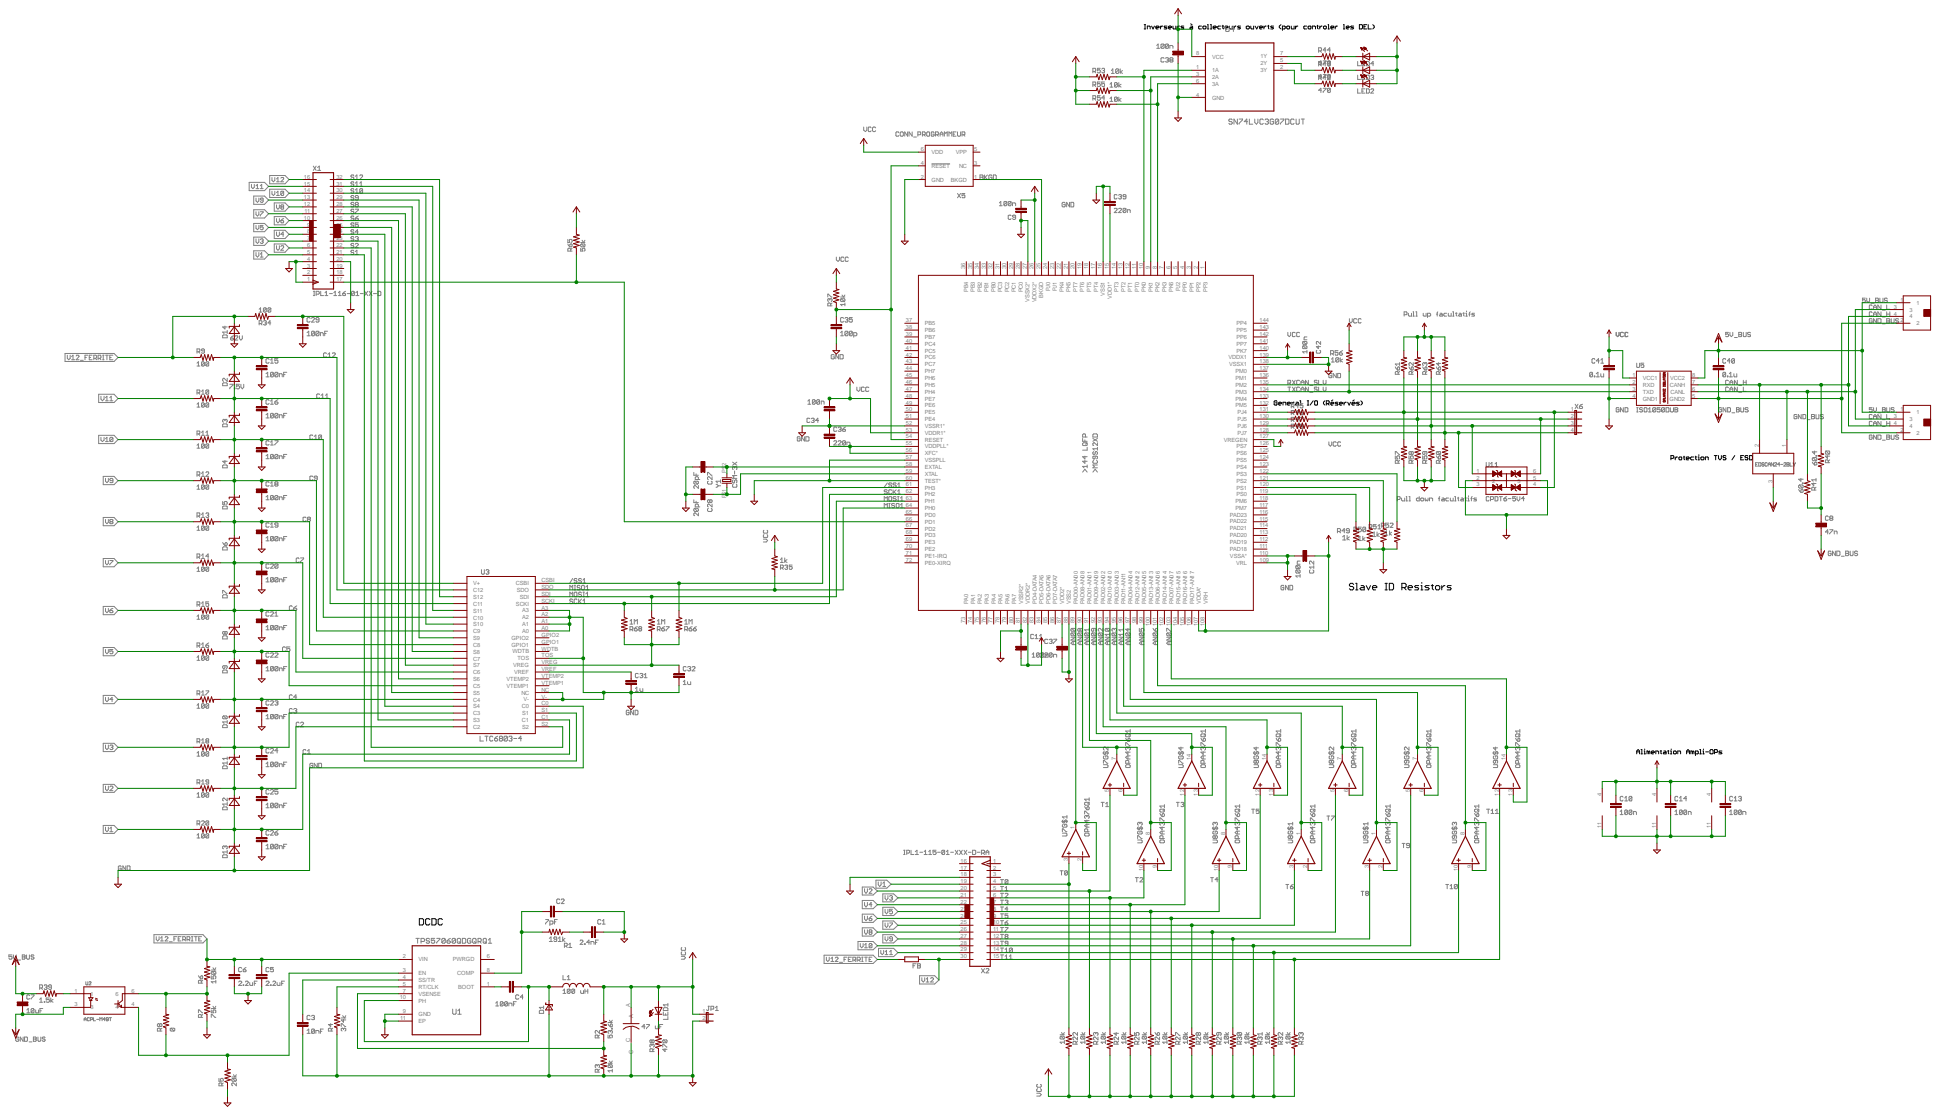
[picture p100: page 1]
