HarshJain/bmsafe/Master_v2/Software/Documentation/Flowcharts/BMS_master_relay_flowchart.pdf

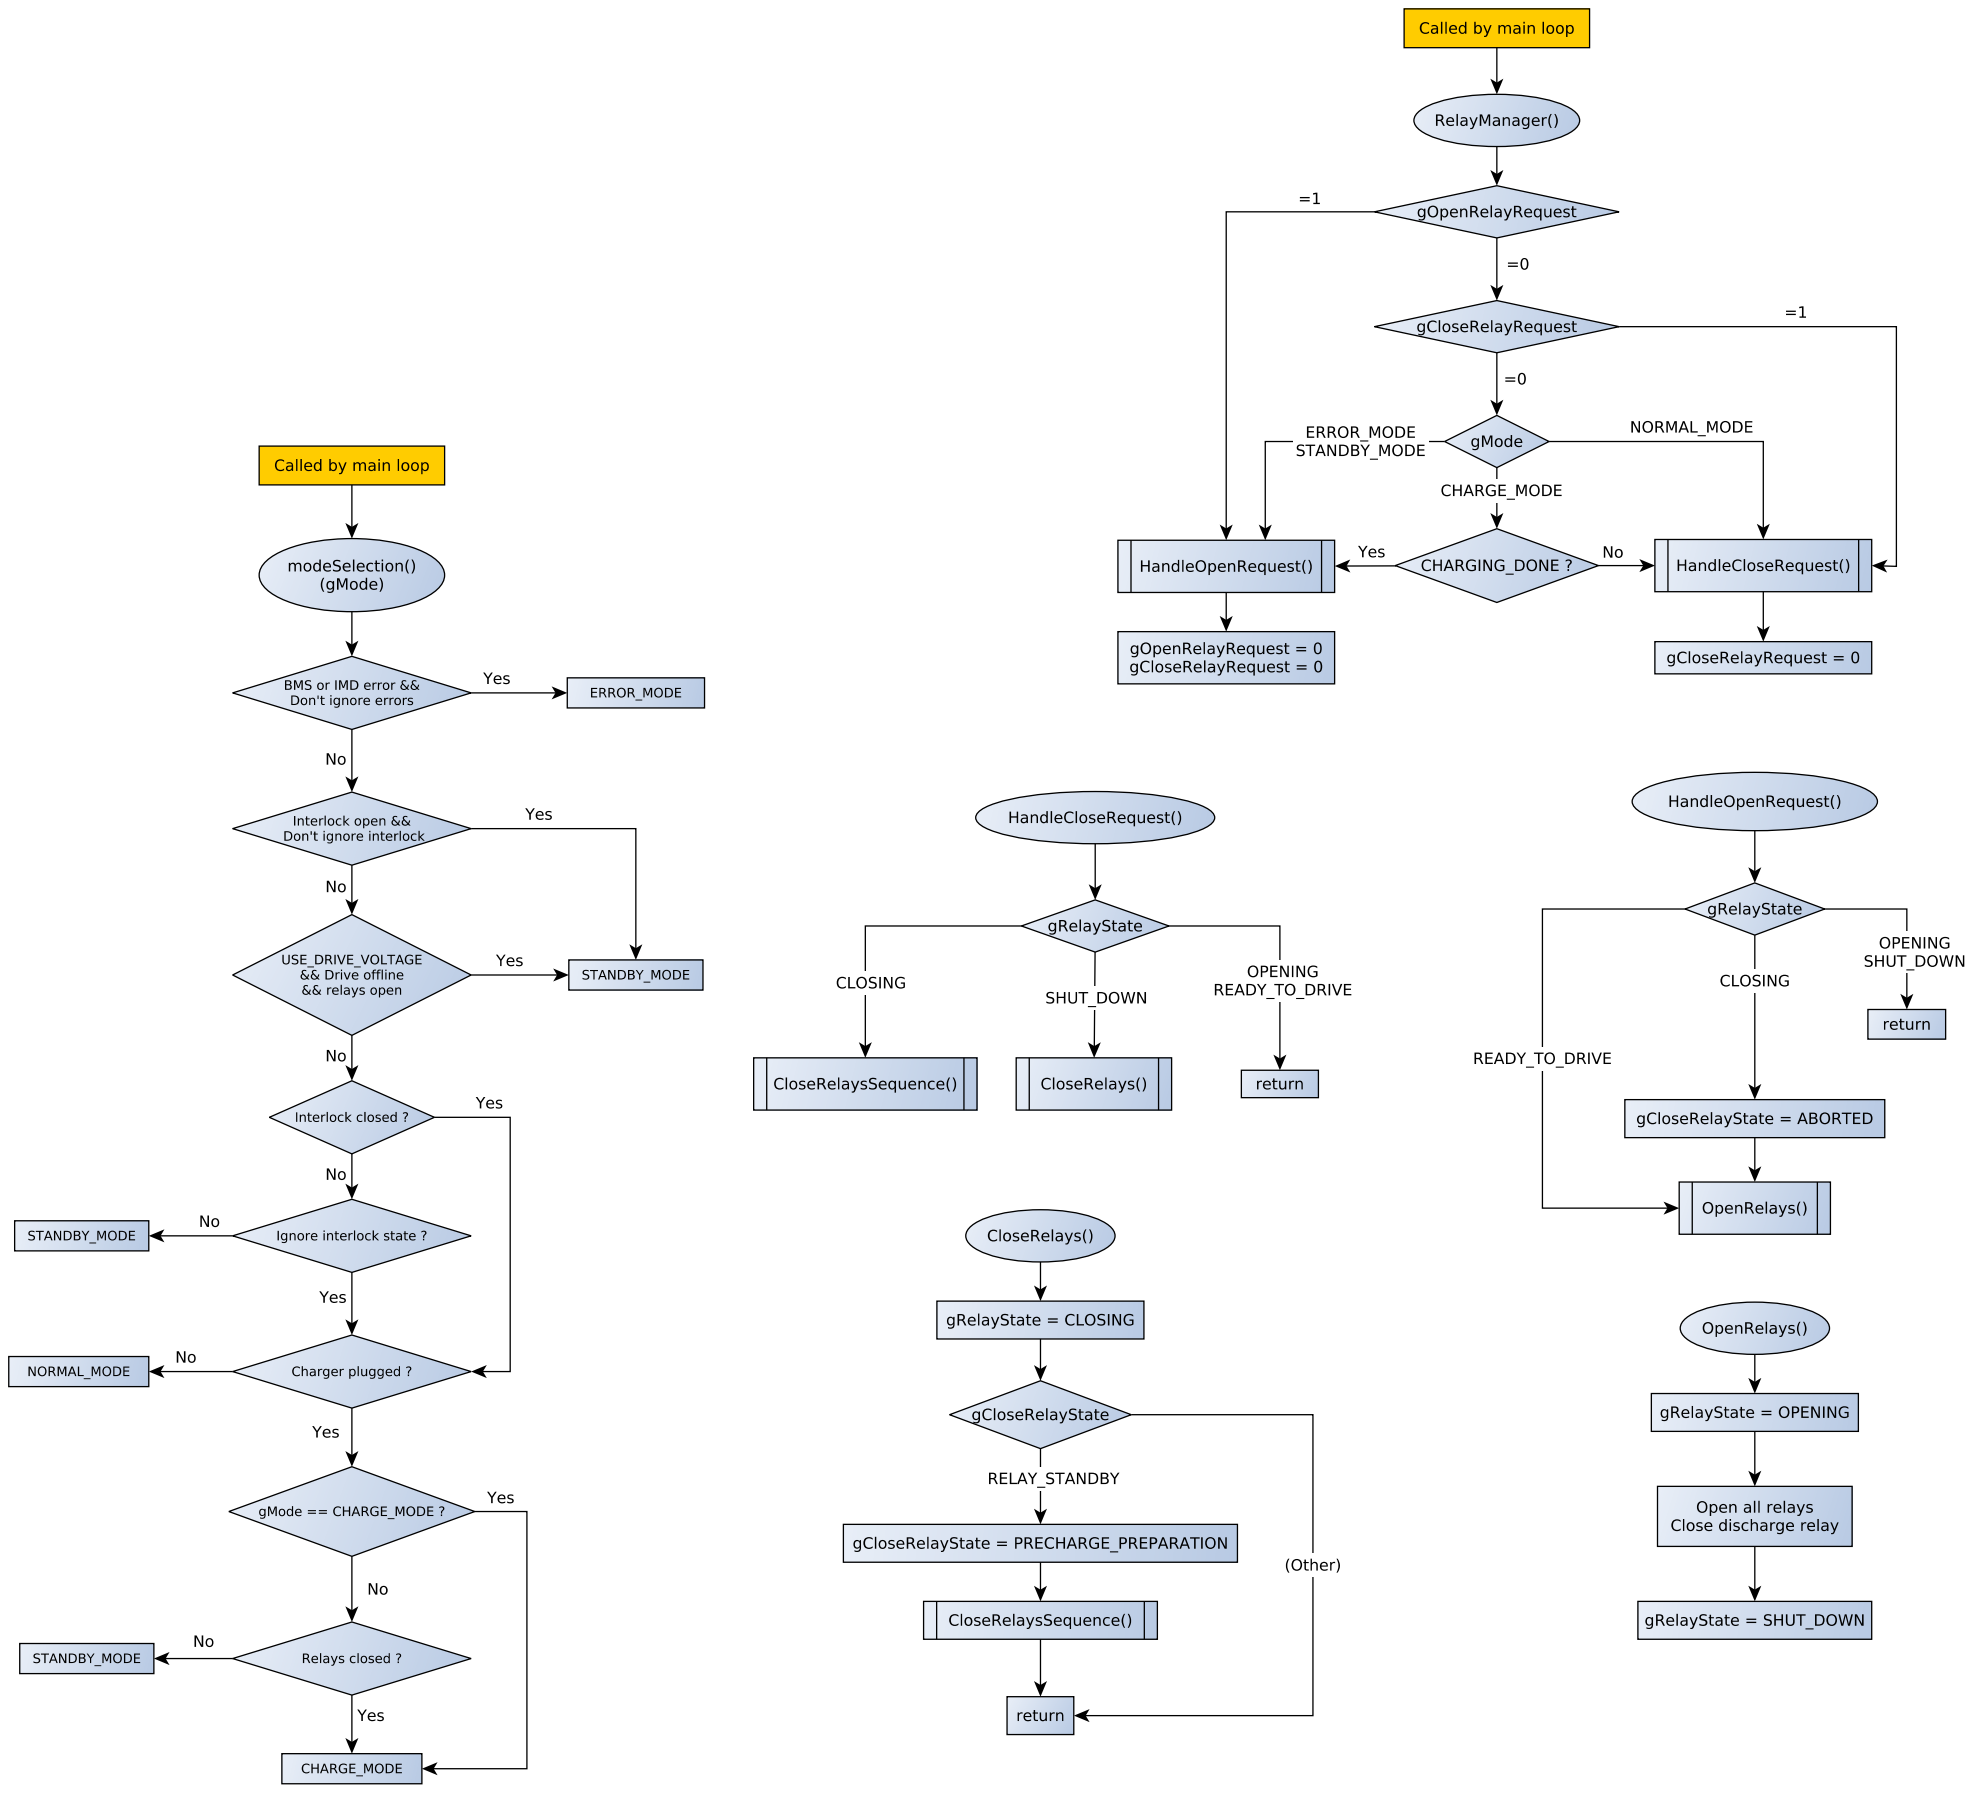
[picture p101: page 1]
