HarshJain/bmsafe/Slave_v2/EaglePCB/v2.0/BMS_Slave_v2_layout_bottom.pdf

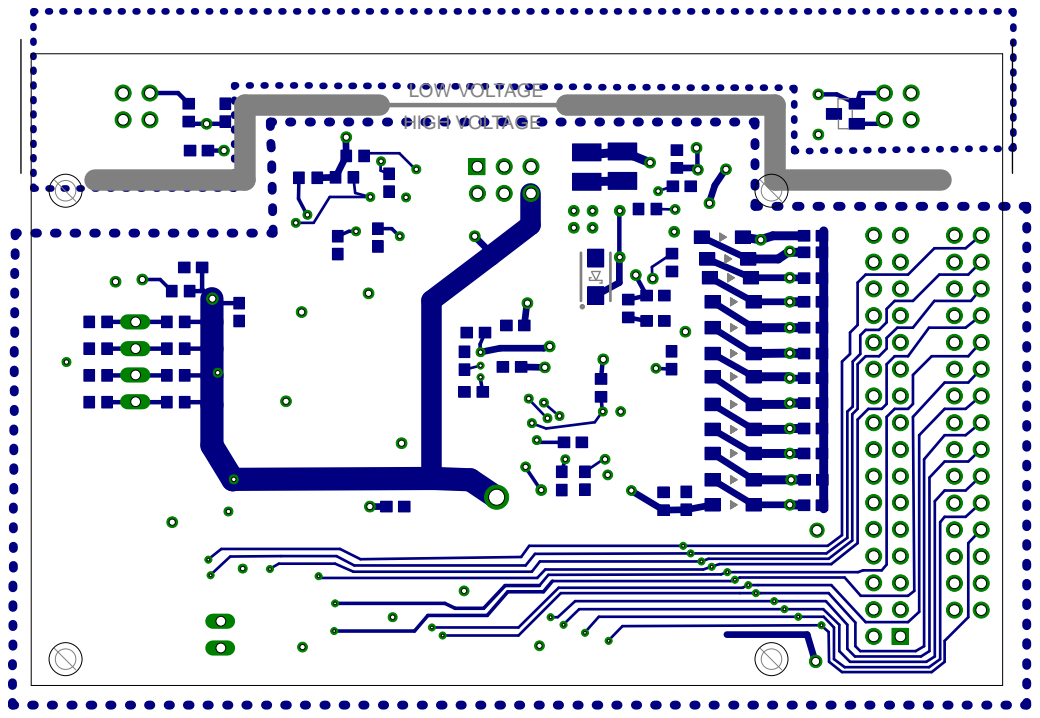
[picture p102: page 1]
HIGH VOLTAGE; LOW VOLTAGE
