HarshJain/bmsafe/Slave_v2/EaglePCB/v2.0/BMS_Slave_v2_layout_top.pdf

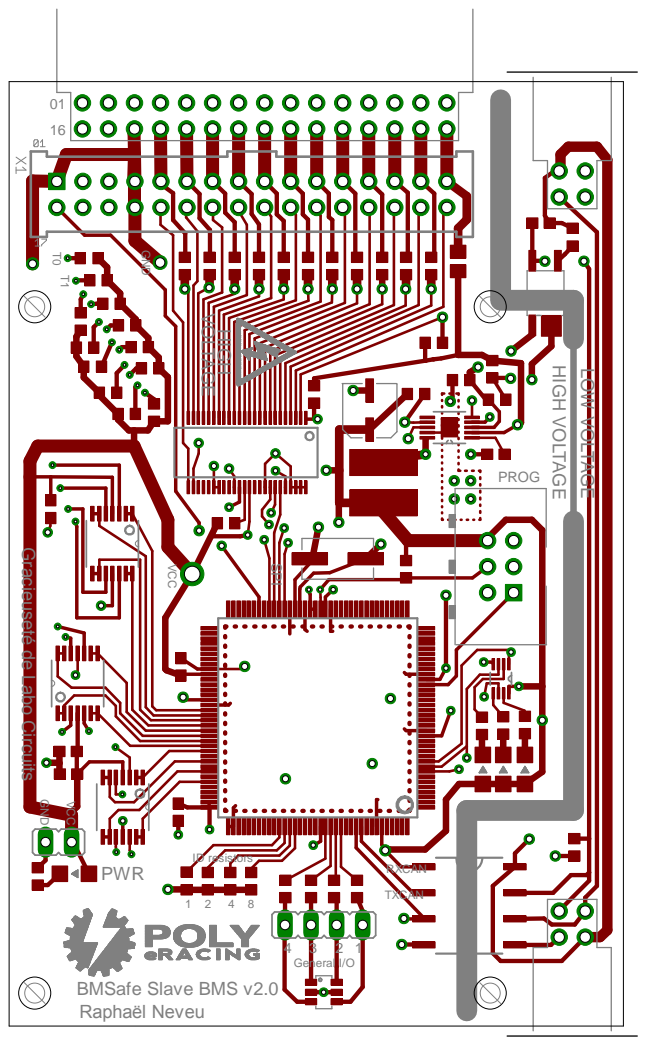
[picture p103: page 1]
ID resistors; GND; VCC; General I/O; TXCAN; RXCAN PWR; HIGH VOLTAGE; LOW VOLTAGE; PROG; SPI; HIGH; VOLTAGE

Gracieuseté de Labo Circuits

BMSafe Slave BMS v2.0
Raphaël Neveu
