HarshJain/bmsafe/Slave_v2/EaglePCB/v2.0/BMS_Slave2_schema.pdf

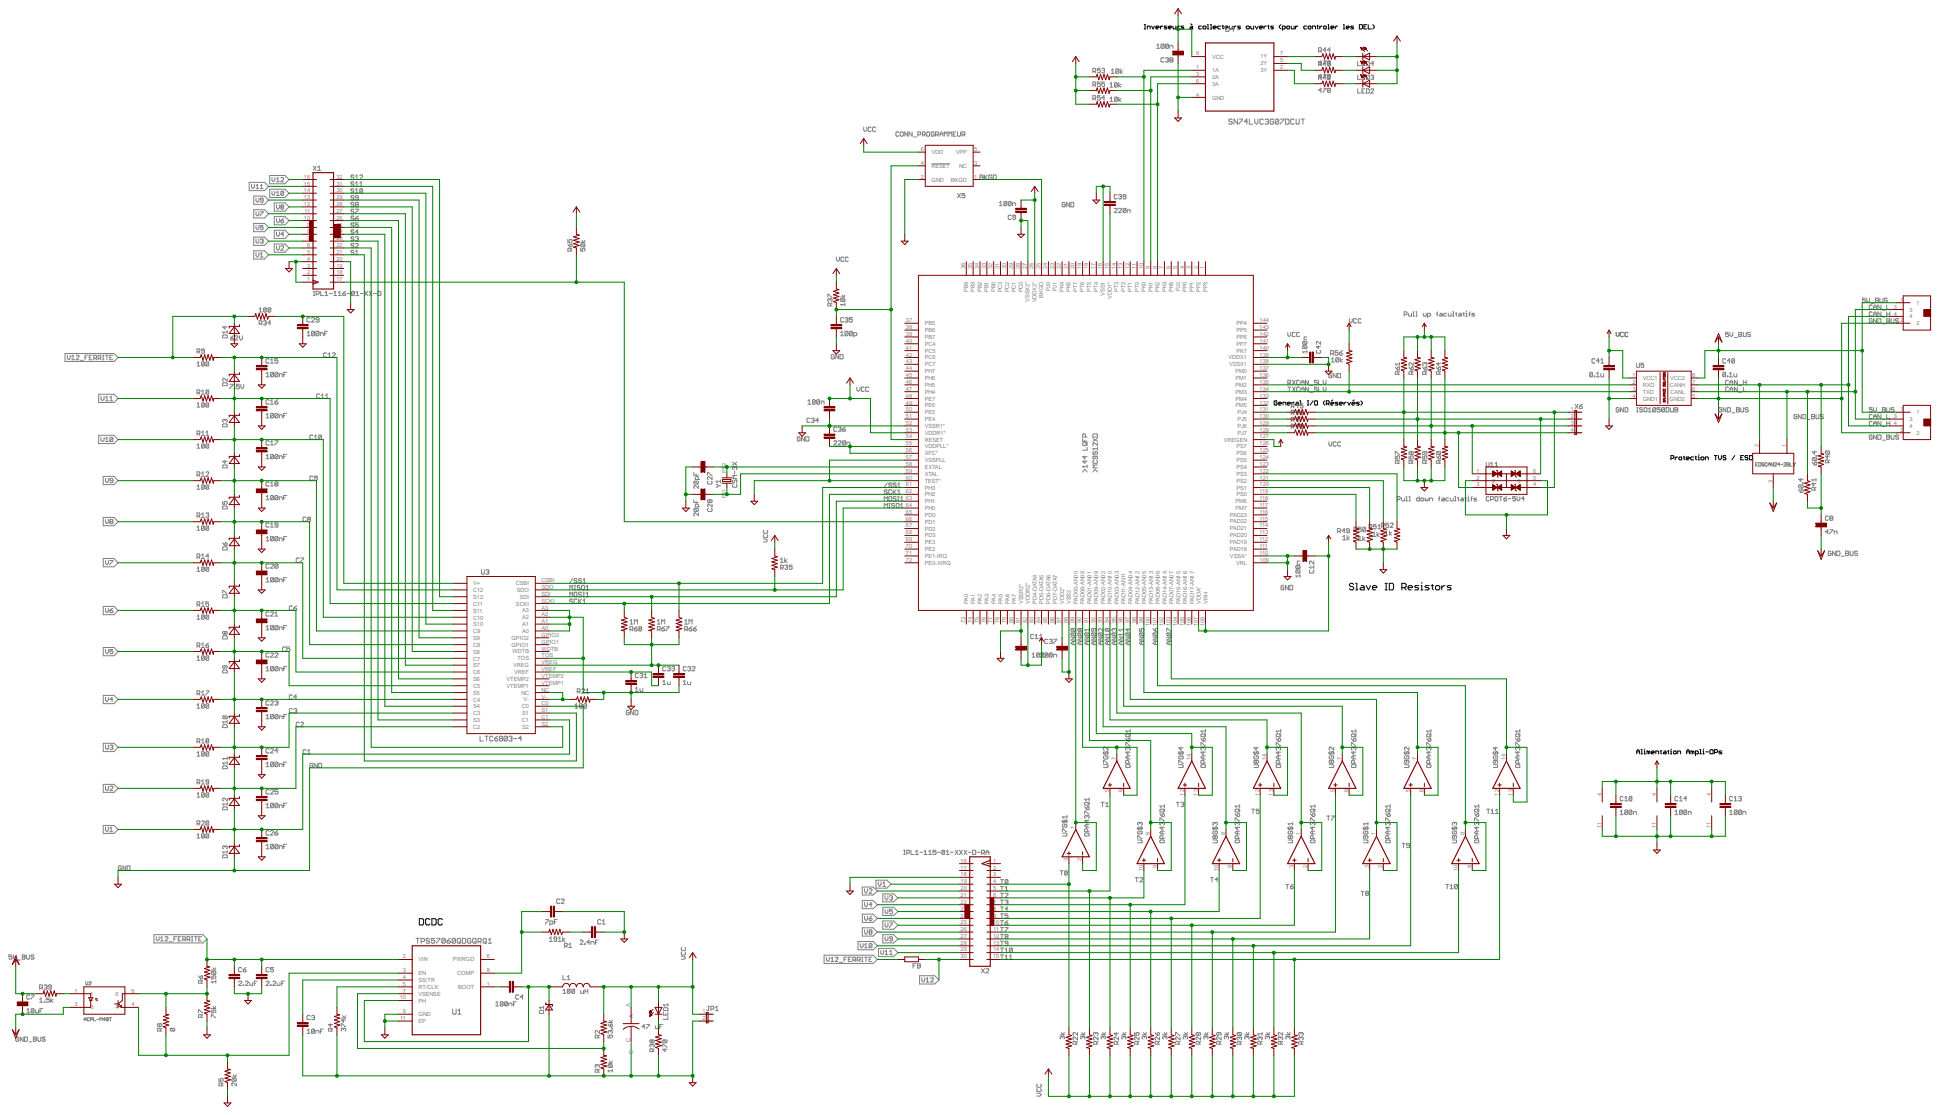
[picture p104: page 1]
