HarshJain/bmsafe/Master_v2/PCB/BMSafeMasterV2.brd

## EAGLE design Master_v2/PCB/BMSafeMasterV2.brd (2015-01-25)

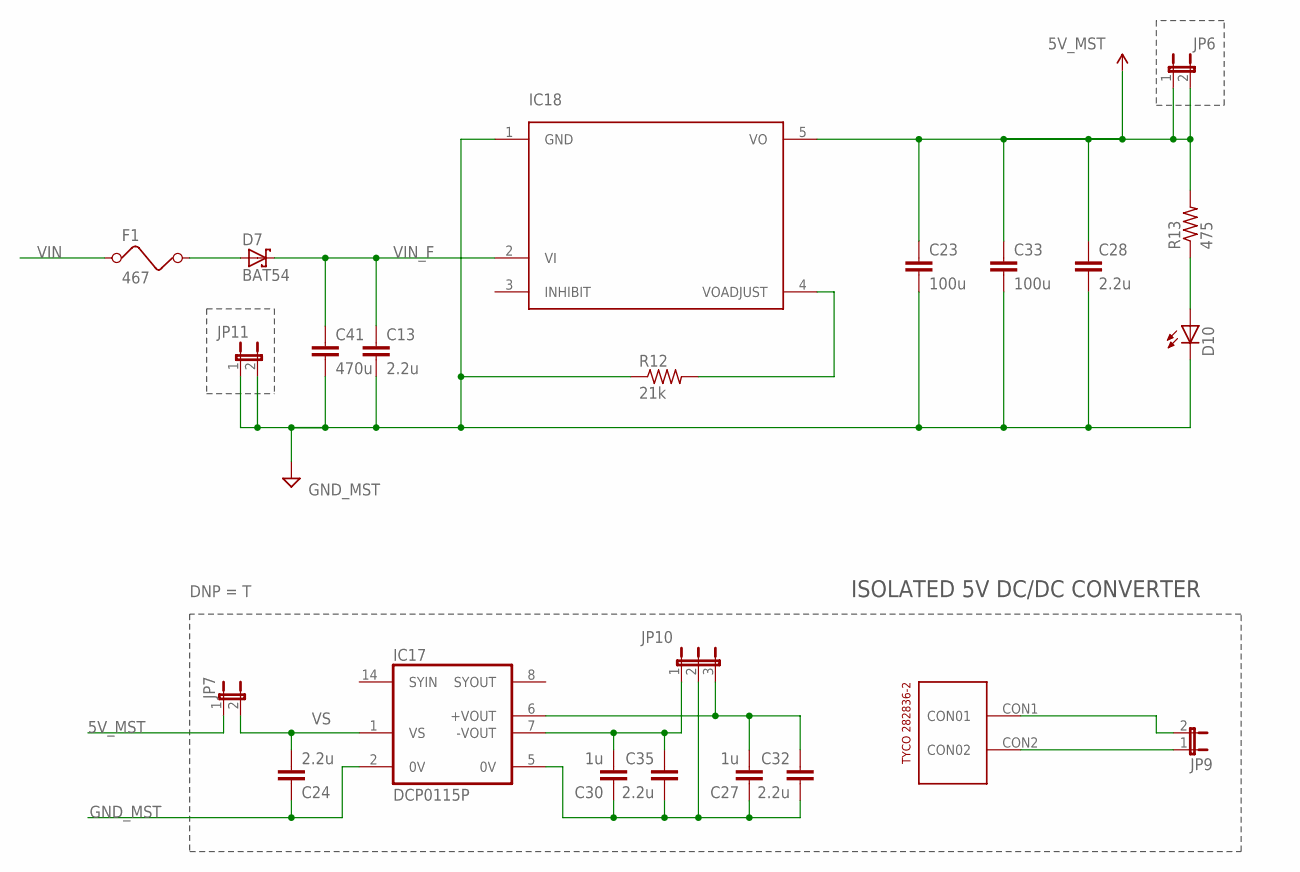
[picture p105: schematic BMSafeMasterV2.sch, sheet 1, POWER SUPPLY]

Parts:
C13, C24, C28, C32, C35: 2.2u; C1210; PARTNO C3225X7R1H225K250AB
C23, C33: 100u; EEU-FM1E101; PARTNO EEU-FM1E101
C27, C30: 1u; C050-024X044; PARTNO TAP105M035SCS
C41: 470u; EEU-FM1E101
D7: BAT54; SOT23; PARTNO BAT750TA
D10: LEDSMT1206; 1206; PARTNO LTST-C150KGKT
F1: 467; 0603; PARTNO 0467.250NR
IC17: DCP0115P; DIL14/7; PARTNO DCP010505BP-U
IC18: DCDCMAITRE_HOLES; PARTNO PTN78000WAH
JP6, JP7, JP9, JP11: JP1E; JP1; PARTNO 68001-202HLF
JP10: JP2E; JP2; PARTNO 68000-103HLF
R12: 21k; R0805; PARTNO RR1220P-2102-D-M
R13: 475; R0805; PARTNO MCR10EZHF4750
X8: 282836-2; PARTNO 282836-2

Connections:
5V_MST: C23.1, C28.1, C33.1, IC18.5 (VO), JP6.1, JP6.2, JP7.1, R13.2; also elsewhere on the board
+5V_ISO: C27.2, C32.1, IC17.6 (+VOUT), JP10.3
-5V_ISO: C30.2, C35.1, IC17.7 (-VOUT), JP10.1
GND_MST: C13.2, C23.2, C24.1, C28.2, C33.2, C41.2, D10.C, IC17.2 (0V), IC18.1 (GND), JP11.1, JP11.2, R12.1; also elsewhere on the board
HV_GND: C27.1, C30.1, C32.2, C35.2, IC17.5 (0V), JP10.2
unnamed: D10.A, R13.1
unnamed: JP9.2, X8.CON1 (CON01)
unnamed: JP9.1, X8.CON2 (CON02)
unnamed: D7.1 (A), F1.2
VIN: F1.1; also elsewhere on the board
VIN_F: C13.1, C41.1, D7.3 (C), IC18.2 (VI)
VOADJUST: IC18.4 (VOADJUST), R12.2
VS: C24.2, IC17.1 (VS), JP7.2

Notes on the sheet:
IC18
ISOLATED 5V DC/DC CONVERTER

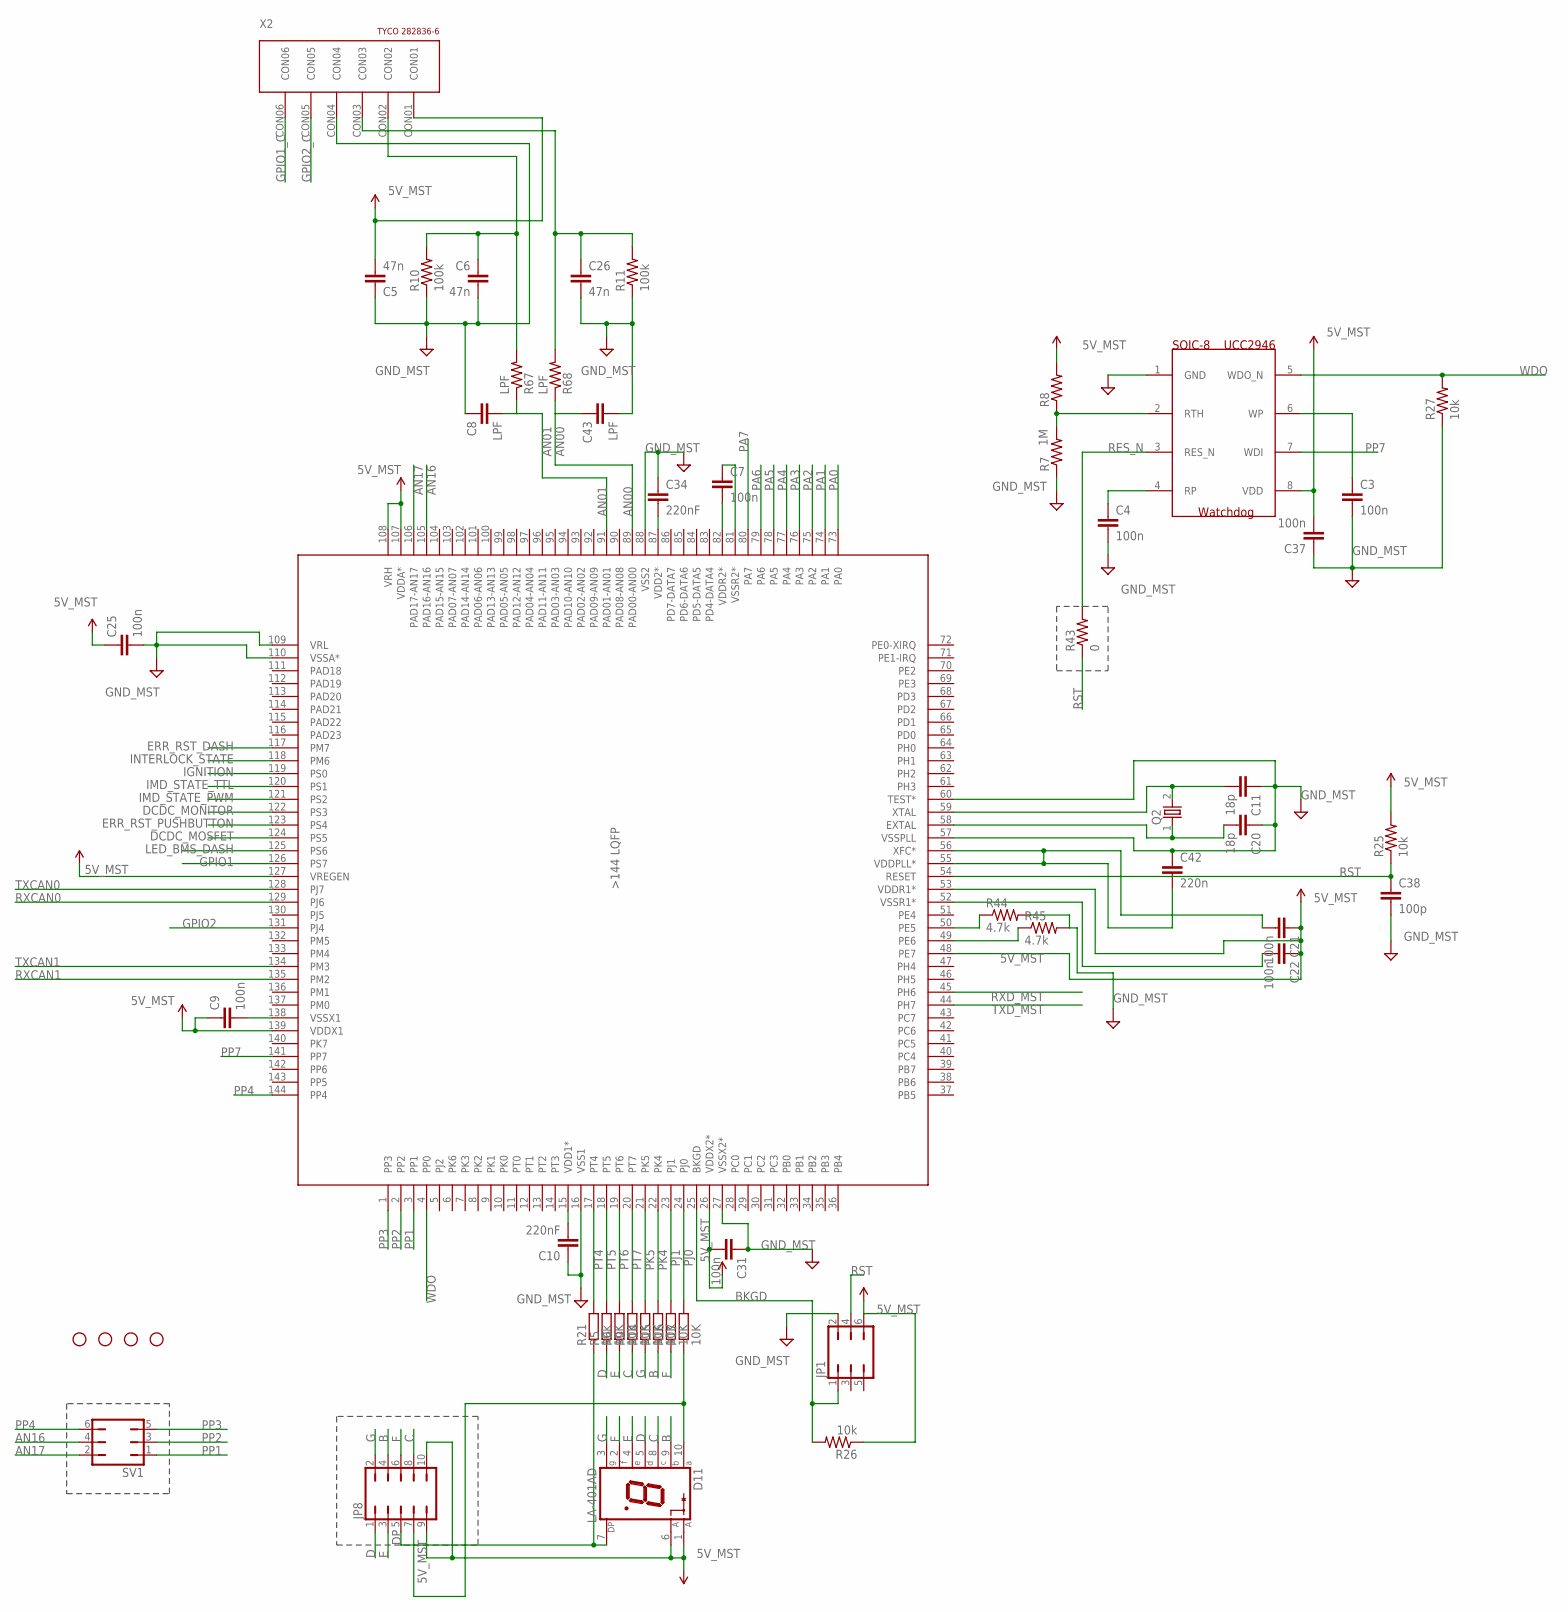
[picture p106: schematic BMSafeMasterV2.sch, sheet 2, MICROCONTROLLER]

Parts:
C3, C4, C7, C9, C21, C22, C25, C31, C37: 100n; C0805; PARTNO 08055C104KAT2A
C5, C6, C26: 47n; C0805; PARTNO 08055C473KAT2A
C8, C43: LPF; C0805
C10, C34: 220nF; C0805; PARTNO C2012X7R1H224K125AA
C11, C20: 18p; C0805; PARTNO 08055A180JAT2A
C38: 100p; C0805; PARTNO C0805C101J5GACTU
C42: 220n; C0805; PARTNO C2012X7R1H224K125AA
D11: LA-401AD; LA-401; PARTNO LA-401AD
IC1: MC9S12XF-144; SQFP-S-20X20-144; PARTNO MC9S12XDP512MAG
IC14: WATCHDOG; SOIC08; PARTNO UCC2946D
JP1: JP3Q; PARTNO 67996-206HLF
JP2, JP3, JP4, JP5: STAND-OFF
JP8: JP5Q; PARTNO 68602-110HLF
Q2: CSM-7X; PARTNO ECS-160-18-5PXEN-TR
R5, R6, R9, R14, R15, R16, R17: 10K; R0805; PARTNO RC0805JR-0710KL
R7, R8: 1M; R0805; PARTNO MCR10EZPJ105
R10, R11: 100k; R0805; PARTNO MCR10EZHJ104
R21, R25, R26, R27: 10k; R0805; PARTNO RC0805JR-0710KL
R43: 0; R0805; PARTNO RMCF0805ZT0R00
R44, R45: 4.7k; R0805; PARTNO RMCF0805JT4K70
R67, R68: LPF; R0805
SV1: JP3Q; PARTNO 67996-206HLF
X2: 282836-6; PARTNO 282836-6

Connections:
5V_MST: C5.2, C7.2, C9.1, C21.1, C22.1, C25.1, C31.2, C37.2, D11.1 (A), D11.6 (A), IC1.26 (VDDX2*), IC1.48 (PE7), IC1.53 (VDDR1*), IC1.82 (VDDR2*), IC1.107 (VDDA*), IC1.108 (VRH), IC1.127 (VREGEN), IC1.139 (VDDX1), IC14.8 (VDD), JP1.6, JP8.9, JP8.10, R8.2, R25.2, R26.1, X2.CON01; also elsewhere on the board
AN00: C43.1, IC1.89 (PAD00-AN00), R68.1
AN00_C: C26.1, R11.2, R68.2, X2.CON03
AN01: C8.2, IC1.91 (PAD01-AN01), R67.1
AN01_C: C6.1, R10.2, R67.2, X2.CON02
AN16: IC1.105 (PAD16-AN16), SV1.4
AN17: IC1.106 (PAD17-AN17), SV1.2
B: D11.9 (B), JP8.4, R15.1
BKGD: IC1.25 (BKGD), JP1.1, R26.2
C: D11.8 (C), JP8.8, R9.1
D: D11.5 (D), JP8.1, R5.1
DCDC_MONITOR: IC1.122 (PS3); also elsewhere on the board
DCDC_MOSFET: IC1.124 (PS5); also elsewhere on the board
DP: D11.7 (DP), JP8.5, R21.1
E: D11.4 (E), JP8.3, R6.1
ERR_RST_DASH: IC1.117 (PM7); also elsewhere on the board
ERR_RST_PUSHBUTTON: IC1.123 (PS4); also elsewhere on the board
EXTAL: C20.2, IC1.58 (EXTAL), Q2.1
F: D11.2 (F), JP8.6, R16.1
G: D11.3 (G), JP8.2, R14.1
GND_MST: C3.2, C4.2, C5.1, C6.2, C7.1, C8.1, C9.2, C10.1, C11.1, C20.1, C22.2, C25.2, C26.2, C31.1, C34.1, C37.1, C38.2, C42.1, C43.2, IC1.16 (VSS1), IC1.27 (VSSX2*), IC1.52 (VSSR1*), IC1.57 (VSSPLL), IC1.60 (TEST*), IC1.81 (VSSR2*), IC1.88 (VSS2), IC1.109 (VRL), IC1.110 (VSSA*), IC1.138 (VSSX1), IC14.1 (GND), JP1.2, R7.1, R10.1, R11.1, R27.1, R44.2, R45.2, X2.CON04; also elsewhere on the board
GPIO1: IC1.126 (PS7); also elsewhere on the board
GPIO1_C: X2.CON06; also elsewhere on the board
GPIO2: IC1.131 (PJ4); also elsewhere on the board
GPIO2_C: X2.CON05; also elsewhere on the board
IGNITION: IC1.119 (PS0); also elsewhere on the board
IMD_STATE_PWM: IC1.121 (PS2); also elsewhere on the board
IMD_STATE_TTL: IC1.120 (PS1); also elsewhere on the board
INTERLOCK_STATE: IC1.118 (PM6); also elsewhere on the board
LED_BMS_DASH: IC1.125 (PS6); also elsewhere on the board
unnamed: IC14.2 (RTH), R7.2, R8.1
unnamed: D11.10 (A), JP8.7, R17.1
unnamed: C4.1, IC14.4 (RP)
unnamed: C3.1, IC14.6 (WP)
unnamed: IC1.50 (PE5), R44.1
unnamed: IC1.49 (PE6), R45.1
PA0: IC1.73 (PA0); also elsewhere on the board
PA1: IC1.74 (PA1); also elsewhere on the board
PA2: IC1.75 (PA2); also elsewhere on the board
PA3: IC1.76 (PA3); also elsewhere on the board
PA4: IC1.77 (PA4); also elsewhere on the board
PA5: IC1.78 (PA5); also elsewhere on the board
PA6: IC1.79 (PA6)
PA7: IC1.80 (PA7)
PJ0: IC1.24 (PJ0), R17.2
PJ1: IC1.23 (PJ1), R16.2
PK4: IC1.22 (PK4), R15.2
PK5: IC1.21 (PK5), R14.2
PP1: IC1.3 (PP1), SV1.1
PP2: IC1.2 (PP2), SV1.3
PP3: IC1.1 (PP3), SV1.5
PP4: IC1.144 (PP4), SV1.6
PP7: IC1.141 (PP7), IC14.7 (WDI)
PT4: IC1.17 (PT4), R21.2
PT5: IC1.18 (PT5), R5.2
PT6: IC1.19 (PT6), R6.2
PT7: IC1.20 (PT7), R9.2
RES_N: IC14.3 (RES_N), R43.2
RST: C38.1, IC1.54 (RESET), JP1.4, R25.1, R43.1
RXCAN0: IC1.129 (PJ6); also elsewhere on the board
RXCAN1: IC1.135 (PM2); also elsewhere on the board
RXD_MST: IC1.45 (PH6); also elsewhere on the board
TXCAN0: IC1.128 (PJ7); also elsewhere on the board
TXCAN1: IC1.134 (PM3); also elsewhere on the board
TXD_MST: IC1.44 (PH7); also elsewhere on the board
VDD: C34.2, IC1.87 (VDD2*)
VDD1: C10.2, IC1.15 (VDD1*)
VDDPLL: C21.2, C42.2, IC1.55 (VDDPLL*), IC1.56 (XFC*)
WDO: IC1.4 (PP0), IC14.5 (WDO_N), R27.2; also elsewhere on the board
XTAL: C11.2, IC1.59 (XTAL), Q2.2

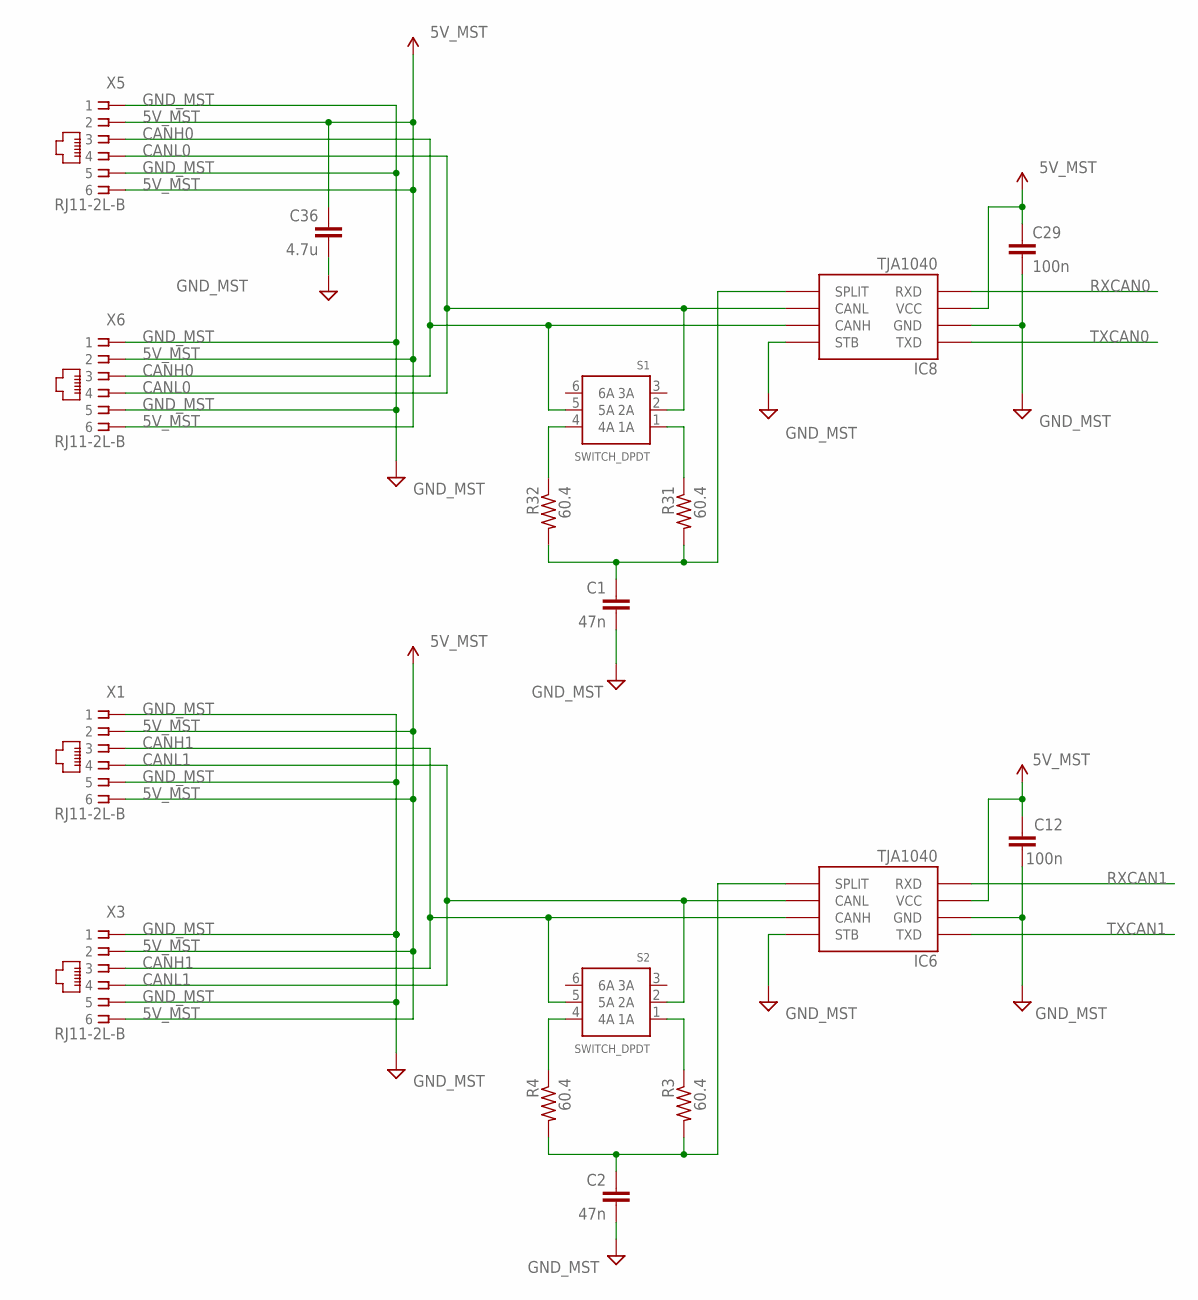
[picture p107: schematic BMSafeMasterV2.sch, sheet 3, CAN]

Parts:
C1, C2: 47n; C0805; PARTNO 08055C473KAT2A
C12, C29: 100n; C0805; PARTNO 08055C104KAT2A
C36: 4.7u; C1206; PARTNO C3216X5R1A475K
IC6, IC8: TJA1040; SO8; PARTNO TJA1040
R3, R4, R31, R32: 60.4; R1206; PARTNO MCR18EZPF60R4
S1, S2: SWITCH_DPDT; DPDT; PARTNO JS202011SCQN
X1, X3, X5, X6: RJ11-2L-B; RJ11-NO_SHIELD; PARTNO 5555165-1

Connections:
5V_MST: C12.1, C29.1, C36.1, IC6.3 (VCC), IC8.3 (VCC), X1.2, X1.6, X3.2, X3.6, X5.2, X5.6, X6.2, X6.6; also elsewhere on the board
CANH0: IC8.7 (CANH), S1.5 (5A), X5.3, X6.3
CANH1: IC6.7 (CANH), S2.5 (5A), X1.3, X3.3
CANL0: IC8.6 (CANL), S1.2 (2A), X5.4, X6.4
CANL1: IC6.6 (CANL), S2.2 (2A), X1.4, X3.4
GND_MST: C1.2, C2.2, C12.2, C29.2, C36.2, IC6.2 (GND), IC6.8 (STB), IC8.2 (GND), IC8.8 (STB), X1.1, X1.5, X3.1, X3.5, X5.1, X5.5, X6.1, X6.5; also elsewhere on the board
unnamed: C2.1, IC6.5 (SPLIT), R3.2, R4.2
unnamed: R3.1, S2.1 (1A)
unnamed: R4.1, S2.4 (4A)
unnamed: C1.1, IC8.5 (SPLIT), R31.2, R32.2
unnamed: R31.1, S1.1 (1A)
unnamed: R32.1, S1.4 (4A)
RXCAN0: IC8.4 (RXD); also elsewhere on the board
RXCAN1: IC6.4 (RXD); also elsewhere on the board
TXCAN0: IC8.1 (TXD); also elsewhere on the board
TXCAN1: IC6.1 (TXD); also elsewhere on the board

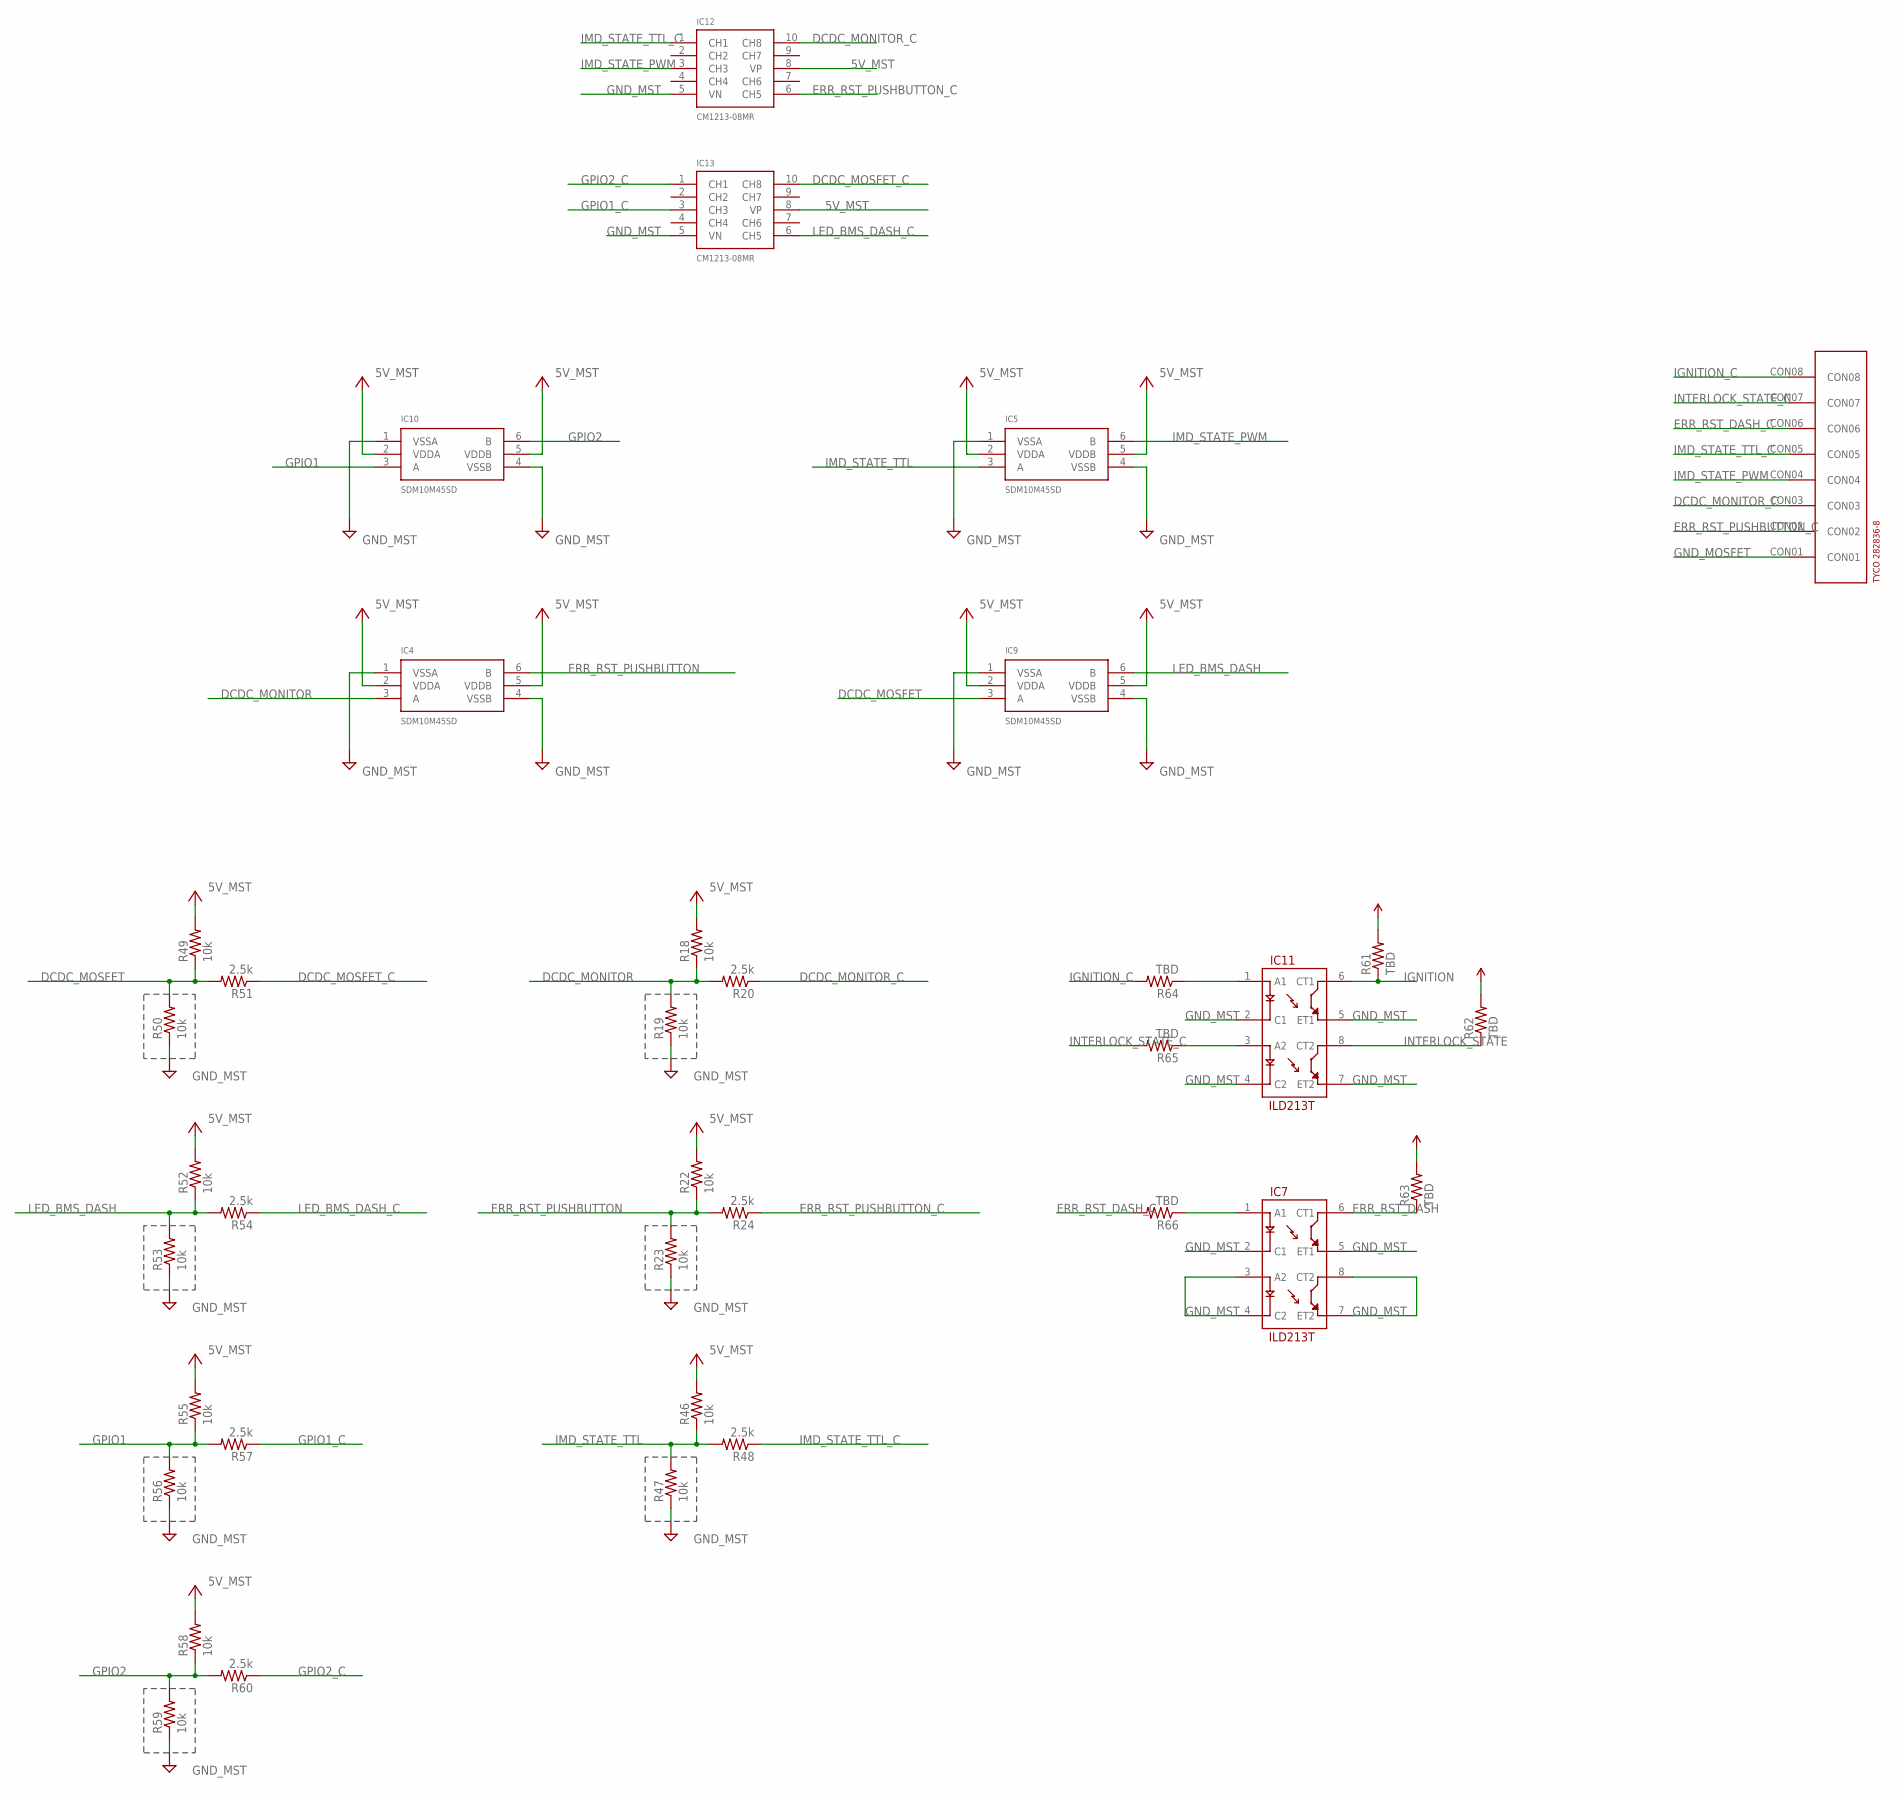
[picture p108: schematic BMSafeMasterV2.sch, sheet 4, I/O]

Parts:
IC4, IC5, IC9, IC10: SDM10M45SD; SOT-26; PARTNO SDM10M45SD-7-F
IC7, IC11: ILD213T; SO08; PARTNO ILD213T
IC12, IC13: CM1213-08MR; MSOP10; PARTNO CM1213-08MR
R18, R19, R22, R23, R46, R47, R49, R50, R52, R53, R55, R56, R58, R59: 10k; R0805; PARTNO RC0805JR-0710KL
R20, R24, R48, R51, R54, R57, R60: 2.5k; R0805; PARTNO RC0805FR-072K43L
R61, R62, R63, R64, R65, R66: TBD; R0805
X9: 282836-8; PARTNO 282836-8

Connections:
5V_MST: IC4.2 (VDDA), IC4.5 (VDDB), IC5.2 (VDDA), IC5.5 (VDDB), IC9.2 (VDDA), IC9.5 (VDDB), IC10.2 (VDDA), IC10.5 (VDDB), IC12.8 (VP), IC13.8 (VP), R18.2, R22.2, R46.2, R49.2, R52.2, R55.2, R58.2, R61.2, R62.2, R63.2; also elsewhere on the board
DCDC_MONITOR: IC4.3 (A), R18.1, R19.2, R20.2; also elsewhere on the board
DCDC_MONITOR_C: IC12.10 (CH8), R20.1, X9.CON03
DCDC_MOSFET: IC9.3 (A), R49.1, R50.2, R51.2; also elsewhere on the board
DCDC_MOSFET_C: IC13.10 (CH8), R51.1; also elsewhere on the board
ERR_RST_DASH: IC7.6 (CT1), R63.1; also elsewhere on the board
ERR_RST_DASH_C: R66.2, X9.CON06
ERR_RST_PUSHBUTTON: IC4.6 (B), R22.1, R23.2, R24.2; also elsewhere on the board
ERR_RST_PUSHBUTTON_C: IC12.6 (CH5), R24.1, X9.CON02
GND_MOSFET: X9.CON01; also elsewhere on the board
GND_MST: IC4.1 (VSSA), IC4.4 (VSSB), IC5.1 (VSSA), IC5.4 (VSSB), IC7.2 (C1), IC7.3 (A2), IC7.4 (C2), IC7.5 (ET1), IC7.7 (ET2), IC7.8 (CT2), IC9.1 (VSSA), IC9.4 (VSSB), IC10.1 (VSSA), IC10.4 (VSSB), IC11.2 (C1), IC11.4 (C2), IC11.5 (ET1), IC11.7 (ET2), IC12.5 (VN), IC13.5 (VN), R19.1, R23.1, R47.1, R50.1, R53.1, R56.1, R59.1; also elsewhere on the board
GPIO1: IC10.3 (A), R55.1, R56.2, R57.2; also elsewhere on the board
GPIO1_C: IC13.3 (CH3), R57.1; also elsewhere on the board
GPIO2: IC10.6 (B), R58.1, R59.2, R60.2; also elsewhere on the board
GPIO2_C: IC13.1 (CH1), R60.1; also elsewhere on the board
IGNITION: IC11.6 (CT1), R61.1; also elsewhere on the board
IGNITION_C: R64.2, X9.CON08
IMD_STATE_PWM: IC5.6 (B), IC12.3 (CH3), X9.CON04; also elsewhere on the board
IMD_STATE_TTL: IC5.3 (A), R46.1, R47.2, R48.2; also elsewhere on the board
IMD_STATE_TTL_C: IC12.1 (CH1), R48.1, X9.CON05
INTERLOCK_STATE: IC11.8 (CT2), R62.1; also elsewhere on the board
INTERLOCK_STATE_C: R65.2, X9.CON07
LED_BMS_DASH: IC9.6 (B), R52.1, R53.2, R54.2; also elsewhere on the board
LED_BMS_DASH_C: IC13.6 (CH5), R54.1; also elsewhere on the board
unnamed: IC11.1 (A1), R64.1
unnamed: IC11.3 (A2), R65.1
unnamed: IC7.1 (A1), R66.1

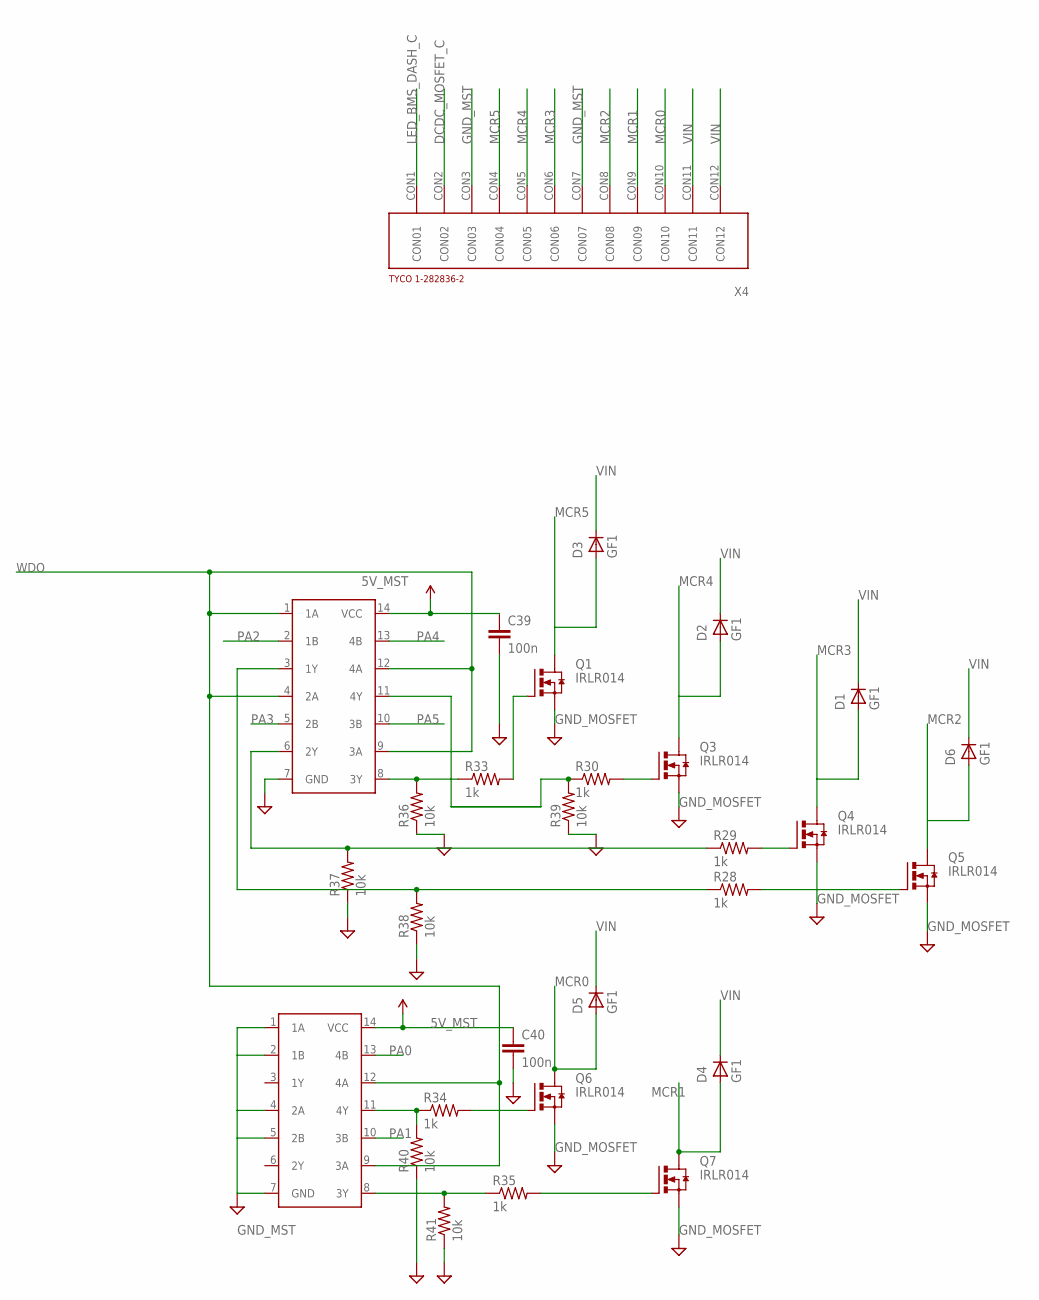
[picture p109: schematic BMSafeMasterV2.sch, sheet 5, RELAYS CONTROL]

Parts:
C39, C40: 100n; C0805; PARTNO 08055C104KAT2A
D1, D2, D3, D4, D5, D6: GF1; SMA-DO214AC
IC15, IC16: SN74HC08; TSSOP14; PARTNO SN74HC08QPWRQ1
Q1, Q3, Q4, Q5, Q6, Q7: IRLR014; TO-252; PARTNO IRLR014TRPBF
R28, R29, R30, R33, R34, R35: 1k; R0805; PARTNO RC0805JR-071KL
R36, R37, R38, R39, R40, R41: 10k; R0805; PARTNO RC0805JR-0710KL
X4: 1-282836-2; PARTNO 1-282836-2

Connections:
5V_MST: C39.1, C40.1, IC15.14 (VCC), IC16.14 (VCC); also elsewhere on the board
DCDC_MOSFET_C: X4.CON2 (CON02); also elsewhere on the board
GM2: IC15.3 (1Y), R28.1, R38.2
GM3: IC15.6 (2Y), R29.1, R37.2
GND_MOSFET: Q1.P$3 (S), Q3.P$3 (S), Q4.P$3 (S), Q5.P$3 (S), Q6.P$3 (S), Q7.P$3 (S); also elsewhere on the board
GND_MST: C39.2, C40.2, IC15.7 (GND), IC16.1 (1A), IC16.2 (1B), IC16.4 (2A), IC16.5 (2B), IC16.7 (GND), R36.1, R37.1, R38.1, R39.1, R40.1, R41.1, X4.CON3 (CON03), X4.CON7 (CON07); also elsewhere on the board
LED_BMS_DASH_C: X4.CON1 (CON01); also elsewhere on the board
MCR0: D5.A, Q6.P$4 (D), X4.CON10
MCR1: D4.A, Q7.P$4 (D), X4.CON9 (CON09)
MCR2: D6.A, Q5.P$4 (D), X4.CON8 (CON08)
MCR3: D1.A, Q4.P$4 (D), X4.CON6 (CON06)
MCR4: D2.A, Q3.P$4 (D), X4.CON5 (CON05)
MCR5: D3.A, Q1.P$4 (D), X4.CON4 (CON04)
unnamed: IC16.11 (4Y), R34.1, R40.2
unnamed: Q6.P$1 (G), R34.2
unnamed: IC16.8 (3Y), R35.1, R41.2
unnamed: Q7.P$1 (G), R35.2
unnamed: Q1.P$1 (G), R33.2
unnamed: IC15.8 (3Y), R33.1, R36.2
unnamed: IC15.11 (4Y), R30.1, R39.2
unnamed: Q3.P$1 (G), R30.2
unnamed: Q4.P$1 (G), R29.2
unnamed: Q5.P$1 (G), R28.2
PA0: IC16.13 (4B); also elsewhere on the board
PA1: IC16.10 (3B); also elsewhere on the board
PA2: IC15.2 (1B); also elsewhere on the board
PA3: IC15.5 (2B); also elsewhere on the board
PA4: IC15.13 (4B); also elsewhere on the board
PA5: IC15.10 (3B); also elsewhere on the board
VIN: D1.K (C), D2.K (C), D3.K (C), D4.K (C), D5.K (C), D6.K (C), X4.CON11, X4.CON12; also elsewhere on the board
WDO: IC15.1 (1A), IC15.4 (2A), IC15.9 (3A), IC15.12 (4A), IC16.9 (3A), IC16.12 (4A); also elsewhere on the board

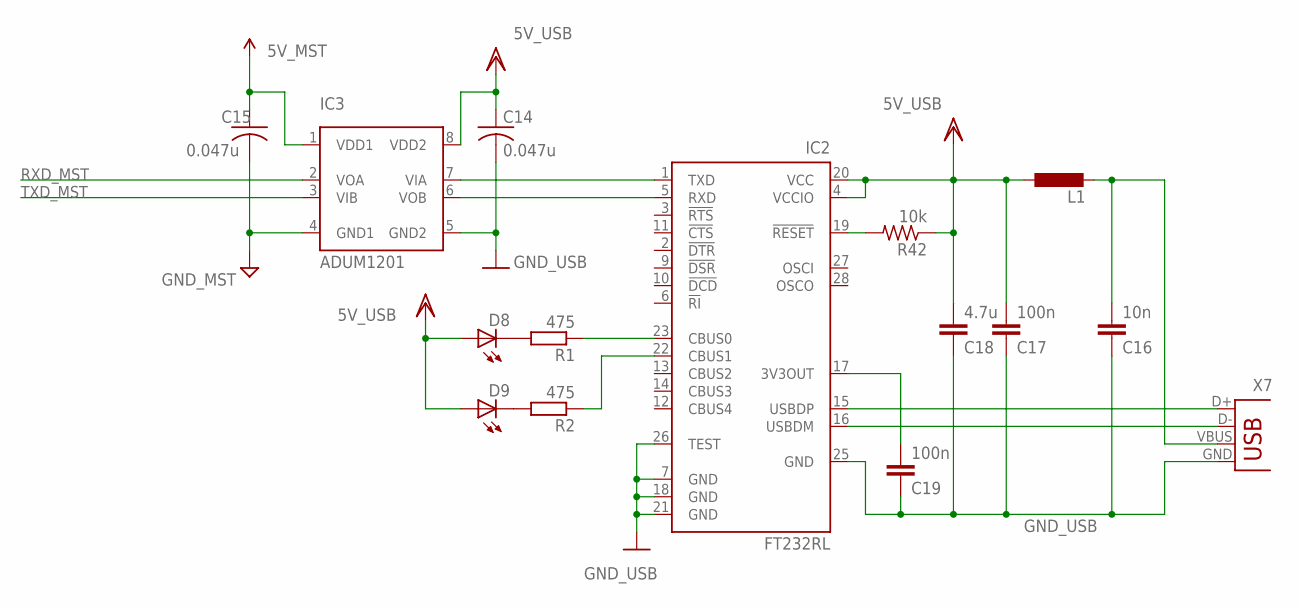
[picture p110: schematic BMSafeMasterV2.sch, sheet 6, USB INTERFACE]

Parts:
C14, C15: 0.047u; C0805; PARTNO 08055C473KAT2A
C16: 10n; C0805; PARTNO 08055C103KAT2A
C17, C19: 100n; C0805; PARTNO 08055C104KAT2A
C18: 4.7u; C1206; PARTNO C3216X5R1A475K
D8, D9: LEDSMT1206; 1206; PARTNO LTST-C150KSKT
IC2: FT232RL; SSOP28; PARTNO FT232RL
IC3: ADUM1201; SOIC; PARTNO ADUM1201WTRZ
L1: MYDEVICE; C0805; PARTNO MI0805K400R-10
R1, R2: 475; R0805; PARTNO MCR10EZHF4750
R42: 10k; R0805; PARTNO RC0805JR-0710KL
X7: USBPTH; USB-B-PTH; PARTNO 292304-1

Connections:
5V_MST: C15.1, IC3.1 (VDD1); also elsewhere on the board
5V_USB: C14.1, C17.2, C18.2, D8.A, D9.A, IC2.4 (VCCIO), IC2.20 (VCC), IC3.8 (VDD2), L1.1, R42.1
GND_MST: C15.2, IC3.4 (GND1); also elsewhere on the board
GND_USB: C14.2, C16.1, C17.1, C18.1, C19.1, IC2.7 (GND), IC2.18 (GND), IC2.21 (GND), IC2.25 (GND), IC2.26 (TEST), IC3.5 (GND2), X7.GND
unnamed: IC2.15 (USBDP), X7.D+
unnamed: IC2.16 (USBDM), X7.D-
unnamed: IC2.23 (CBUS0), R1.1
unnamed: D8.C, R1.2
unnamed: IC2.22 (CBUS1), R2.1
unnamed: D9.C, R2.2
unnamed: C19.2, IC2.17 (3V3OUT)
unnamed: IC2.19 (!RESET), R42.2
RXD_MST: IC3.2 (VOA); also elsewhere on the board
RXD_USB: IC2.5 (RXD), IC3.6 (VOB)
TXD_MST: IC3.3 (VIB); also elsewhere on the board
TXD_USB: IC2.1 (TXD), IC3.7 (VIA)
VUSB: C16.2, L1.2, X7.VBUS

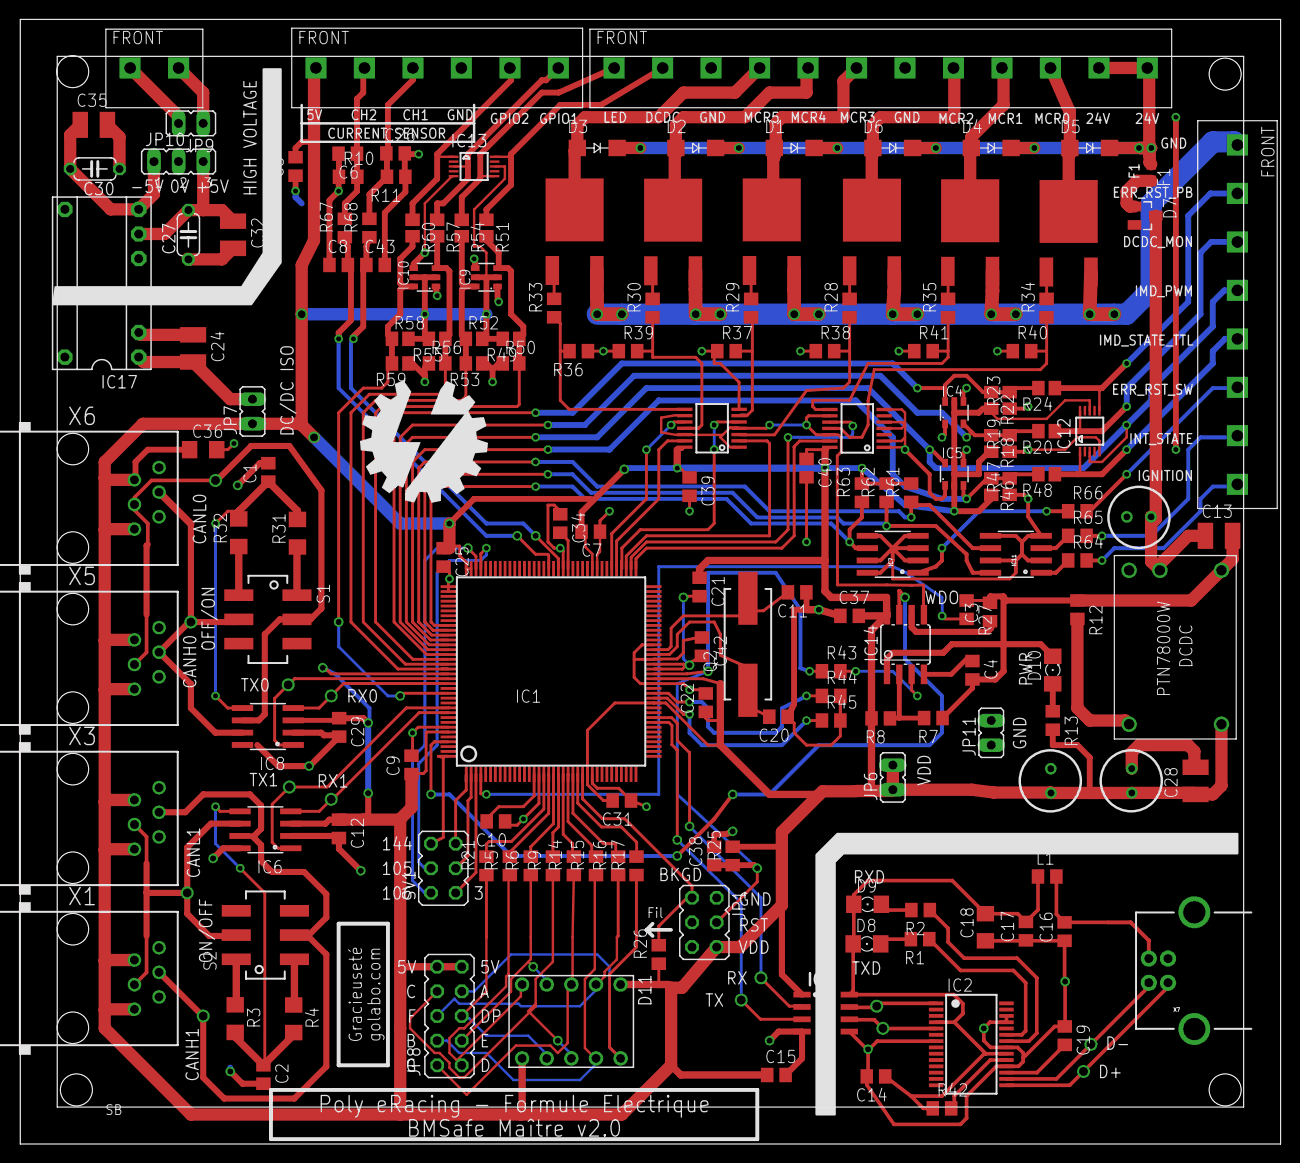
[picture p111: board BMSafeMasterV2.brd from above]

Board: 2 copper layers, 130.0 x 116.0 mm, 172 parts (0 on the bottom side), 132 nets.
