HarshJain/bmsafe/Slave_v2/EaglePCB/v2.1/BMS_Slave_v2.1.brd

## EAGLE design Slave_v2/EaglePCB/v2.1/BMS_Slave_v2.1.brd (2015-01-25)

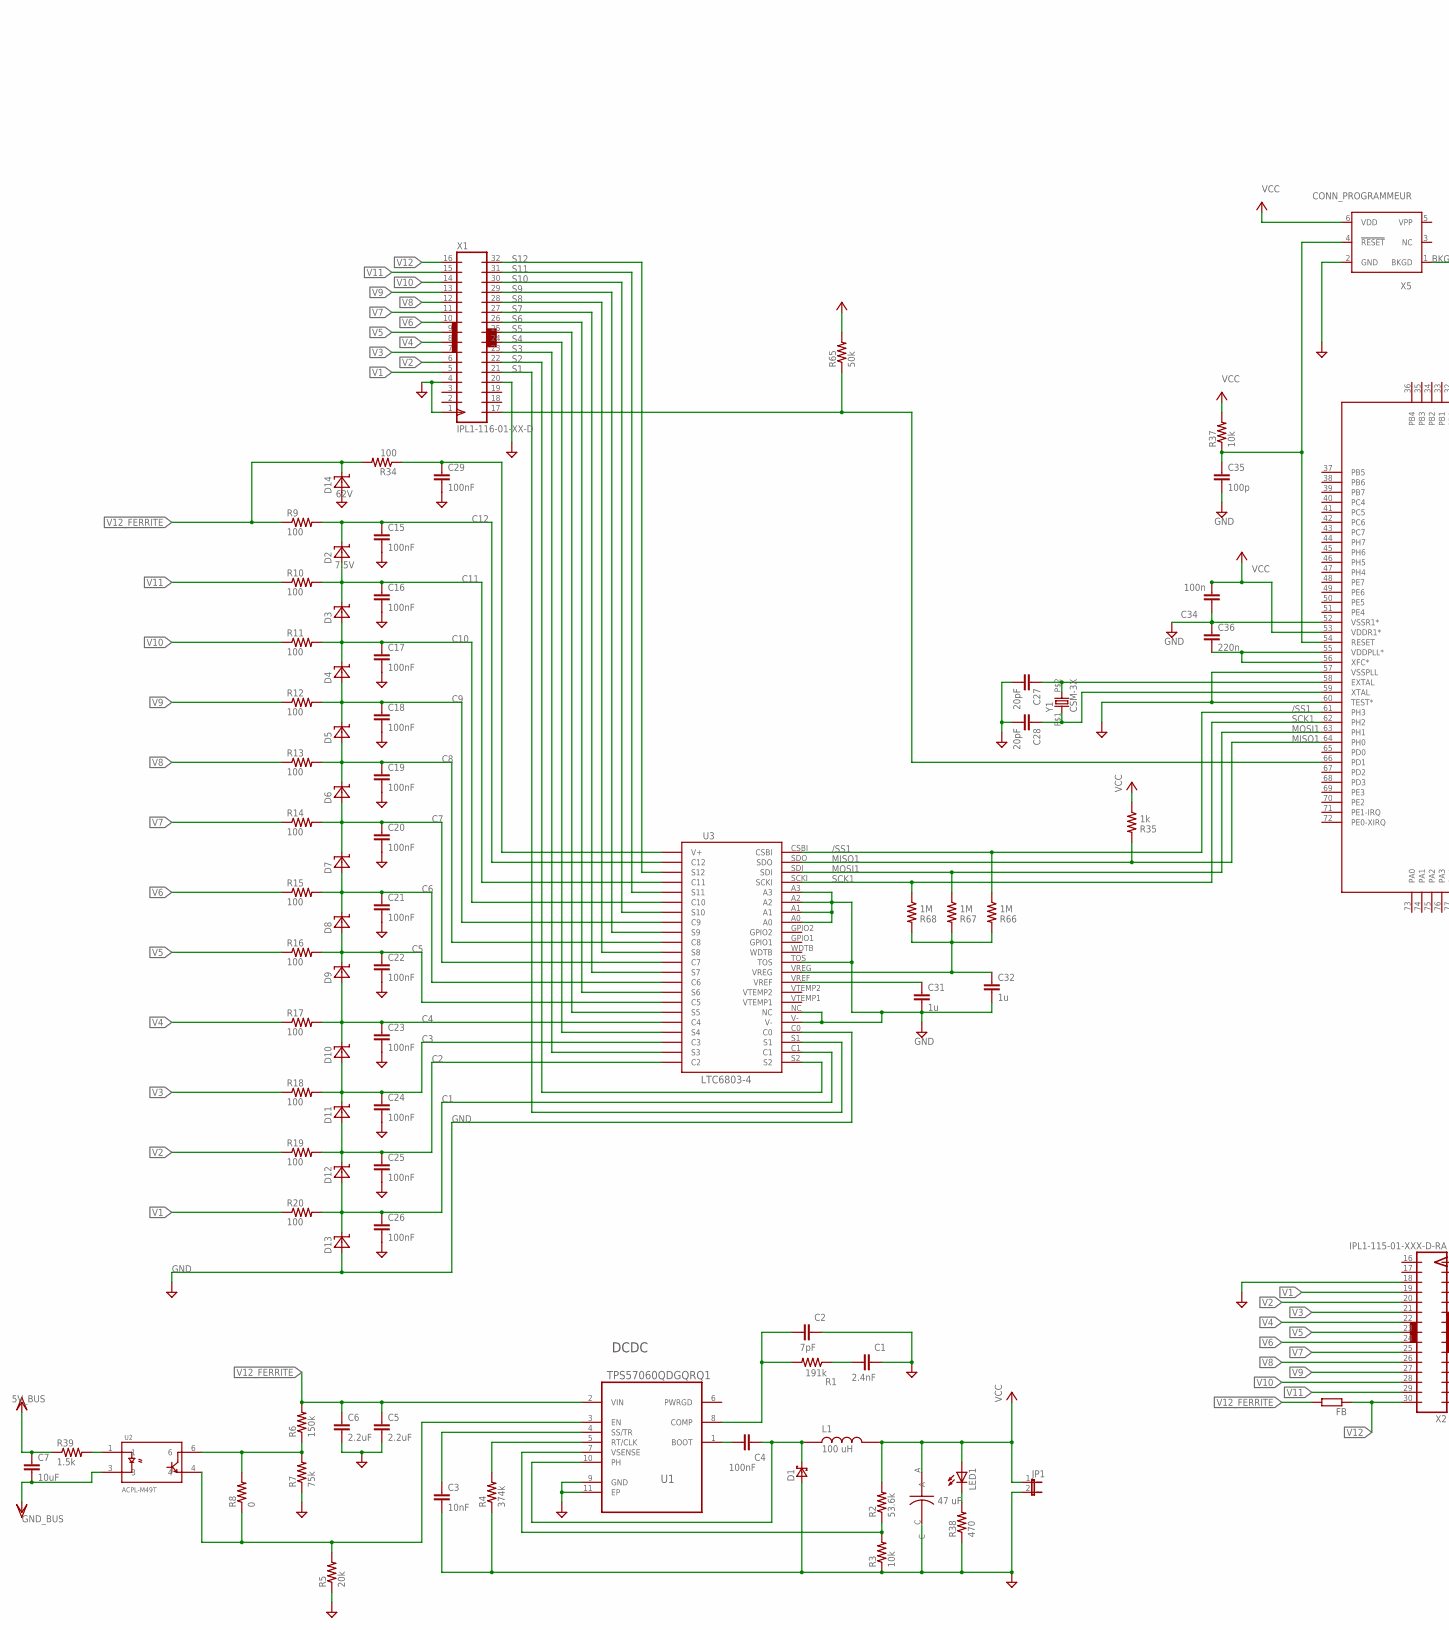
[picture p112: schematic BMS_Slave_v2.1.sch, part in row 1, column 1]

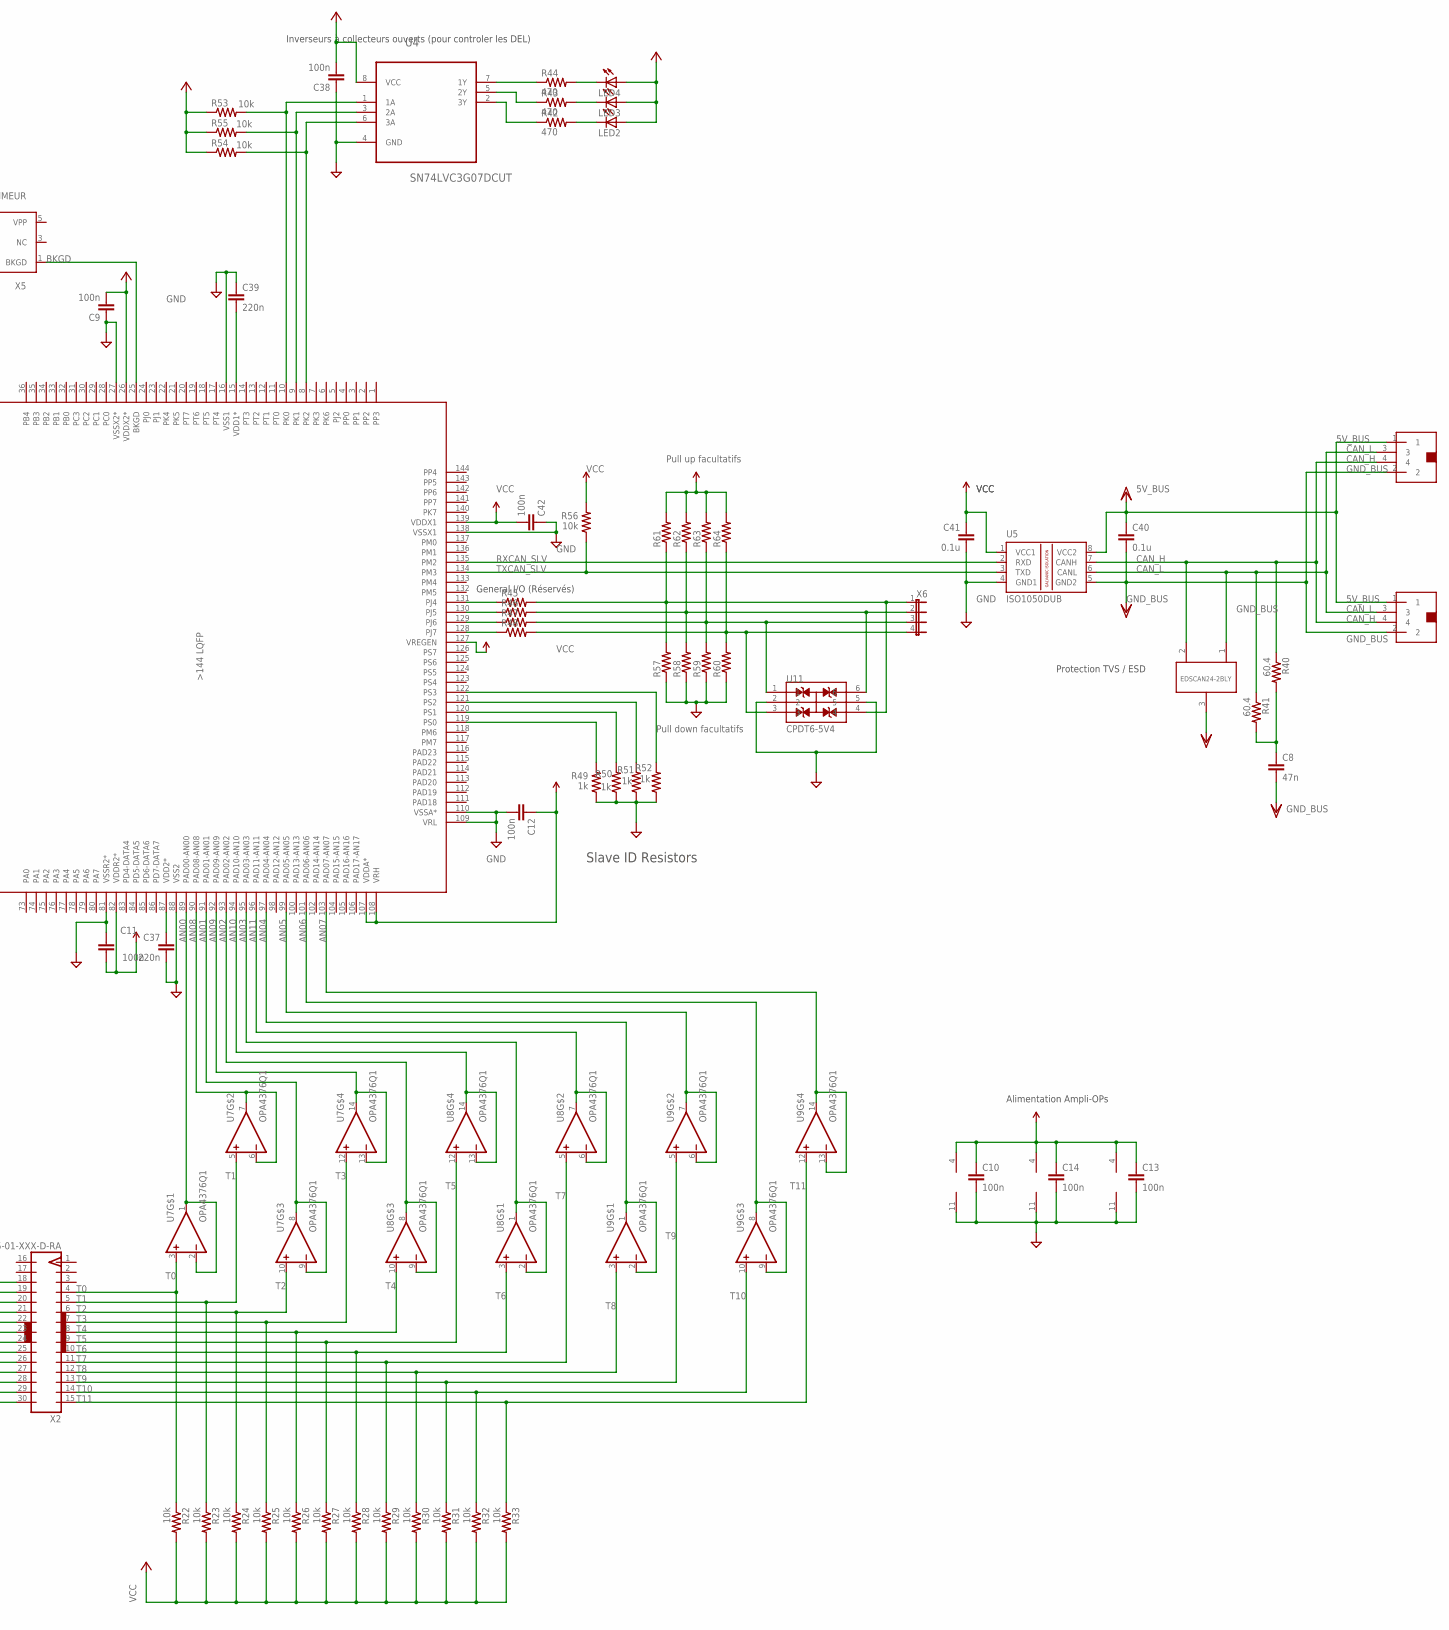
[picture p113: schematic BMS_Slave_v2.1.sch, part in row 1, column 2]

Parts:
C1: 2.4nF; C0603
C2: 7pF; C0603
C3: 10nF; C0603
C4, C15, C16, C17, C18, C19, C20, C21, C22, C23, C24, C25, C26, C29: 100nF; C0603
C5, C6: 2.2uF; C3225
C7: 10uF; C0603
C8: 47n; C0603
C9, C10, C11, C12, C13, C14, C34, C38, C42: 100n; C0603
C27, C28: 20pF; C0603
C31, C32: 1u; C0603
C35: 100p; C0603
C36, C37, C39: 220n; C0603
C40, C41: 0.1u; C0603
C43: 47 uF; APXE_CONDENSATEUR
D1: BYS12-90GENERIC; DO214AC_ZENER
D2, D3, D4, D5, D6, D7, D8, D9, D10, D11, D12, D13, D14: DIODE_ZENER; SOD123
FB: R-EU_R0805; R0805
JP1: JP1E; JP1
L1: 100 uH; VLP8040T-101M
LED1, LED2, LED3, LED4: LED; 1206_LED
R1: 191k; R0603
R2: 53.6k; R0603
R3, R22, R23, R24, R25, R26, R27, R28, R29, R30, R31, R32, R33, R37, R53, R54, R55, R56: 10k; R0603
R4: 374k; R0603
R5: 20k; R0603
R6: 150k; R0603
R7: 75k; R0603
R8: 0; R0603
R9, R10, R11, R12, R13, R14, R15, R16, R17, R18, R19, R20, R34: 100; R0603
R35, R49, R50, R51, R52: 1k; R0603
R38, R42, R43, R44: 470; R0603
R39: 1.5k; R0603
R40, R41: 60.4; R0603
R45, R46, R47, R48, R57, R58, R59, R60, R61, R62, R63, R64: R-US_R0603; R0603
R65: 50k; R0603
R66, R67, R68: 1M; R0603
U1: TPS57060QDGQRQ1; SOP50P490X110-11N
U2: ACPL-M49T; SO5
U3: LTC6803-4
U4: SN74LVC3G07DCUT; SOP50P310X90-8N
U5: ISO1050DUB; DUB-R-PDSO-G8
U6: MC9S12XD-144; SQFP-S-20X20-144
U7, U8, U9: OPA4376Q1; TSSOP-14
U10: EDSCAN24-2BLY; SOT23-3
U11: CPDT6-5V4; SOT23-6
X1: IPL1-116-01-XX-D
X2: IPL1-115-01-XXX-D-RA
X3, X4: IPL1-102-01-XXX-D-RA
X5: CONN_PROGRAMMEUR; CONNECTEUR_PROGRAMMEUR
X6: JP4E; JP4
Y1: CSM-3X

Connections:
1: C2.1, R1.2, U1.8 (COMP)
5V_BUS: C7.1, C40.1, R39.1, U5.8 (VCC2), X3.1, X4.1
/SS1: R66.1, U3.CSBI, U6.61 (PH3)
AN00: U6.89 (PAD00-AN00), U7.1 (OUT), U7.2 (-IN)
AN01: U6.91 (PAD01-AN01), U7.8 (OUT), U7.9 (-IN)
AN02: U6.93 (PAD02-AN02), U8.8 (OUT), U8.9 (-IN)
AN03: U6.95 (PAD03-AN03), U8.1 (OUT), U8.2 (-IN)
AN04: U6.97 (PAD04-AN04), U9.1 (OUT), U9.2 (-IN)
AN05: U6.99 (PAD05-AN05), U9.6 (-IN), U9.7 (OUT)
AN06: U6.101 (PAD06-AN06), U9.8 (OUT), U9.9 (-IN)
AN07: U6.103 (PAD07-AN07), U9.13 (-IN), U9.14 (OUT)
AN08: U6.90 (PAD08-AN08), U7.6 (-IN), U7.7 (OUT)
AN09: U6.92 (PAD09-AN09), U7.13 (-IN), U7.14 (OUT)
AN10: U6.94 (PAD10-AN10), U8.13 (-IN), U8.14 (OUT)
AN11: U6.96 (PAD11-AN11), U8.6 (-IN), U8.7 (OUT)
BKGD: U6.25 (BKGD), X5.1 (BKGD)
C1: C26.1, D12.A, D13.C, R20.2, U3.C1
C2: C25.1, D11.A, D12.C, R19.2, U3.C2
C3: C24.1, D10.A, D11.C, R18.2, U3.C3
C4: C23.1, D9.A, D10.C, R17.2, U3.C4
C5: C22.1, D8.A, D9.C, R16.2, U3.C5
C6: C21.1, D7.A, D8.C, R15.2, U3.C6
C7: C20.1, D6.A, D7.C, R14.2, U3.C7
C8: C19.1, D5.A, D6.C, R13.2, U3.C8
C9: C18.1, D4.A, D5.C, R12.2, U3.C9
C10: C17.1, D3.A, D4.C, R11.2, U3.C10
C11: C16.1, D2.A, D3.C, R10.2, U3.C11
C12: C15.1, D2.C, R9.2, U3.C12
C44: C4.2, D1.C, L1.P$2, U1.10 (PH)
CAN_H: R40.1, U5.7 (CANH), U10.2, X3.4, X4.4
CAN_L: R41.1, U5.6 (CANL), U10.1, X3.3, X4.3
CSS: C3.1, U1.4 (SS/TR)
EXTAL: C27.1, U6.58 (EXTAL), Y1.P$2 (2)
GND: C1.2, C2.2, C3.2, C5.2, C6.2, C9.1, C10.2, C11.1, C12.2, C13.2, C14.2, C15.2, C16.2, C17.2, C18.2, C19.2, C20.2, C21.2, C22.2, C23.2, C24.2, C25.2, C26.2, C27.2, C28.2, C29.2, C31.2, C32.2, C34.1, C35.2, C36.1, C37.2, C38.1, C39.1, C41.2, C42.1, C43.C, D1.A, D13.A, D14.A, JP1.2, R3.1, R4.1, R5.1, R7.1, R38.1, R49.1, R50.1, R51.1, R52.1, R57.1, R58.1, R59.1, R60.1, U1.9 (GND), U1.11 (EP), U3.A0, U3.A1, U3.A2, U3.A3, U3.C0, U3.NC, U3.TOS, U3.V-, U4.4 (GND), U5.4 (GND1), U6.16 (VSS1), U6.27 (VSSX2*), U6.52 (VSSR1*), U6.57 (VSSPLL), U6.60 (TEST*), U6.81 (VSSR2*), U6.88 (VSS2), U6.109 (VRL), U6.110 (VSSA*), U6.138 (VSSX1), U7.11 (V-), U8.11 (V-), U9.11 (V-), U11.2, U11.5, X1.1, X1.4, X1.20, X2.18, X5.2 (GND)
GND_BUS: C7.2, C8.2, C40.2, U2.3, U5.5 (GND2), U10.3, X3.2, X4.2
MISO1: R35.2, U3.SDO, U6.64 (PH0)
MOSI1: R67.1, U3.SDI, U6.63 (PH1)
unnamed: C29.1, R34.1, U3.V+
unnamed: R39.2, U2.1
unnamed: C37.1, U6.87 (VDD2*)
unnamed: C31.1, U3.VREF
unnamed: C32.1, R66.2, R67.2, R68.2, U3.VREG
unnamed: C36.2, U6.55 (VDDPLL*), U6.56 (XFC*)
unnamed: R42.1, U4.2 (3Y)
unnamed: R49.2, U6.119 (PS0)
unnamed: R50.2, U6.120 (PS1)
unnamed: R51.2, U6.121 (PS2)
unnamed: R52.2, U6.122 (PS3)
unnamed: LED2.C, R42.2
unnamed: LED3.C, R43.2
unnamed: LED4.C, R44.2
unnamed: R44.1, U4.7 (1Y)
unnamed: R43.1, U4.5 (2Y)
unnamed: R65.1, U6.66 (PD1), X1.17
unnamed: R45.1, U6.131 (PJ4)
unnamed: C8.1, R40.2, R41.2
unnamed: R46.1, U6.130 (PJ5)
unnamed: R54.2, U4.6 (3A), U6.8 (PK2)
unnamed: R55.2, U4.3 (2A), U6.9 (PK1)
unnamed: R53.2, U4.1 (1A), U6.10 (PK0)
unnamed: C4.1, U1.1 (BOOT)
unnamed: R4.2, U1.5 (RT/CLK)
unnamed: R47.1, U6.129 (PJ6)
unnamed: R2.1, R3.2, U1.7 (VSENSE)
unnamed: LED1.C, R38.2
unnamed: R48.1, U6.128 (PJ7)
unnamed: R5.2, R8.1, U1.3 (EN), U2.4
unnamed: R6.1, R7.2, R8.2, U2.6
unnamed: R45.2, R57.2, R61.1, U11.4, X6.1
unnamed: R46.2, R58.2, R62.1, U11.6, X6.2
unnamed: R47.2, R59.2, R63.1, U11.1, X6.3
unnamed: R48.2, R60.2, R64.1, U11.3, X6.4
R59: C1.1, R1.1
RST: C35.1, R37.1, U6.54 (RESET), X5.4 (!RESET)
RXCAN_SLV: U5.2 (RXD), U6.135 (PM2)
S1: U3.S1, X1.21
S2: U3.S2, X1.22
S3: U3.S3, X1.23
S4: U3.S4, X1.24
S5: U3.S5, X1.25
S6: U3.S6, X1.26
S7: U3.S7, X1.27
S8: U3.S8, X1.28
S9: U3.S9, X1.29
S10: U3.S10, X1.30
S11: U3.S11, X1.31
S12: U3.S12, X1.32
SCK1: R68.1, U3.SCKI, U6.62 (PH2)
T0: R22.1, U7.3 (+IN), X2.4
T1: R23.1, U7.5 (+IN), X2.5
T2: R24.1, U7.10 (+IN), X2.6
T3: R25.1, U7.12 (+IN), X2.7
T4: R26.1, U8.10 (+IN), X2.8
T5: R27.1, U8.12 (+IN), X2.9
T6: R28.1, U8.3 (+IN), X2.10
T7: R29.1, U8.5 (+IN), X2.11
T8: R30.1, U9.3 (+IN), X2.12
T9: R31.1, U9.5 (+IN), X2.13
T10: R32.1, U9.10 (+IN), X2.14
T11: R33.1, U9.12 (+IN), X2.15
TXCAN_SLV: R56.1, U5.3 (TXD), U6.134 (PM3)
V1: R20.1, X1.5, X2.19
V2: R19.1, X1.6, X2.20
V3: R18.1, X1.7, X2.21
V4: R17.1, X1.8, X2.22
V5: R16.1, X1.9, X2.23
V6: R15.1, X1.10, X2.24
V7: R14.1, X1.11, X2.25
V8: R13.1, X1.12, X2.26
V9: R12.1, X1.13, X2.27
V10: R11.1, X1.14, X2.28
V11: R10.1, X1.15, X2.29
V12: FB.1, X1.16, X2.30
V12_FERRITE: C5.1, C6.1, D14.C, FB.2, R6.2, R9.1, R34.2, U1.2 (VIN)
VCC: C9.2, C10.1, C11.2, C12.1, C13.1, C14.1, C34.2, C38.2, C41.1, C42.2, C43.A, JP1.1, L1.P$1, LED1.A, LED2.A, LED3.A, LED4.A, R2.2, R22.2, R23.2, R24.2, R25.2, R26.2, R27.2, R28.2, R29.2, R30.2, R31.2, R32.2, R33.2, R35.1, R37.2, R53.1, R54.1, R55.1, R56.2, R61.2, R62.2, R63.2, R64.2, R65.2, U4.8 (VCC), U5.1 (VCC1), U6.26 (VDDX2*), U6.53 (VDDR1*), U6.82 (VDDR2*), U6.107 (VDDA*), U6.108 (VRH), U6.127 (VREGEN), U6.139 (VDDX1), U7.4 (V+), U8.4 (V+), U9.4 (V+), X5.6 (VDD)
VDD1: C39.2, U6.15 (VDD1*)
XTAL: C28.1, U6.59 (XTAL), Y1.P$1 (1)

Notes on the sheet:
Alimentation Ampli-OPs
Slave ID Resistors
Inverseurs à collecteurs ouverts (pour controler les DEL)
Protection TVS / ESD
DCDC
General I/O (Réservés)
Pull up facultatifs
Pull down facultatifs
62V
7.5V

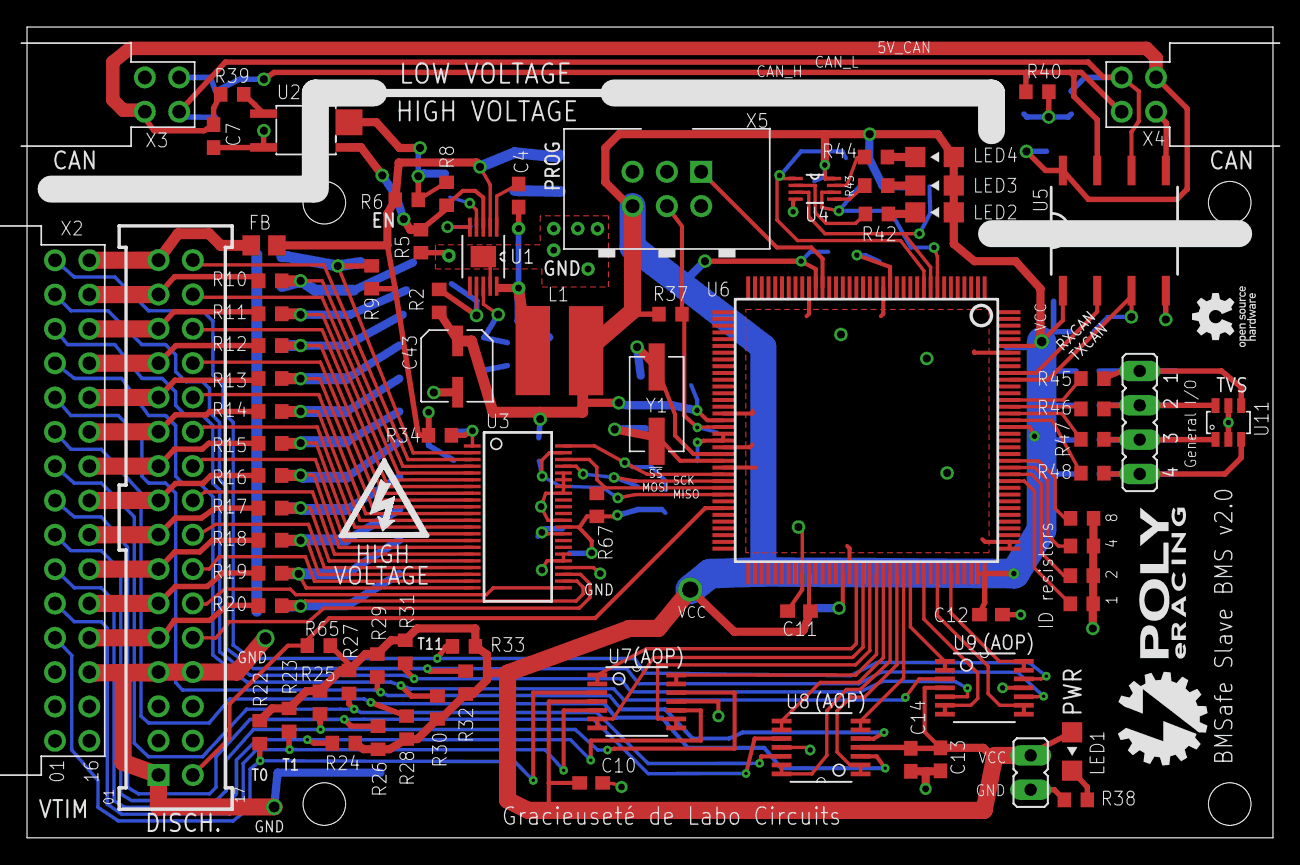
[picture p114: board BMS_Slave_v2.1.brd from above]

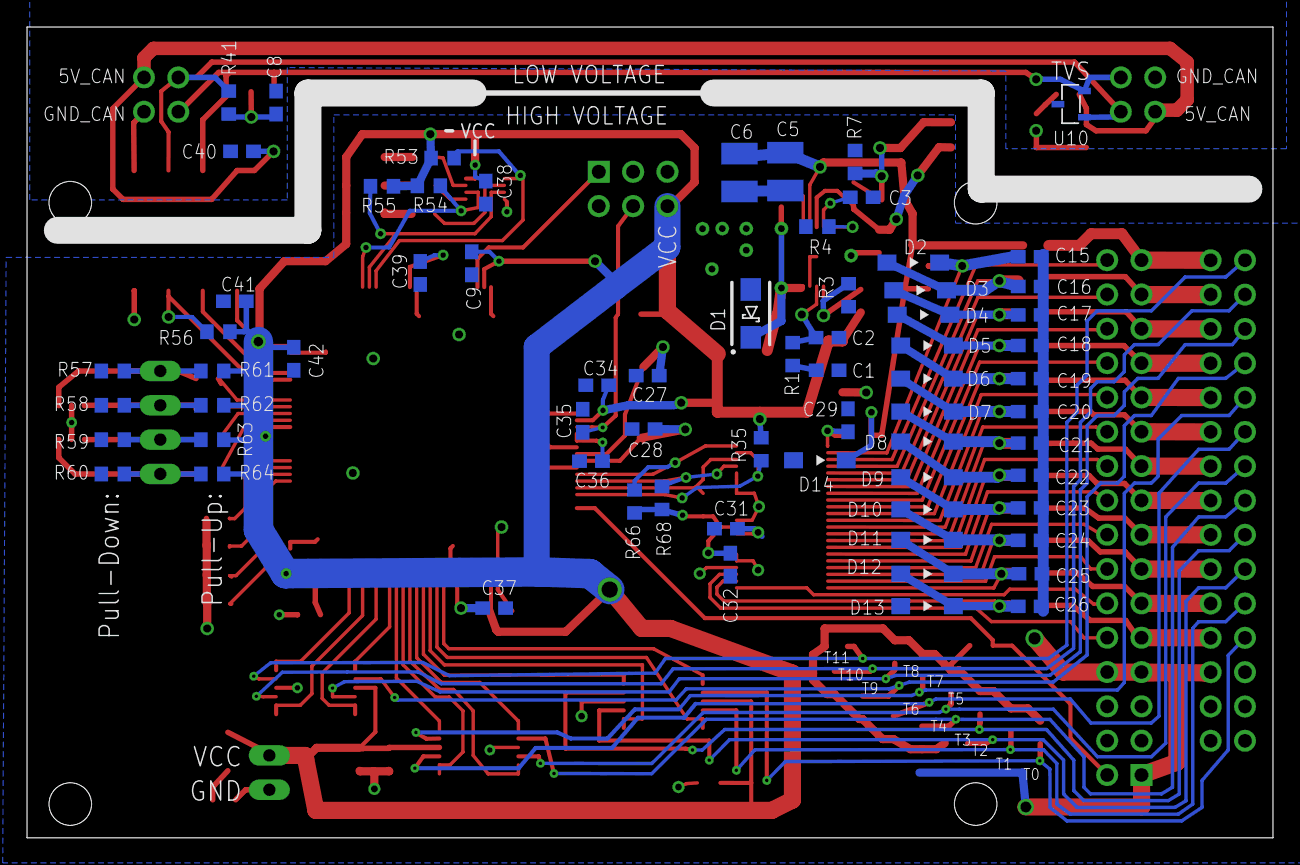
[picture p115: board BMS_Slave_v2.1.brd from below]

Board: 2 copper layers, 92.2 x 60.0 mm, 149 parts (68 on the bottom side), 117 nets.

Other parts of the board:
U$1: LOGO_HV
U$2: LOGO_ERACING
U$3: LOGO_OPEN_HARDWARE
