HarshJain/bmsafe/Slave_v2/Software/Slave_with_xCAN/Sources/temp.c

// *********************************************************
// This file contains temperature related functions and data
// *********************************************************

#include "temp.h"

// Correspondance des entrées ADC avec les températures de chaque cellule
uint8	gTempIndex[12] = {
0,	// AN00 : T0 (Temperature 0 for first cell)
2,	// AN01 : T2
4,	// AN02 : T4
6,	// AN03 : T6
8,	// AN04 : T8
9,	// AN05 : T9
10,	// AN06 : T10
11, // AN07 : T11
1,	// AN08 : T1
3,	// AN09 : T3
5,	// AN10 : T5
7	// AN11 : T7
};


// Values of read ADC Voltage and associated Temperature (1°C/ 10)

// Le calcul de la température est le suivant:
//
// T = B / ln(R/A)
// où A = 0,0986 et B = 3435 et R est la résistance du thermistor
// 
// R = 3000 * V / (5-V)
// où V est la tension mesurée par l'ADC
//
// V = 5*ADC / 1024
// où ADC est la mesure de la tension sur 10 bits
//


// 

// Since we do not have access to mathematical functions, we use a pre-calculated table for voltage to temperature conversion
// convertTempTable : contains the values of temperature corresponding to the ADC value (which is a ratio)
// The table needs to be declared this way, otherwise, there is compilation errors
const int16 convertTempTable[361][2]={
{972,-400},
{971,-395},
{970,-390},
{968,-385},
{967,-380},
{965,-375},
{964,-370},
{962,-365},
{961,-360},
{959,-355},
{958,-350},
{956,-345},
{954,-340},
{953,-335},
{951,-330},
{949,-325},
{947,-320},
{945,-315},
{943,-310},
{942,-305},
{940,-300},
{938,-295},
{936,-290},
{933,-285},
{931,-280},
{929,-275},
{927,-270},
{925,-265},
{923,-260},
{920,-255},
{918,-250},
{915,-245},
{913,-240},
{911,-235},
{908,-230},
{906,-225},
{903,-220},
{900,-215},
{898,-210},
{895,-205},
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

//***************************************************************
// Converts the ADC value read to a corresponding temperature
//***************************************************************
int16 convertTemp(uint16 rawTemp) {
  uint16 i = 0;
  
  if(rawTemp < convertTempTable[360][0]) 		// If temperature is higher than 140°C
    return convertTempTable[360][1];	// Define as 140 °C
  else if(rawTemp > convertTempTable[0][0])	// If temperature is lower than -40°C
	return convertTempTable[0][1];		// Define as -40 °C

  // Otherwise, we browse the table to find the corresponding temperature
  for(i = 0; i < 360; i++)
  {
	if(convertTempTable[i][0] < rawTemp)
		break;
  }
  
  // We return the closer corresponding value
  if(convertTempTable[i-1][0] - rawTemp <= rawTemp - convertTempTable[i][0])  
    return convertTempTable[i-1][1];
  else
	return convertTempTable[i][1];
}
