HarshJain/bmsafe/Slave_v2/Software/Slave_with_xCAN/Sources/InterruptHandlers.h

#ifndef INT_HANDLER_H
#define INT_HANDLER_H

#include "Defines.h"

extern uint32 timeRef_lastMasterMessage;


void HandleTimer_10Hz(void);
void HandleTimer_1kHz(void);

void UpdateTimeDependentFlags(void);



#endif
