HarshJain/bmsafe/Master_v2/Software/Master_with_xCAN/Sources/derivative.h

/*
 * Note: This file is recreated by the project wizard whenever the MCU is
 *       changed and should not be edited by hand
 */

/* Include the derivative-specific header file */
#include <mc9s12xdp512.h>

#pragma LINK_INFO DERIVATIVE "mc9s12xdp512"
