HarshJain/bmsafe/(commit log)

2011-05-03 Version 1.0.0
    [BMSafeMaster.brd, BMSafeMaster.sch, BOMMaster.xls, BOMSlave.xlsx, Cell_Board.brd, Cell_Board.sch]
2011-07-26 I forgot to commit this folder...
    [BMSafeSlave.brd, BMSafeSlave.sch]
2011-10-12 Added battery box CAD. Added material list (cahier de charge de préparation) for module assembly
    [Batterie_asm1.CATProduct, Battery_box_1st_floor.CATPart, Battery_box_2nd_floor.CATPart, Battery_box_90_angle_00.CATPart, Battery_box_90_angle_01.CATPart, Battery_box_90_angle_02.CATPart, Battery_box_90_angle_03.CATPart, Battery_box_90_angle_04.CATPart]
2011-10-12 Added real battery box drawing
2012-03-21 Update du slave en tenant compte des corrections de Maxime Lavigne, je crois.
    [CANSlave.c, main.c]
2012-04-17 Ajout d'une fonction qui gère le relais de décharge, sur le port M.
2012-05-12 Nombreux changements, majoritairement pour la lisibilité du code. Ajout également d'un processus de reprise de communication avec la puce LTC6802-2 advenant une coupure dans le lien SPI.
    Non testé dans cette version:
    - Réception de messages CAN et leur traitement.
2012-05-12 Bon j'ai pas encore le tour avec les commit...
2012-05-30 Ajout d'un message CAN pour l'envoi de la version du firmware. Ajout du mode veille du CPU, ADC et SPI.
2012-05-30 Beaucoup de choses!!! Ménage du code pour ne garder que l'essentiel pour la compétition 2012.
2012-08-31 Version fonctionnelle de la competition FSG 2012
2012-08-31 Version fonctionnelle a la competition FSG 2012. Version utilisant le microcontroleur original, soit le MC9S12XEP100MAL.
2012-08-31 Version qui peut etre programmee sur le microcontroleur MC9S12XDP512. La lecture du courant n'est pas encore fonctionnelle. Il ne manque que quelques changements au code.
2012-12-10 Cleanup général du code.
    * Reformattage du code pour le rendre consistant.
    * Modification de tous les types ambigus pour leur version précise.
2012-12-10 Modification préalable au changement de module can.
    * Ajouter dans CANSlave.c du code pour un traitement
    par message des envois. Pour abstraire tous les
    détails d'envoie que quelqu'un voulant utiliser
    le CAN n'a pas besoin de savoir. (Il n'est pas
    en fonction par contre, j'ai laisser l'ancien
    jusqu'à ce que je puisse tester live le switch).
    * Ajout d'un module de test se servant de l'abstraction
    du module CAN. Les fonctions abstraites novuellement
    créés ont deux définitions différente dépendemment
    de si tu es en débug ou live et en débug, elle sont
    faites pour être rouler sur un ordinateur. Ex: Send
    print en console.
2013-07-25 Version 2.0.0 Utilisee pour la competition a Lincoln en juin 2013
    Adaptation du code au PCB version 2 du BMS master (avec MCU correspondant)
    - Changement du nom des pins dans defines.h et relays.h et la configuration de ces pins
    Ajout d'une fonctionnalite pour ignorer certaines sondes de temperatures qui donnent une lecture erronee
    - main.c : nouveau tableu (gCellIgnoreTemp) contenant le numero des cellules dont la sonde est ignoree
    Ajout d'un delais avant l'activation de l'erreur cellMinVoltage (declenchee inutilement lors de l'acceleration)
    - MCUinit.c : changements dans l'interruption iPIT1_safety_check()
    Ajout du support pour l'affichage 7 segments
    - common.c : fonction display() ajou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
2015-01-25 Master update : - BMS Slave hardware v2 - BMS Slave software v2 - BMS Master hardware v2 (was already on the SVN however) - BMS Master software v2
    This is a major update pushing the last version of hardware and software of the BMS BMSafe project. There have been a lots of improvements in the software, re-organization of functions, clarification of the code, usage of a library for CAN communication, new functionalities, etc. The BMS circuits have been tested and most of their functionalities work properly. There are still certain known bugs to be corrected. We will try to make more updates as we correct these.
    The subsequent updates will mostly be for documentation. There is a big lack in do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
    [AOP_comparison.xlsx, BMS_Slave_v2.1.brd, BMS_Slave_v2.1.sch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]
